eddygrinder/LaRE_LaTeX/chapters/chapter4.tex

% Chapter 4
\chapter{Implementação}
\label{Capítulo4}

\begin{flushright}
\textit{``Do or do not. There is no try.''} \\[0.5em]
--- Master Yoda, \textit{Star Wars - The Empire Strikes Back}
\end{flushright}

Este capítulo aprofunda os aspectos técnicos do LaRE, tomando como referência a arquitetura apresentada na Figura \ref{fig:arquitecturalore}. O desenvolvimento começou pela implementação e desenvolvimento do servidor Flask e página web, sendo que o primeiro circuito a ser implementado e testado foi a Lei de Ohm. O projecto foi evoluindo com a adição dos restantes circuitos que compõem o \acrshort{lare}. Para o desenvolvimento do \textit{software}, utilizou-se o \acrshort{ide} Visual Studio Code\footnote{\url{https://code.visualstudio.com/}}, e o projecto encontra-se alojado no GitHub. O sistema operativo instalado no \gls{RaspberryPI} é uma versão ligeiramente modificada do Arch Linux ARM. Os circuitos que compõem o \acrshort{lare} foram testados e validados individualmente em \textit{breadboards}, antes de se proceder à construção da matriz de placas, como referido na subsecção \ref{sec:matriz}. No Anexo~\ref{AppendixA} encontram-se os esquemas completos de todas as experiências, bem como o desenho das placas que compõem a matriz do \acrshort{lare}. Esta matriz foi organizada em três placas distintas: uma dedicada à experiência da Lei de Ohm, outra às experiências de rectificação e filtragem e uma terceira exclusivamente responsável pelas fontes de alimentação.

\section{Hardware}
\subsection{Relés}
\label{sec:hwreles}
Como já foi referido na subsecção \ref{sec:solucaoproposta}, o \acrshort{lare} é composto por cinco circuitos. A implementação começou com o desenho esquemático e, tal como referido na Secção \ref{sec:reles}, tentou-se, sempre que possível, utilizar os relés \acrshort{spst} no comando das fontes e aparelhos de medida e os relés \acrshort{dpst} no controlo dos componentes, tal como se pode ver no exemplo ilustrado na Figura \ref{fig:relespstdpst}. O relé K4 - \acrshort{spst} - comanda a fonte de alimentação de \SI{5}{\volt} e os relés K1 a K3 - \acrshort{dpst} - comandam os componentes. Os esquemas completos de cada circuito podem ser consultados no Anexo~\ref{AppendixA}.

\begin{figure}[hbtp]
	\centering
	
	\caption{Exemplo de utilização de relés \acrshort{spst} e \acrshort{dpst}}
	\label{fig:relespstdpst}
\end{figure}

\subsection{\textit{Driver} de relés}
\label{sec:driverreles}
Conforme referido na subsecção \ref{sec:driver}, o \gls{RaspberryPI} não tem capacidade para comandar directamente os relés. Para esse efeito, é necessário utilizar um \textit{driver} de relés. A Figura~\ref{fig:diagramablocos2003} apresenta o diagrama simplificado correspondente a um canal de entrada e saída do \textit{driver} \cite{ULN2003}.

\begin{figure}[hbtp]
	\centering
	
	\caption{Diagrama de blocos simplificado do ULN2003A}
	\label{fig:diagramablocos2003}
\end{figure}

O terminal 9, designado por COM, deve ser ligado à tensão de alimentação dos relés - \SI{12}{\volt} no caso dos utilizados neste projecto - e destina-se aos díodos de ``roda livre'', conforme descrito na subsecção~\ref{sec:reles}. As Figuras \ref{fig:comandorelesfull} e \ref{fig:exemplovoltimetro} servem como exemplos práticos ilustrando o funcionamento do procedimento referido na Figura \ref{fig:esquematico74hc595}. Neste exemplo, foi utilizado um relé \acrshort{spst}. No entanto, o funcionamento é idêntico para os relés \acrshort{dpst}, variando apenas a disposição dos pinos.

\begin{figure}[hbtp]
	\centering%
		\centering
		\subfloat[\centering Ligação SN74HC595 - ULN2003A\label{fig:comandorelesfull}]{{ }}%
		\qquad
		\subfloat[\centering Exemplo comando do voltímetro\label{fig:exemplovoltimetro}]{{ }}%
		\caption{Exemplo de uso do SN74HC595 e ULN2003A}%
		\label{fig:ligacao5952003}%
	\end{figure}

\begin{figure}[hbtp]
	\centering
	
	\caption{Envio de \textit{bits} para o registo de deslocamento}
	\label{fig:esquematico74hc595}
\end{figure}

As entradas $I_{1}$ a $I_{7}$ recebem os \textit{bits} enviados pelo \gls{RaspberryPI} através do registo de deslocamento, conforme apresentado na Figura \ref{fig:comandorelesfull}. As saídas $O_{1}$ a $O_{7}$ controlam os relés nos terminais ``3'', enquanto os terminais ``2'' dos relés são ligados aos \SI{12}{\volt}, como ilustrado na Figura \ref{fig:exemplovoltimetro}. No caso específico do exemplo acima descrito, se $I_{5} = \SI{0}{\volt}$, então a saída $O_{5} = \SI{12}{\volt}$, não existindo diferença de potencial entre os terminais ``2'' e ``3'' da bobina do relé ``K5''. Nesse cenário, o relé permanece desactivado. Por outro lado, se $I_{5} = \SI{12}{\volt}$, a saída $O_{5} = \SI{0}{\volt}$, estabelecendo-se uma diferença de potencial nos terminais da bobina, o que provoca a activação do relé. No caso em que a \textit{string} a ser transmitida for maior que 8 \textit{bits}, há a necessidade de usar mais do que um registo de deslocamento. Neste caso, o pino 9 - $Q_{H}'$ - do primeiro registo é ligado ao pino \acrshort{ser} do segundo registo e assim sucessivamente.

\subsection{Registo de deslocamento}
\label{sec:hwregistodeslocamento}
O SN74HC595 é um registo de deslocamento de 8 \textit{bits} do tipo \acrshort{sipo}, cujo funcionamento já foi detalhado na subsecção \ref{sec:registodeslocamento}. Uma \textit{string} de (até 8) \textit{bits} é enviada pelo \gls{RaspberryPI} para o registo através do pino \acrshort{ser}. Na Figura \ref{fig:esquematico74hc595} pode ver-se o diagrama explicativo do processo de envio:

\begin{enumerate}
	\item Pinos \acrshort{oe} e \acrshort{srclr} activados;
	\item Um \textit{bit} ``0'' ou ``1'' é enviado para o pino \acrshort{ser};
	\item \textit{N} impulsos ascendentes no pino \acrshort{srclk} fazem com que o \textit{N bits} sejam enviados para o registo de deslocamento (\textit{N bits} <= 8);
	\item Um impulso ascendente no pino \acrshort{rclk} faz com que os \textit{N bits} sejam enviados para o registo de memória e, por conseguinte, para os relés (através do ULN2003A).
\end{enumerate}

\subsection{Fontes de alimentação}
\label{sec:fontesalimentacao}
O \acrshort{lare} utiliza várias fontes de alimentação, todas passíveis de serem controladas por \textit{software} e neste aspecto tentou-se simplificar/limitar o uso de fontes externas, além das que poderiam ser fornecidas pelo \acrshort{virtualbench}. 

Como pode ser visto na Figura \ref{fig:paineldianteiro} ou na Figura \ref{fig:promenorfontes} com mais pormenor, o \acrshort{virtualbench} possuí três fontes de alimentação (\acrshort{cc} variáveis): \SI{+6}{\volt}, \SI{+25}{\volt} e \SI{-25}{\volt}\footnote{No contexto do \acrshort{lare} a fonte de tensão negativa não é usada.}.

\begin{figure}[hbtp]
	\centering
	
	\caption{Fontes de tensão do \acrshort{virtualbench}}
	\label{fig:promenorfontes}
\end{figure}

Assim, referente ao \acrshort{virtualbench} e à Figura~\ref{fig:promenorfontes}, o \acrshort{lare} utiliza as seguintes fontes de alimentação:
\begin{itemize}
	\item \SI{6}{\volt} (\acrshort{cc}), utilizada na experiência da Lei de Ohm;
	\item \SI{25}{\volt} (\acrshort{cc}), utilizada na alimentação dos relés e dos \textit{drivers}.
\end{itemize}

No entanto, ainda são necessárias mais duas fontes de alimentação, nomeadamente:
\begin{itemize}
	\item \SI{5}{\volt} (\acrshort{cc}), fonte projectada com recurso ao LM317 e com tensão de entrada obtida a partir da fonte de \SI{25}{\volt} - utilizada na alimentação dos registos de deslocamento;
	\item Para o estudo dos circuitos rectificação e filtragem, foi utilizado um transformador \SI{230}{\volt}/\SI{8}{\volt} \acrshort{ca}, disponível em contexto laboratorial e que se mostrou adequado aos objectivos trabalho.
\end{itemize}

\subsubsection{Fonte de tensão \SI{6}{\volt} - variável e fonte de tensão \SI{12}{\volt} - fixa}
\label{sec:fontes6-12}
As fontes de \SI{6}{\volt} e \SI{25}{\volt} são configuradas por \textit{software}. A primeira, utilizada na experiência da Lei de Ohm, varia entre \SI{1}{\volt} e \SI{6}{\volt}, enquanto a segunda é ajustada para fornecer \SI{12}{\volt}. Mais detalhes sobre estas configurações são apresentados na subsecção~\ref{sec:configmedicaoes} e os esquemas consultados no Anexo~\ref{AppendixA}.

\begin{figure}[hbtp]
	\centering%
		\centering
		\subfloat[\centering Introdução\label{fig:schfonte5VB}]{{ }}%
		\qquad
		\subfloat[\centering Controlo\label{fig:schfonte12VB}]{{ }}%
		\caption{Implementação fontes de \SI{6}{\volt} e \SI{12}{\volt}}%
		\label{fig:fontes6-12}%
	\end{figure}

As Figuras \ref{fig:schfonte5VB} e \ref{fig:schfonte12VB} ilustram os exemplos das ligações das respetivas fontes de tensão. Complementando com a Figura \ref{fig:promenorfontes}, o terminal ``1'' do relé $K_{4}$, designado por $5V_{VB}$, está ligado ao terminal de \SI{6}{\volt} do \acrshort{virtualbench}, enquanto a alimentação dos relés -  terminais ``2'' e a alimentação dos \textit{drivers} -  terminais ``9'' , estão ligados ao terminal de \SI{25}{\volt}. 

\subsubsection{Fonte de tensão \SI{5}{\volt} - fixa}
De forma a alimentar os circuitos com \SI{5}{\volt} fixos foi projectada - Figura \ref{fig:esqlm317} e implementada - Figura \ref{fig:impllm317} - uma fonte de alimentação \cite{LM317}.

\begin{figure}[hbtp]
	\centering%
		\centering
		\subfloat[\centering Esquemático\label{fig:esqlm317}]{{ }}%
		\qquad
		\subfloat[\centering Implementação\label{fig:impllm317}]{{ }}%
		\caption{Fonte de \SI{5}{\volt} \textins{LM317}}%
		\label{fig:fonte5V}%
	\end{figure}

Esta fonte teve como base o LM317 e o esquema presente na página 11, Figura 9, do \textit{datasheet} \cite{LM317}. A utilização do LM317 em detrimento, por exemplo, do LM7805 prendeu-se com a disponibilidade do regulador em contexto laboratorial. Este regulador serve perfeitamente os propósitos deste projecto, já que a tensão de saída, regulável, varia entre os \SI{1,25}{\volt} e os \SI{37}{\volt} e a corrente de saída pode ser superior a \SI{1,5}{\ampere}. 

Relativamente aos díodos de protecção, $D_{1}$ e $D_{2}$, representados no esquema da Figura \ref{fig:fonte5V}, em vez de se usarem os díodos 1N4002, por uma questão de disponibilidade dos componentes, usaram-se os díodos 1N4007. Estes díodos pertencem à mesma família de diodos retificadores da série 1N400x. Ambos têm especificações elétricas e mecânicas semelhantes, nomeadamente, a capacidade de suportar correntes directas até \SI{1}{\ampere} - valor suficiente para o nosso projecto que, relembre-se, é limitado pelo \acrshort{virtualbench} a \SI{0,5}{\ampere}. No entanto, a principal diferença entre eles está na tensão inversa máxima que cada modelo é capaz de suportar \cite{1N400x}:

\begin{itemize}
	\item 1N4002: Possui uma tensão inversa máxima de 100 V;
	\item 1N4007: Suporta uma tensão inversa máxima de 1000 V.
\end{itemize}

Estes valores são, pois, mais que suficientes para os níveis de tensão usados.

Sendo assim, para uma tensão de saída de \SI{5}{\volt}, calcularam-se as resistências com base na expressão apresentada do \textit{datasheet}, representada na Equação \ref{eq:calculolm317}: 

\begin{equation} \label{eq:calculolm317}
	V_{O} = V_{REF} (1 + \frac{R_{2}}{R_{1}}) + (I_{ADJ} \times R_{2})
\end{equation}

De notar que, segundo o \textit{datasheet} do LM317 \cite{LM317}, $V_{REF} = \SI{1,25}{\volt}$ e o valor do termo $I_{ADJ} \times R_{2}$ pode ser simplificado. De facto, $I_{ADJ}$ é, tipicamente, \SI{50}{\micro\ampere}, sendo que, para o nosso projecto, o valor escolhido para $R_{2}$ foi de \SI{1}{\kilo\ohm}. Assim, segundo a Equação \ref{eq:simplificação}, tem-se que:

\begin{equation} \label{eq:simplificação}
	V_{ADJ} = I_{ADJ} \times R_{2} = \SI{0,05}{\volt}
\end{equation}

A Equação \ref{eq:calculolm317} fica então reduzida a:

\begin{equation} \label{eq:calculoR1simplificado}
	V_{O} = V_{REF} (1 + \frac{R_{2}}{R_{1}})
\end{equation}

Considerando $V_{O} = \SI{5}{\volt}$, e uma vez que a Equação \ref{eq:calculoR1simplificado} tem duas incógnitas, $R_{1}$ e $R_{2}$, atribuiu-se a $R_{2}$ o valor de \SI{1}{\kilo\ohm}, tal como foi dito anteriormente. Desta forma, obteve-se $R_{1} = \SI{333,33(3)}{\ohm}$, tal como descrito na Equação \ref{eq:calculoR1}: 

\begin{equation} \label{eq:calculoR1}
	\SI{5}{\volt} = 1,25 \times (1 + \frac{1000}{R_{1}}) \Leftrightarrow R_{1} = \SI{333,33(3)}{\ohm}
\end{equation}

O valor da resistência normalizada mais próxima é de \SI{330}{\ohm}. Importa, pois, reverter a Equação \ref{eq:calculoR1simplificado} e confirmar o valor de  $V_{O}$ obtido:

\begin{equation} \label{eq:confirmacaoVout}
	V_{O} = 1,25 \times (1 + \frac{1000}{330}) \Leftrightarrow V_{O} = \SI{5,037(87)}{\volt}
\end{equation}

Portanto, este é um valor perfeitamente aceitável para alimentar os circuitos integrados.

\subsubsection{Fontes de tensão \SI{230}{\volt}/\SI{8}{\volt} CA}
\label{sec:fontealternada}
As experiências respeitantes aos rectificadores e filtros utilizam tensão alternada sinusoidal. Tal como já foi referido anteriormente, tentou-se, sempre que possível, simplificar o uso de fontes externas. 

Na prática e em contexto de sala de aula, a experiência de rectificação de onda completa levanta um problema de massas, se se pretender usar um gerador de sinal. Quer isto dizer que não é possível medir, simultaneamente, os sinais de entrada e saída. Como se pode ver pelo esquema representado na Figura \ref{fig:gerador-massa}, o díodo está curto-circuitado (linha magenta a tracejado, entre os pontos 2 e 3) devido ao facto de as massas serem comuns. 

\begin{figure}[hbtp]
	\centering
	
	\caption{Problema de massa - onda completa}
	\label{fig:gerador-massa}
\end{figure}

A forma de contornar este problema é usar um transformador e, assim, medir a onda de saída com o osciloscópio. Ainda assim, não é possível medir as ondas de entrada e saída \textbf{simultaneamente}, se for esse o objectivo.

No caso do \acrshort{lare}, e com recurso ao uso de relés, é possível controlar a massa dos dois canais do osciloscópio por \textit{software}, tal como representado no esquema simplificado da Figura \ref{fig:ondacompleta-massa} e representar as duas ondas (entrada e saída) na mesma imagem. De referir que, desta forma, seria possível usar o gerador de sinal. No entanto, o uso do transformador justifica-se pelas seguintes razões:
\begin{itemize}
	\item Facilidade e simplicidade em controlar as massas por \textit{software} - três, no caso do uso do gerador de sinal ($CH_{1-}$, $CH_{2-}$ e $VG_{-}$), ou duas, no caso de se usar um transformador ($CH_{1-}$, $CH_{2-}$);
	\item Em contexto laboratorial e de sala de aula, usa-se um transformador para rectificar a onda completa.
\end{itemize}

%No entanto, para o estudo da rectificação da onda completa, tal não foi possível. Enquanto que no rectificador de meia-onda (... e filtros) é possível usar o gerador de sinal do \acrshort{virtualbench} para medir as ondas de entrada e saída simultaneamente, tal não é possível na rectificação de onda completa, devido ao problema das massas e consequente curto-circuito do díodo na ponte rectificadora. 
%Este problema está representado na Figura \ref{fig:ondacompleta-massa}

\begin{figure}[hbtp]
	\centering
	
	\caption{Problema de massa - onda completa [Resolvido]}
	\label{fig:ondacompleta-massa}
\end{figure}

O esquema completo da experiência de rectificação de onda completa pode ser consultado no Anexo~\ref{AppendixA}.

%$CH_{1-}$ e $CH_{2-}$ são as massas do gerador de sinal e osciloscópio (dois canais), respectivamente. É fácil perceber que estando ligados ao mesmo aparelho de medida, neste caso o \acrshort{virtualbench}, as massas dos dois canais do osciloscópio são comuns e, por isso, entre os pontos 2 e 3, o díodo está curto-circuitado. 

%No que concerne à fonte de alimentação \acrshort{ca}, esta foi implementada de forma independente do \acrshort{virtualbench}. \textbf{Falar sobre a fonte de alimentação variável e a fonte de alimentação \acrshort{ca}. Colocar a foto do esquema e explicar como se faz a rectificação, cálculos inclusive. Talvez referir o facto de que depende da qualidade e valores dos transformadores e depois concluir com os valores deste caso, pode-se referir que relativamente à fonte AC, só está disponível a fonte do gerador de sinal do VB e é mais fácil controlar através da fonte externa projectada.}

\subsection{Aparelhos de medida - voltímetro e amperímetro}
\label{sec:aparelhosmedida}

A medição de tensão e corrente são feitas utilizando o multímetro digital - \Acrfull{dmm} - PXI-4072, referenciado na subsecção \ref{sec:visir}, Figura \ref{fig:PXI-4072} e cujo painel frontal está representado na Figura \ref{fig:frontDMM}.

\begin{figure}[hbtp]
	\centering
	
	\caption{Painel frontal Multímetro Digital}
	\label{fig:frontDMM}
\end{figure}

Na Figura \ref{fig:esq_geral_ohm} está representado o esquema simplificado da Lei de Ohm que pode ilustrar o funcionamento dos aparelhos de medida. O ponto C é comum e é controlado pelo relé $K_{7}$. O terminal positivo do voltímetro está ligado ao ponto A, controlado pelo relé $K_{5}$ mas o amperímetro necessita de mais um relé, já que é inserido em série. Neste caso o relé $K_{8}$ funciona como um \textit{bypass} quando se pretende medir tensão e o relé $K{6}$ controla o terminal positivo do amperímetro. 

\begin{figure}[hbtp]
	\centering%
		\centering
		\subfloat[\centering Esquema implementado\label{fig:esq_geral_ohm}]{{ }}%
		\qquad
		\subfloat[\centering Esquema com os relés duplos\label{fig:full_reles}]{{ }}%
		\caption{Esquema completo - Lei de Ohm}%
		\label{fig:}%
	\end{figure}

No entanto, faz-se notar o seguinte: embora os aparelhos de medida sejam independentes, partilham a mesma massa. Esta escolha foi motivada pela indisponibilidade de relés duplos em contexto laboratorial, pelo que se optou por fazer a gestão da forma a que o propósito do projecto fosse atingido e o conceito provado. Na Figura \ref{fig:full_reles} apresenta-se o esquema simplificado, com os relés duplos, adicionados aos aparelhos de medida. 

De referir que, se se pretender expandir o \acrshort{lare} com mais circuitos, é possível utilizar o voltímetro e o amperímetro da forma como estão implementados. A Tabela \ref{Table:exemplomedicaoohm} apresenta o estado dos relés, $K_{5}$ a $K_{8}$ consoante a grandeza que se pretende medir.

\begin{table}[htb]
	\centering
	\caption{Exemplo funcionamento de medição da Lei de Ohm} 
	
	\label{Table:exemplomedicaoohm}
	\begin{tabular}{lcccccccc}
		\toprule
		               & \multicolumn{8}{c}{Estado dos relés}                                                                       \\
		\midrule
		               & $K_{1}$                              & $K_{2}$ & $K_{3}$ & $K_{4}$ & $K_{5}$ & $K_{6}$ & $K_{7}$ & $K_{8}$ \\
		\midrule
		Medir Tensão   & 1                                    & 0       & 0       & 1       & 1       & 0       & 1       & 1       \\
		\midrule
		Medir Corrente & 1                                    & 0       & 0       & 1       & 0       & 1       & 1       & 0       \\
		\bottomrule
	\end{tabular}
\end{table}

\subsection{Experiências}
\label{sec:experiencias}
De forma a permitir um melhor desenvolvimento, foco, organização, detecção e correcção de erros, as experiências foram implementadas de forma independente. As primeiras ideias passavam por, além da Lei de Ohm, implementar o estudo da rectificação de meia e onda completa. Contudo, verificou-se que seria possível incluir uma experiência adicional, dedicada ao estudo prático de filtros passa-alto e passa-baixo, já que estas duas experiências possuem componentes comuns, ampliando, assim, o alcance e a aplicabilidade do \acrshort{lare}.

\begin{comment}
ESTA JUSTIFICAÇÃO DEVERIA FICAR NOUTRO LADO - VERIFICARq!!!!

	\textbf{NOTA: Colocar aqui uma imagem do lare completo, com vista dos conectores??? ou só os conectorres?}
Na Secção \ref{sec:fontesalimentacao}, foram já descritas todas as fontes de alimentação do \acrshort{lare}. Com base na Figura \ref{fig:rectificacao_filtragem_full}, o gerador de sinal é controlado pelo relé duplo $K_{1}$, enquanto o díodo é isolado através do relé duplo $K_{3}$ (representado pelo rectângulo tracejado a vermelho escuro).

No que respeita ao relé $K_{4}$, este seria, eventualmente, dispensável, uma vez que o terminal negativo do gerador de sinal é igualmente controlado por $K_{1}$. No entanto, considerando que os filtros (identificados pelo rectângulo tracejado a cor-de-laranja) são partilhados com os circuitos rectificadores, e prevendo a possibilidade de utilização do gerador de sinal noutra experiência, optou-se, por uma questão de segurança, pelo isolamento completo dos componentes através do relé $K_{4}$.
\end{comment}

\subsubsection{Lei de Ohm}
\label{sec:lei_ohm}
Na Figura~\ref{fig:esq_geral_ohm} apresenta-se o esquema simplificado da implementação prática da Lei de Ohm. O esquema completo pode ser consultado no Anexo~\ref{AppendixA}. A fonte de tensão e os aparelhos de medida foram projectados de forma a serem independentes, tal como é referido na subsecção \ref{sec:aparelhosmedida}, permitindo a sua utilização caso se pretenda expandir o \acrshort{lare} com mais experiências. A fonte de tensão pode ser utilizada desactivando $K_{5}$ e $K7$.
A fonte de tensão e os aparelhos de medida foram projectados de forma a serem independentes, tal como é referido na subsecção \ref{sec:aparelhosmedida}, permitindo a sua utilização caso se pretenda expandir o \acrshort{lare} com mais experiências. A fonte de tensão pode ser utilizada desactivando $K_{5}$ e $K7$. 

O funcionamento do circuito é relativamente simples, sendo que qualquer que seja a resistência a medir, é fechado o respectivo relé - $K_{1}$ ou $K_{2}$ ou $K_{3}$; a fonte $U_{CC}$ é ligada ao circuito através do relé $K_{4}$ e $K_{7}$. A medição da tensão e da corrente faz-se da seguinte forma:

\begin{itemize}
	\item Medição da tensão:
	      \begin{itemize}
		      \item Os relés $K_{5}$ e $K_{8}$ são fechados e $K_{6}$ é aberto (amperímetro desactivado). Desta forma, o voltímetro fica em paralelo com a resistência a medir - entre os pontos A e B.
	      \end{itemize}
	\item Medição da corrente:
	      \begin{itemize}
		      \item Os relés $K_{5}$ e $K_{8}$ são abertos (voltímetro desactivado) e $K_{6}$ é fechado. Desta forma, o amperímetro fica em série com a resistência a medir - entre os pontos B e C.
	      \end{itemize}
\end{itemize}

Como exemplo, se se pretender estudar a Lei de Ohm para a resistência $R_{1}$, os relés seriam activados da forma representada na Tabela \ref{Table:exemplomedicaoohm}:

\subsubsection{Rectificadores e filtros}
\label{sec:rectificadoresfiltros}
Uma vez que a implementação destas duas experiência foi realizada na mesma placa, além de que partilham componentes, optou-se por apresentá-las em conjunto. Na Figura \ref{fig:rectificacao_filtragem_full} estão representados os esquemas simplificados dos circuitos. Nela se podem ver os componentes comuns - rectângulo tracejado laranja - assim como os rectificadores de meia e onda completa - rectângulo tracejado vermelho e verde, respectivamente. Exclusivo dos filtros estão, também, representados, o condensador e resistência, no rectângulo tracejado magenta. O esquema completo encontra-se representado no Anexo \ref{AppendixA}.

\begin{figure}[hbtp]
	\centering
	
	\caption{Esquema completo (simplificado) - rectificadores e filtros}
	\label{fig:rectificacao_filtragem_full}
\end{figure}

Nesta implementação, foi necessário recorrer a dois tipos distintos de tensão de entrada. Como referido na subsecção~\ref{sec:fontesalimentacao}, o circuito de meia onda utiliza o gerador de sinal, mas, devido ao problema de massa já descrito nessa mesma secção, optou-se por utilizar um transformador no circuito de rectificação de onda completa.

Como referido na subsecção \ref{sec:experiencias}, a implementação dos filtros foi realizada após a conclusão dos rectificadores. De forma a permitir a integração desta experiência no circuito já concluído, foi necessário realizar um \textit{bypass} ao díodo $D_{1}$ (assinalado pelo retângulo tracejado a vermelho na Figura \ref{fig:rectificacao_filtragem_full}). Esta alteração permitiu a introdução de uma resistência ($R_{3}$) ou de um condensador ($C_{3}$), consoante a configuração do filtro em estudo. Os esquemas teóricos dos filtros estão representados nas Figuras \ref{fig:filtro_pb} e \ref{fig:filtro_pa}, sendo que $R$ e $C$  correspondem a $R_{3}$ e $C_{3}$. 

Portanto, se se pretender estudar o filtro passa-baixo, é activado o relé $K_{10}$ ($R_{3}$) e o condensador de saída pode ser escolhido entre os $C_{1}$ e $C_{2}$, consoante a configuração que se pretende estudar. O mesmo se aplica ao filtro passa-alto, onde o relé $K_{11}$ ($C_{3}$) é activado e a resistência de saída pode ser escolhida entre os $R_{1}$ e $R_{2}$. Na Tabela \ref{Table:rectificadoresfiltros} e com o auxílio da Figura \ref{fig:rectificacao_filtragem_full} (ou do circuito completo apresentado no Anexo \ref{AppendixA}), pode ver-se o estado dos relés, respeitante a uma combinação possível para cada circuito. 

\begin{table}[htb]
	\centering
	\caption{Exemplo funcionamento do rectificador de meia onda} 
	\label{Table:rectificadoresfiltros}
	\resizebox{\columnwidth}{!}{\begin{tabular}{lccccccccccccc}
		\toprule
		               & \multicolumn{13}{c}{Estado dos relés} \\
		\midrule
		               			& $K_{1}$ & $K_{2}$ & $K_{3}$ & $K_{4}$ & $K_{5}$ & $K_{6}$ & $K_{7}$ & $K_{8}$ & $K_{9}$ & $K_{10}$ & $K_{11}$ & $K_{12}$ & $K_{13}$\\
		\midrule
		Meia Onda      			& 1		 	& 0       	& 1       & 1       & 0       & 1       & 1       & 0 	   & 0     		& 0       & 0       & 0 	   & 0 \\
		\midrule
		Onda Completa  			& 0 	 	& 1       	& 0       & 0       & 1       & 0       & 0       & 1  	   & 1    		& 0       & 0       & 1 	   & 1\\
		\midrule
		Filtro Passa-Alto      	& 1		 	& 0       	& 0       & 1       & 0       & 0       & 1       & 0 	   & 0    		& 1       & 0       & 1 	   & 1\\
		\midrule
		Filtro Passa-Baixo      & 1		 	& 0       	& 0       & 1       & 0       & 0       & 0       & 1 	   & 0    		& 0       & 1       & 1 	   & 1\\
		\bottomrule
	\end{tabular}}
\end{table}

\section{Software}
\label{sec:implementacaosoftware}
Hoje em dia vive-se (n)uma Era em que toda a informação está disponível na ``ponta dos dedos'' e à distância de um \textit{click}. A pesquisa, desenvolvimento e testes dos assuntos mais técnicos revelou-se um processo exigente e, por vezes, moroso. A abundância dos recursos disponíveis colocou o desafio adicional de tentar perceber a dicotomia certo/errado. No apoio a este processo, recorreu-se à Inteligência Artificial, documentação técnica \textit{online}, fóruns de discussão, ajuda pessoal, tutoriais \textit{online} e vídeos no YouTube.

Este projecto de código fonte aberto está dividido em dois repositórios, disponíveis para consulta e modificação sob a licença \acrfull{gpl3} no GitHub: \href{https://github.com/eddygrinder/LaRE}{LaRE} e \href{https://github.com/eddygrinder/LaRE_PICode}{PICode}. Assim, os ficheiros são referenciados relativamente ao respectivo repositório. Ao longo deste capítulo, sempre que se justificar e para fins de clareza, será apresentado o código necessário - em pequenos trechos - de forma a melhor ilustrar os conceitos discutidos. Não se pretende, contudo, abordar exaustivamente todas as instruções ou métodos de configuração do \acrshort{virtualbench}, uma vez que os ficheiros se encontram comentados, sendo possível obter informações adicionais através da sua consulta. 

\subsection{Servidor Flask}
\label{sec:flask}
Na subsecção \ref{sec:back-end} foram já referidas as razões que levaram à escolha do Flask como servidor web. A base para a implementação do Flask teve como base e referência a documentação técnica disponível no \textit{site} do Flask \cite{Flask} e complementada com alguns tutoriais do Youtube \cite{tutorialsiteflask, flaskDigitalOcean}.

\subsubsection{Estrutura base}
O fluxograma apresentado na Figura \ref{fig:funcflask} apresenta o funcionamento geral do servidor Flask.

\begin{figure}[hbtp]
	\centering
	
	\caption{Funcionamento geral Flask}
	\label{fig:funcflask}
\end{figure}

A estrutura de directórios do Flask tem uma base pré-definida que não é necessariamente rígida e pode ser adaptada consoante os requisitos do projecto \cite{Flask}. No caso do \acrshort{lare} a estrutura ficou organizada da forma como se mostra na Figura \ref{fig:estruturapastas}.

\begin{figure}[hbtp]
	\centering
	
	\caption{Estrutura de directórios - Flask}
	\label{fig:estruturapastas}
\end{figure}

A raiz do projecto é o directório ``\textit{webserver}'' e nele estão contidos o ficheiro principal, assim como outros directórios e ficheiros de configuração essenciais:
\begin{itemize}
	\item \textit{main.py}: O ficheiro principal do aplicativo que inicializa e configura o Flask;
	\item \textit{requirements.txt}: Uma lista de dependências do projecto que podem ser instaladas usando \gls{pip};
	\item \textit{static/}: Este directório contém os ficheiros estáticos como \acrshort{css}, JavaScript e as imagens usadas em toda a aplicação;
	\item \textit{templates/}: Contém os modelos \acrshort{html} usado para renderizar as visualizações;
	\item \textit{instance/}: Directório para armazenar ficheiros de configuração ou ficheiros que mudam em tempo de execução, específicos da cada instância, por exemplo, ficheiros da base de dados.
\end{itemize}

Dentro da raiz, criou-se o directório \textit{website} onde se incluiu os ficheiros respeitantes ao funcionamento do \textit{site}. Dele constam os já descritos \textit{templates}, \textit{static} e ainda os seguintes ficheiros:

\begin{itemize}
	\item \textit{\_\_init\_\_.py}: Inicializa o Flask e define as configurações. Este ficheiro dentro da directoria \textit{website} faz com que esta seja tratada como um pacote Python. Isto quer dizer que a directoria pode ser importada e tudo o que estiver dentro é executado automaticamente;
	\item \textit{views.py}: Contém as funções de visualização para o tratamento de pedidos \acrfull{http};
	\item \textit{models.py}: Define os modelos de dados para a aplicação;
	\item \textit{auth.py}: Este ficheiro é responsável por lidar com a autenticação e autorização de utilizadores, pode incluir funções e rotas que permitem aos utilizadores registarem-se, fazer \textit{login} e fazer \textit{logout}.
\end{itemize}

\subsubsection{Rotas}
As aplicações web modernas utilizam \acrshort{url} amigáveis para ajudar os utilizadores a memorizar e utilizar o nome para voltar a visitar directamente uma página.

No Flask utiliza-se o \textit{decorator} \textit{\textbf{route()}} para associar uma função a um \acrshort{url}, tal como pode ser visto na Listagem \ref{lst:decoradorroute}.

\begin{minipage}{0.9\linewidth}
	\begin{lstlisting}[language=Python, caption=\textit{Decorator} \textit{route()} - \textit{views.py}, label=lst:decoradorroute]
@views.route("/ohm", methods=['GET', 'POST'])
@login_required
def pagina_seguinte():
    return render_template("ohm.html", user=current_user)
\end{lstlisting}
\end{minipage}

O \textit{decorator} \textit{\textbf{route}} define a rota correspondente à \acrshort{url} Ohm, a qual aceita pedidos \acrshort{http} de métodos GET e POST. Adicionalmente, o \textit{decorator} \textit{\textbf{login}} assegura que apenas utilizadores autenticados podem aceder a esta rota; caso contrário, o utilizador será redirecionado para a página de autenticação. Sempre que esta rota é invocada, a função \textbf{pagina\_seguinte()} é executada. Por fim, a última linha da função invoca o \textit{template} \textbf{ohm.html} e passa-lhe o objecto \textbf{current\_user}, permitindo personalizar a página com os dados do utilizador autenticado.

Para construir um \acrshort{url} para uma função específica, usa-se a função \textbf{url\_for()}. Esta função aceita o nome da função como seu primeiro argumento e qualquer número de argumentos de palavras-chave, cada um correspondendo a uma parte variável da regra de \acrshort{url}, tal como pode ser visto na Listagem \ref{lst:urlfor}.

\begin{minipage}{0.9\linewidth}
	\begin{lstlisting}[language=Python, caption=Contrução de \textit{url} - \textit{auth.py}, label=lst:urlfor]
(...)
if user:
    if check_password_hash(user.password, password):
        flash('Logged in successfully!', category='success')
        login_user(user, remember=True)
        return redirect(url_for('views.home'))
(...)
\end{lstlisting}
\end{minipage}

Isto quer dizer que o Flask gera a \acrshort{url} correspondente à função \textbf{home()} definida no ficheiro \textbf{views.py} dentro da \textit{Blueprint} \textit{views}. Quando usada dentro de \textit{\textbf{redirect}}, redireciona o utilizador para essa \acrshort{url}. No Flask, os \textit{decorators} são utilizados para associar funcionalidades adicionais a funções que representam rotas. Um \textit{decorator} é uma construção da linguagem Python que permite modificar o comportamento de uma função sem alterar o seu conteúdo. Ao utilizar @route, @login\_required e outros \textit{decorators}, o Flask cria uma camada adicional de lógica que é aplicada automaticamente antes (ou depois) da execução da função ``decorada''.

\subsubsection{\textit{Blueprints}}
O Flask usa um conceito de \textit{blueprints} para criar componentes de aplicações e suportar padrões comuns dentro de uma aplicação ou entre aplicações. As \textit{blueprints} podem simplificar muito o funcionamento de grandes aplicações e fornecer um meio central para que as extensões do Flask registem operações em aplicações. As \textit{blueprints} permitem organizar a aplicação em partes menores e de mais fácil gestão. O conceito básico das \textit{blueprints} é que registam as operações a executar quando são integrados numa aplicação. O Flask associa funções de vista (\textit{views}) a \textit{blueprints} quando processa pedidos e gera \acrshort{url} entre diferentes pontos de acesso. Na Listagem~\ref{lst:blueprintviews} e Listagem~\ref{lst:blueprintauth} podem ver-se as duas \textit{blueprints} definidas no caso da implementação do \acrshort{lare}.

\begin{center}
	\begin{minipage}{0.7\linewidth}
		\begin{lstlisting}[language=Python, caption=\textit{Blueprint views} - \textit{views.py}, label=lst:blueprintviews]
views = Blueprint('views', __name__)
\end{lstlisting}
	\end{minipage}
\end{center}

\begin{center}
	\begin{minipage}{0.7\linewidth}
		\begin{lstlisting}[language=Python, caption=\textit{Blueprint auth} - \textit{auth.py}, label=lst:blueprintauth]
auth = Blueprint('auth', __name__)
\end{lstlisting}
	\end{minipage}
\end{center}

Ambas as \textit{blueprints} são registadas no ficheiro \textit{\_\_init\_\_.py}, como se pode verificar na Listagem \ref{lst:initreg}

\begin{center}
	\begin{minipage}{0.7\linewidth}
		\begin{lstlisting}[language=Python, caption=Registo das \textit{blueprints} - \textit{\_\_init\_\_.py}, label=lst:initreg]
app.register_blueprint(views, url_prefix='/')
app.register_blueprint(auth, url_prefix='/')
\end{lstlisting}
	\end{minipage}
\end{center}

Isto quer dizer que, ao registar a \textit{blueprint} com o prefixo ``/'', os \acrshort{url} serão acessíveis através da raiz da aplicação.

\subsubsection{Pedidos}
A capacidade de uma aplicação web em responder a solicitações de dados do cliente é um requisito essencial. No Flask esta informação é fornecida pelo objecto global \textit{\textbf{request}}. Este objecto contém todos os detalhes da solicitação, como os métodos \acrshort{http} usados GET, POST, etc.), os \textit{headers} os \textit{cookies} ou o corpo da requisição. O método de requisição pode ser determinado através do atributo \textit{\textbf{method}}. Para aceder aos dados de um formulário (transmitidos numa requisição POST ou PUT), utiliza-se o atributo \textit{\textbf{form}}, tal como descrito no ficheiro \textbf{auth.py}. Quando se adiciona um ponto de interrogação (?) seguido de pares chave-valor (\textit{key}=\textit{value}) no final de um \acrshort{url}, está a enviar-se dados adicionais ao servidor, chamados de \textbf{parâmetros do \acrshort{url}}, como se pode ver na Listagem \ref{lst:paramurl}.

\begin{minipage}{0.9\linewidth}
	\begin{lstlisting}[language=Html, caption=Exemplo argumentos passados ao servidor - ohm.html, label=lst:paramurl]
const url = `/config_VirtualBench?parameter=${parameter}&Vcc=${Vcc}&R=${Resistance}`;
\end{lstlisting}
\end{minipage}

Como referido na subsecção~\ref{sec:jinja2}, a renderização das páginas \acrshort{html} é realizada através do motor Jinja. No caso específico do \acrshort{lare}, o Flask procura os modelos a renderizar na pasta \textit{templates}, conforme ilustrado na Figura~\ref{fig:estruturapastas}. Na página oficial do Flask é recomendado que se aceda aos parâmetros do \acrshort{url} com \textit{\textbf{get}} ou capturando o \textit{\textbf{KeyError}}, uma vez que os utilizadores podem alterar o \acrshort{url} e, nesse caso, apresentar uma página \textit{400 bad request} não é de fácil interpretação.

\subsubsection{Base de dados}
A aplicação desenvolvida usa uma base de dados e autenticação de utilizador. A ligação com a base de dados é aberta no início do pedido e é obtida a informação do utilizador. No final do pedido, a ligação com a base de dados é fechada. 

No contexto da documentação do Flask e implementação de uma base de dados, são apresentadas duas alternativas: SQLite 3 e SQLAlchemy. Tal como sugerido na documentação, usou-se a extensão Flask-SQLAlchemy, descrita no ficheiro \textit{\textunderscore\textunderscore init.py\textunderscore\textunderscore}.

\subsubsection{Autenticação}
A segurança da aplicação é assegurada através das funcionalidades de \textit{login} e \textit{logout}, implementadas no ficheiro \textit{auth.py}. Para esse fim, foi instalada a extensão \textit{flask-login} que simplifica a gestão de sessões de utilizadores ao permitir manter o estado autenticado entre diferentes requisições. Esta ferramenta disponibiliza métodos como \textbf{\textit{login\textunderscore user()}}, \textbf{\textit{logout\textunderscore user()}} e \textbf{\textit{current\textunderscore user}}, que simplificam a verificação e controlo do estado de autenticação. O processo de registo envolve a recolha de credenciais, como nome de utilizador e senha, garantindo o armazenamento seguro da senha através de \textbf{\textit{hashing}} com \textbf{\textit{generate\textunderscore password\textunderscore hash}}. No \textit{login}, a aplicação verifica as credenciais fornecidas, compara a senha inserida com a armazenada usando \textbf{\textit{check\textunderscore password\textunderscore hash}} e, se for válida, inicia a sessão do utilizador. Além disso, certas rotas são protegidas para garantir que apenas utilizadores autenticados as possam aceder, utilizando o \textit{decorator} \textbf{\textit{@login\textunderscore required}}, que redireciona utilizadores não autenticados para a página de \textit{login}. A gestão de sessões é feita através de \textit{cookies} seguros, permitindo ainda a funcionalidade de lembrar a sessão entre reinícios do navegador, caso seja activado o parâmetro \textbf{\textit{remember=True}} no \textbf{\textit{login\textunderscore user}}. 

Devido à complexidade da implementação de uma verificação por \textit{email}, a aplicação restringe-se à autenticação baseada apenas no nome de utilizador e senha. A inclusão desse mecanismo exigiria um serviço de envio de \textit{emails} e a gestão de \textit{tokens} de confirmação.

\subsection{Arquitectura de comunicação}
\label{sec:comunicacao}
Nesta subssecção, o foco será analisar a comunicação (e troca de parâmetros) entre os diversos tipos de ficheiros. Na Figura \ref{fig:diagramasimplificado} é apresentado o diagrama simplificado que ilustra o funcionamento geral deste tipo de comunicação. 

\begin{figure}[hbtp]
	\centering
	
	\caption{Diagrama de comunicação simplificado}
	\label{fig:diagramasimplificado}
\end{figure}

A arquitectura do sistema é composta por múltiplos ficheiros que comunicam entre si, englobando a troca de parâmetros. O critério utilizado foi o de tornar o ficheiro \textit{views.py} o mais leve e simples possível, mantendo-se o comando e controlo dos dispostivos em ficheiros separados.

Como mencionado na subsecção \ref{sec:flask}, a estrutura de directórios do Flask possui uma base pré-definida, mas suficientemente flexível para ser adaptada conforme os requisitos específicos do projecto, como ilustrado na Figura \ref{fig:estruturapastas}. De uma forma geral, foram criados ficheiros específicos para cada experiência, adoptando o critério de evitar uma excessiva modularização do código. Embora esta prática ofereça vantagens, também apresenta as suas desvantagens - devido à fragmentação excessiva - já que pode tornar a compreensão e manutenção do código mais complexa.

Os seguintes ficheiros foram criados e associados às respectivas experiências:
\\[1em]
\textbf{Específicos}
\begin{itemize}
	\item \textit{config.py} - Lei de Ohm;
	\item \textit{mixed\_signal\_oscilloscope.py} - Rectificadores/Filtros;
	\item \textins{ohm, meiaonda, ondacompleta, passaalto, passabaixo}.html - Visualização.
\end{itemize}

\textbf{Comuns}
\begin{itemize}
	\item \textit{views.py} - parte central da aplicação, pois nele estão definidas todas as rotas Flask. Quer isto dizer que, cada rota representa uma funcionalidade ou página web específica e qualquer troca de dados ou argumentos entre ficheiros e/ou \textit{scripts}, passa obrigatoriamente por este ficheiro. Sendo assim, tentou-se, sempre que possível, reduzir o código ao estritamente necessário;
	\item \textit{configRelays.py} - ficheiro responsável pelo envio da \textit{string} para o \gls{RaspberryPI}.
	\item \textins{login, base, sign\_up}.html - páginas de autenticação e registo de utilizadores.
\end{itemize}

\subsubsection{Comunicação entre ficheiros}
\label{sec:comunicacaoentrefich}
A comunicação entre as páginas \acrshort{html} e o ficheiro Python\footnote{Pode-se, neste caso, reduzir a comunicação ao caso mais geral de troca de informação entre ficheiros \acrshort{html} e Python, já que, no fundo, o ficheiro \textit{views.py} está escrito em Python.} é feita nos dois sentidos - setas amarelas - já que os utilizadores enviam os parâmetros específicos de cada experiência e os resultados são apresentados nas páginas. 

A Listagem \ref{lst:htmlpy} ilustra a forma como os parâmetros são enviados da página \acrshort{html} para o ficheiro Python, através de uma \textit{query string}.

\begin{minipage}{0.9\linewidth}
	\begin{lstlisting}[language=html, escapechar=|, caption=Envio de parâmetros \acrshort{html} $\rightarrow$ \textit{views.py}, label=lst:htmlpy]
	const url = `/config_VirtualBench?variavel_1=${parametro_1}&variavel_2=${parametro_2}&variavel_3=${parametro_3}`; |\label{line:parametros}|
	\end{lstlisting}
\end{minipage}

Do lado do servidor, o Flask disponibiliza o objecto \textit{request}, a partir do qual os parâmetros enviados por \acrshort{url} podem ser acedidos através da função \textit{request.args.get()}, como representado na Listagem~\ref{lst:metodorequest}.

\begin{minipage}{0.9\linewidth}
	\begin{lstlisting}[language=python, escapechar=|, caption=Recepção de parâmetros, label=lst:metodorequest]
		Vcc = request.args.get('parametro_1', 0, int)  |\label{line:vccrequest}|
	\end{lstlisting}
\end{minipage}

O envio de parâmetros do ficheiro Python para as páginas \acrshort{html} é feito em \acrfull{json}, usando a instrução definida na Listagem \ref{lst:returnjson}.

\begin{minipage}{0.9\linewidth}
	\begin{lstlisting}[language=python, escapechar=|, caption=Envio de parâmetros \textit{views.py} $\rightarrow$ \acrshort{html}, label=lst:returnjson]
		return jsonify({'measurement_result': measurement_result})
	\end{lstlisting}
\end{minipage}

Do lado das páginas \acrshort{html} a recepção do resultado é feita através do método \textit{fetch()}, como se pode ver na Listagem \ref{lst:recepcaojson}.

\begin{minipage}{0.9\linewidth}
	\begin{lstlisting}[language=html, escapechar=|, caption=Recepção de parâmetros, label=lst:recepcaojson]
		fetch(url)
		.then((response) => response.json())
		// Aceder a variavel measurement_result
		.then((data) => {
		  document.getElementById("current-measure").innerHTML = 
		  	data.measurement_result + " mA";	
		\end{lstlisting}
\end{minipage}

As setas verdes representam a comunicação entre dois ficheiros Python. O processo é bastante simples, bastando para isso, importar o ficheiro que contém a função que se pretende chamar. A Lista \ref{lst:pypy} ilustra a forma como se importa um ficheiro Python e a chamada da respectiva função com o parâmetro a passar.

\begin{minipage}{0.9\linewidth}
	\begin{lstlisting}[language=python, escapechar=|, caption=Comunicação Python - Python, label=lst:pypy]
		from ctrl_hardware import configRelays, configVB, mixed_signal_oscilloscope |\label{line:ficheiros}|
		configRelays.config_relays_ohm(Resistance, measure_parameter) |\label{line:trueparameter}|
	\end{lstlisting}
\end{minipage}

No entanto, o processo de medição na experiência da Lei de Ohm possui características específicas que justificam uma explicação detalhada. A Figura~\ref{fig:processoleituraUI} ilustra o procedimento de leitura das medições de tensão e corrente.

\begin{figure}[hbtp]
	\centering
	
	\caption{Processo de leitura das medições de tensão e corrente}
	\label{fig:processoleituraUI}
\end{figure}

As setas a verde e vermelho representam o fluxo do processo iniciado pelo utilizador ao solicitar uma medição. Este ciclo repete-se cinco vezes para cada grandeza (tensão e corrente). No entanto, como o ficheiro \textit{configVB.py} é executado de forma independente em cada chamada, num total de dez execuções, os valores medidos não são retidos entre invocações sucessivas. Para contornar esta limitação e garantir a persistência das medições ao longo das múltiplas chamadas à \acrshort{api}, sem recorrer a mecanismos clássicos de persistência, como ficheiros \textit{.json}, \textit{.csv} ou bases de dados locais — os quais implicariam operações adicionais de escrita e leitura no sistema de ficheiros — foi desenvolvido um módulo auxiliar em Python, implementado no ficheiro \textit{store\_ps\_dmm.py}. Este módulo utiliza variáveis globais como mecanismo de armazenamento em memória. Os valores de tensão e corrente são armazenados num \textit{array} através da função \textit{np.append}, da biblioteca NumPy \cite{NumPy}. Dado que o servidor Flask se mantém activo durante todo o processo de medição, as variáveis globais permanecem acessíveis em memória entre chamadas à \acrshort{api}. Esta abordagem simplifica a gestão do estado da aplicação numa fase inicial de desenvolvimento, sendo eficaz enquanto o processo da aplicação não for reiniciado.

\subsubsection{Comunicação com Raspberry PI}
\label{sec:raspberrypi}
Do lado do \gls{RaspberryPI}, embora de uma forma mais simples, também se usou a premissa de modularização do código, tal como referido na subsecção \ref{sec:comunicacao}. Este ficou dividido em dois ficheiros:
\begin{itemize}
	\item \textit{receive.py} - recebe a \textit{string};
	\item \textit{shift\textunderscore register.py} - responsável por activar os relés.
\end{itemize}

A comunicação com o \gls{RaspberryPI} é estabelecida através de \textit{sockets}, um método já descrito na Secção~\ref{sec:arquitectura}. Após a configuração e teste dos parâmetros, uma \textit{string} representando o número de relés a activar - 8 \textit{bits} ou 13 \textit{bits}, dependendo dos circuitos - é enviada através da interface de rede. A implementação do mecanismo de comunicação encontra-se no ficheiro \textit{configRelays.py}, na função \textit{config\textunderscore Relays}.

Sendo assim, o ficheiro \textit{receive.py} é executado inicialmente e aguarda pelo envio da \textit{string}. De referir que, embora o \textit{socket} esteja configurado em \textit{blocking mode} - quer isto dizer que o cliente ficará bloqueado na Linha~\ref{line:blockmode}, da Listagem \ref{lst:socketblock}, esperando uma resposta do servidor \cite{Sockets} (acontece enquanto a \textit{string} não for enviada) - optou-se por enviar uma confirmação do servidor ao cliente. Não sendo estritamente necessário, foi adicionada como auxílio à depuração.

\begin{minipage}{0.9\linewidth}
	\begin{lstlisting}[language=Python,escapechar=|, caption=\textit{Block Mode \textins{Sockets} configRelays.py}, label=lst:socketblock]
		# Espera pela resposta do servidor
        while True:
            data = s.recv(1024) |\label{line:blockmode}|
            if not data:
                break
            response = data.decode()
            if response == 'True':  # Espera por uma confirmacao especifica do servidor
                print("Confirmacao recebida do servidor:", response)
                break
	\end{lstlisting}
\end{minipage}

O passo final é a activação dos relés, realizada no ficheiro \textit{shift\textunderscore register.py}, função \textit{commandRelays}. O procedimento foi descrito na subsecção \ref{sec:hwregistodeslocamento}, sendo que os modos de funcionamento estão representados na Tabela \ref{Table:funcSN74HC595}.

Para que as experiências funcionem correctamente, todos os relés devem ser activados em simultâneo. Para isso, a sequência de controlo dos relés é representada por uma \textit{string} composta por 8 ou 13 dígitos binários, conforme as experiências, em que cada carácter indica o estado (ligado ou desligado) de um relé. Esta \textit{string} é posteriormente convertida para um número inteiro, sobre o qual é realizada uma operação de \textit{and bit} a \textit{bit}. Cada um dos \textit{bits} resultantes é, então, enviado sequencialmente para o registo de deslocamento, numa configuração \acrshort{sipo}, conforme ilustrado na Listagem \ref{lst:andbitabit}. Assim que os 8 ou 13 \textit{bits} forem transferidos para o registo, a saída paralela será activada, resultando na activação dos relés.

\begin{minipage}{0.9\linewidth}
	\begin{lstlisting}[language=Python,escapechar=|, caption=\textit{And bit} \textit{bit shift\textunderscore register.py}, label=lst:andbitabit]
		for i in range(n_bits):
			binaryShift = binaryString & 1
			if binaryShift == 1:
				WriteReg (ON, SERCLK_pin_ctrl, SER_pin_ctrl, WaitTimeSR)
			else:
				WriteReg(OFF, SERCLK_pin_ctrl, SER_pin_ctrl, WaitTimeSR)
			binaryString = binaryString >> 1
		OutputReg(RCLK_pin_ctrl)
		return True # Fim da transmissao da string de bits, reles activados
	\end{lstlisting}
\end{minipage}

\subsubsection{VirtualBench - Configurações e medições}
\label{sec:configmedicaoes}
O comando e controlo do \acrshort{virtualbench} (e dos respetivos instrumentos) — representado na Figura~\ref{fig:diagramasimplificado} pelas setas vermelhas — é realizado através da biblioteca pyVirtualBench \cite{docpyvirtualbench}, a qual, como referido na Secção~\ref{sec:solucaoproposta}, funciona como um \textit{wrapper} que permite controlar o \acrshort{virtualbench} a partir de uma aplicação desenvolvida em Python. A documentação desta biblioteca, disponível no endereço indicado, é bastante completa e detalhada, sendo recomendada para aprofundamento técnico. Além de instalar a biblioteca, os autores disponibilizam uma série de exemplos, sendo que, aqueles que mais se adequam aos objectivos deste projecto são:
\begin{itemize}
	\item \textit{dmm\_example.py}: exemplo que demonstra como efetuar medições utilizando o multímetro digital;
	\item \textit{fgen\_example.py}: exemplo que demonstra como configurar e gerar uma onda através do gerador de sinal;
	\item \textit{mso\_simple\_example.py}: exemplo que demonstra como configurar e adquirir dados do osciloscópio, utilizando a funcionalidade de configuração automática incorporada;
	\item \textit{ps\_example.py}: exemplo que demonstra como efetuar medições utilizando a fonte de alimentação.
\end{itemize}

De forma a realizar as configurações e medições do \acrshort{virtualbench}, tomou-se como ponto de partida os exemplos já fornecidos com a referida biblioteca e adaptaram-se ao contexto do projecto. Nesta subsecção, apresenta-se como exemplo a configuração da fonte de alimentação, por ser o único instrumento utilizado em todas as experiências realizadas.  

Através da análise dos exemplos disponibilizados para o \acrshort{virtualbench} (e que estão definidos no repositório já mencionado do GitHub), foi possível compreender a estrutura geral de configuração aplicada aos instrumentos e fontes de alimentação. Com base nessa análise, determinou-se a seguinte lógica de funcionamento:

\begin{enumerate}
	\label{item:logica}
	\item Aquisição do \textit{virtualbench};
	\item Aquisição dos instrumentos;
	\item Configurações específicas de cada instrumento;
	\item Desenvolvimento do programa;
	\item Libertar os instrumentos;
	\item Libertar o \textit{virtualbench}.
\end{enumerate}

A aquisição do \acrshort{virtualbench}, identificado como VB8012-30A210F, é feita através da criação de uma instância da classe PyVirtualBench, que é a classe principal da biblioteca pyVirtualBench, definida na Linha \ref{line:vb8012}, da Listagem \ref{lst:instanciacao}.

\begin{center}
\begin{minipage}{0.9\linewidth}
	\begin{lstlisting}[language=Python,escapechar=|, caption=Instanciação da classe PyVirtualBench, label=lst:instanciacao]
		virtualbench = PyVirtualBench('VB8012-30A210F') |\label{line:vb8012}|
		ps = virtualbench.acquire_power_supply() |\label{line:acquireps}|
	\end{lstlisting}
\end{minipage}
\end{center}

A partir do objecto \textit{virtualbench}, é possível aceder aos diferentes instrumentos, sendo que a aquisição é feita através do método \textit{acquire\_\textless instrumento\textgreater()}. Essa instância é armazenada numa variável definida pelo utilizador, permitindo o acesso às funcionalidades de configuração, controlo e medição disponibilizadas por esse instrumento. Na Listagem \ref{lst:instanciacao}, linha \ref{line:acquireps}, pode ver-se, a título de exemplo, como é feita a aquisição da fonte de alimentação, que é armazenada na variável \textit{ps}. Um exemplo da configuração da fonte está descrita na Listagem \ref{lst:exemploconfigps}.

\begin{minipage}{0.7\linewidth}
	\begin{lstlisting}[language=Python,escapechar=|, caption=Exemplo \textit{ps\_example.py}, label=lst:exemploconfigps]
		try:
			# Configuracao da fonte de alimentacao
			channel = "ps/+25V" |\label{line:channel}| 
			voltage_level = 1.0 |\label{line:voltagelevel}|
			current_limit = 0.5 |\label{line:currentlimit}|
			# Configuracao especifica
			ps.configure_voltage_output(channel, voltage_level, current_limit)|\label{line:configvoltage}|
			ps.enable_all_outputs(True)|\label{line:enableoutputs}|
	\end{lstlisting}
\end{minipage}

\begin{itemize}
	\item \textit{channel} - linha \ref{line:channel}: especifica o canal da fonte de tensão a utilizar, sendo que, neste exemplo, é selecionado o canal de \SI{25}{\volt}, através do nome ``ps/+25V'' (podendo também ser utilizado ``ps/+6V'' para o canal de \SI{6}{\volt});
	\item \textit{voltage\_level} - linha \ref{line:voltagelevel}: define o valor da tensão de saída. No caso deste exemplo, \SI{1,0}{\volt}. Pode ser, também, atribuída uma variável - $V_{cc}$ - com base nos valores apresentados na Figura~\ref{fig:pagohm});
	\item  \textit{current\_limit} - linha \ref{line:currentlimit}: é configurado o limite de corrente para \SI{0,5}{\ampere};
	\item \textit{ps.configure\_voltage\_output(channel, voltage\_level, current\_limit)} - linha \ref{line:configvoltage}: configura a fonte de alimentação com os parâmetros definidos nas linhas \ref{line:channel} a \ref{line:currentlimit};
	\item \textit{ps.enable\_all\_outputs(True)} - linha \ref{line:enableoutputs}: activa todas as saídas da fonte de alimentação. No entanto, só a saída correspondente ao canal definido na linha \ref{line:channel} será activada.
\end{itemize}

No final da execução, os instrumentos e o \acrshort{virtualbench} têm de ser libertados, por esta ordem. Isto é feito através do método \textit{instrumento.release()}. Se tal não for feito, o \acrshort{virtualbench} e os instrumentos chamados não serão libertados, ficando inacessíveis para futuras chamadas. 

De referir que vários instrumentos podem ser chamados simultaneamente e, para cada um deles, assim como para o \acrshort{virtualbench}, é criada uma instância para o respectivo objecto, cuja referência corresponde a um endereço de memória. O resultado das instruções na Linha~\ref{line:acquireps} e Linha~\ref{line:vb8012} da Listagem~\ref{lst:instanciacao} é:

\begin{itemize}
	\item (...)PyVirtualBench object at 0x000001E7DEECAD20.
	\item (...)PyVirtualBench.PowerSupply object at 0x000001E7DEECB2F0;
\end{itemize}

No entanto, se um ficheiro for chamado várias vezes (como no caso da experiência da Lei de Ohm), uma nova instância do instrumento será sempre criada a cada chamada. Além disso, se houver várias funções no mesmo ficheiro, os objectos criados (por exemplo, 0x000001E7DEECAD20) devem ser passados entre funções ou, alternativamente, o instrumento deve ser encerrado e reinicializado entre chamadas de funções.

\subsubsection{Gráficos}
\label{sec:graficos}
Os gráficos apresentados são gerados com recurso às bibliotecas NumPy \cite{NumPy} e Matplotlib \cite{Matplotlib}, amplamente utilizadas em Python. A NumPy é uma biblioteca fundamental para computação científica, permitindo a manipulação eficiente de \textit{arrays} multidimensionais e fornecendo um vasto conjunto de funções matemáticas, estatísticas e de álgebra linear. No contexto da construção de gráficos, o NumPy é essencial na preparação e transformação dos dados a representar. O declive da recta obtido experimentalmente, no estudo da Lei de Ohm, representado na Listagem \ref{lst:decliverecta}, foi calculado com recurso à biblioteca SciPy, que disponibiliza ferramentas avançadas de análise científica, incluindo ajustamento de curvas e complementa a NumPy, sobre a qual está construída.

\begin{minipage}{0.9\linewidth}
	\begin{lstlisting}[language=Python,escapechar=|, caption=Cálculo do declive da recta, label=lst:decliverecta]
		slope, intercept, r_value, p_value, std_err = stats.linregress(voltage_measurements, current_measurements)
	\end{lstlisting}
\end{minipage}

A visualização dos dados é realizada através da Matplotlib, uma biblioteca consolidada para criação de gráficos em Python. Esta permite gerar representações visuais, como gráficos de linhas, dispersão, histogramas, entre outros. Neste projecto, a Matplotlib é utilizada para representar de forma clara e interpretável os dados e resultados obtidos. A Listagem \ref{lst:graficoUvsI} ilustra a forma como se gera um gráfico experimental correspondente à Lei de Ohm.

\begin{minipage}{0.9\linewidth}
	\begin{lstlisting}[language=Python,escapechar=|, caption=Gráfico Corrente \textit{vs} Tensão, label=lst:graficoUvsI]
		plt.plot(voltage_measurements, current_measurements, label='V Vs I', marker = 'o')
	\end{lstlisting}
\end{minipage}

Outro tipo de gráficos que são gerados são os diagramas de Bode, que representam a resposta em frequência dos filtros. A Listagem \ref{lst:diagramaBode} ilustra a forma como são gerados os pontos das frequências para o gráfico de Bode. Neste caso, as frequências são geradas logaritmicamente, utilizando a função \textit{logspace} da biblioteca NumPy.

\begin{minipage}{0.9\linewidth}
	\begin{lstlisting}[language=Python,escapechar=|, caption=Filtros - Diagrama de \textit{Bode}, label=lst:diagramaBode]
		num_points = int(np.log10(stop_freq / start_freq) * points_per_decade)
		frequencies = np.logspace(np.log10(start_freq), np.log10(stop_freq), num=num_points)	
	\end{lstlisting}
\end{minipage}

As imagens geradas são gravadas na pasta ``webserver/website/static/images/'', tal como indica o exemplo na Listagem \ref{lst:gravacaoimagem}. 

\begin{minipage}{0.9\linewidth}
	\begin{lstlisting}[language=Python,escapechar=|, caption=Gravação do gráfico, label=lst:gravacaoimagem]
	    plt.savefig("webserver/website/static/images/ohm_graph.png")	
	\end{lstlisting}
\end{minipage}

\subsection{Interface \textit{web}}
\label{sec:interfaceweb}
Do ponto de vista do \textit{software} ou \acrshort{ide}, e considerando a estrutura das experiências em termos de \textit{design} e implementação, o estudo pode ser dividido em duas partes distintas: a primeira, que envolve a Lei de Ohm, apresenta um maior grau de complexidade, dado que há um número maior de parâmetros e o utilizador ou aluno tem um controlo mais amplo sobre a experiência, já a segunda parte, que aborda os rectificadores e filtros, segue uma estrutura relativamente uniforme, aplicável a todas as experiências. Assim, nesta secção, apresenta-se um estudo que permite, de forma geral, compreender a componente gráfica - \acrshort{ide} - e a interacção dos utilizadores no controlo das experiências. Sempre que se considerar pertinente, serão destacados aspetos específicos e detalhados.

%\sout{a base da Arquitetura de Comunicação, a troca de parâmetros e as configurações entre os diversos tipos de ficheiros.} \textbf{NOTA: Este parágrafo não faz muito sentido aqui, após a mudança do nome da secção para Interface WEB ou talvez reescrever a última frase após o optou-se...}

Comum a todas as experiências é a configuração inicial do \acrshort{virtualbench}. Esta configuração é necessária, uma vez que, antes de se iniciar o processo de medições, optou-se por activar a fonte de alimentação que alimenta os relés e os \textit{drivers} e a fonte de alimentação composta pelo LM317 que alimenta os registos de deslocamento, tal como descrito na subsecção \ref{sec:fontesalimentacao}. Desta forma, implementou-se nas páginas das experiências, um botão de ``OK'' - que habilita os selectores e configura a fonte do \acrshort{virtualbench} e ``STOP/RESET'' - que desabilita os selectores e desactiva as fontes enquanto a experiência está inactiva. 

A verificação e detecção dos erros, Figura \ref{fig:erropagina}, acontece quando o utilizador tenta seleccionar um dos parâmetros antes de estes estarem habilitados ou, no caso dos rectificadores e filtros, colocar o valor da frequência fora do valor definido nas instruções. O alerta de erro é implementado nas páginas \acrshort{html} das experiências, usando o método \textit{alert()} do JavaScript.

\begin{figure}[hbtp]
	\centering
	
	\caption{Erro de selecção}
	\label{fig:erropagina}
\end{figure}

Como mencionado na subsecção \ref{sec:frontend}, procurou-se manter a experiência de utilização e navegação o mais simples, prática e intuitiva possível. Além das páginas que compõem a base do \textit{site}, representadas na Figura \ref{fig:estruturapastas}, há ainda a juntar as que permitem ao utilizador interagir com as experiências do \acrshort{lare}. Especificamente, foram implementadas cinco páginas, correspondentes aos cinco circuitos definidos na Secção \ref{sec:solucaoproposta}.

A navegação ficou dividida da seguinte forma:
\begin{itemize}
	\item Autenticação;
	\begin{itemize}
		\item Página inicial;
		\begin{itemize}
			\item Página introdutória da experiência;
			\begin{itemize}
				\item Página de controlo e realização da experiência.
			\end{itemize}
		\end{itemize}
	\end{itemize}
\end{itemize}

A página de autenticação, representada na Figura \ref{fig:paglogin}, está implementada no ficheiro \textit{auth.py}, função \textit{login}() e os formulários estão implementados na página \textit{login.html}, sendo que os dados de \textit{login} e registo são guardados na directoria \textit{instance}, ficheiro \textit{database.db}.

\begin{figure}[hbtp]
	\centering
	
	\caption{Página de \textit{login}}
	\label{fig:paglogin}
\end{figure}

Após o registo e \textit{login} bem sucedido, é apresentada a página inicial, onde é feito um pequeno resumo do que é o \acrshort{lare} e apresentado o menu de escolha das experiências. O menu de separadores verticais foi retirado do \textit{site} \href{https://www.w3schools.com/howto/howto_js_vertical_tabs.asp}{W3Schools} e modificado de acordo com as necessidades do projecto, tal como pode ser visto na Figura \ref{fig:pagmenu}.

\begin{figure}[hbtp]
	\centering
	
	\caption{Página inicial}
	\label{fig:pagmenu}
\end{figure}

O modelo adoptado é uniforme para todas as experiências, apresentando o respectivo esquema e contextualização da actividade. Após a selecção da experiência, tanto as páginas introdutórias como as de controlo seguem a mesma estrutura de menus, mantendo o mesmo padrão de organização e navegação. A título de exemplo, as Figuras \ref{fig:ohm_intro} e \ref{fig:ohm_ctrl} ilustram, respetivamente, as páginas de introdução e controlo relativas à Lei de Ohm. 

% No entanto, no que diz respeito ao controlo das experiências, tal como referido na Secção \ref{sec:interfaceweb}, a experiência da Lei de Ohm apresenta um maior grau de complexidade, dado que há um número maior de parâmetros e o utilizador ou aluno tem um controlo mais amplo sobre a experiência.

\begin{figure}[hbtp]
	\centering%
		\centering
		\subfloat[\centering Introdução\label{fig:ohm_intro}]{{ }}%
		\qquad
		\subfloat[\centering Controlo\label{fig:ohm_ctrl}]{{ }}%
		\caption{\textins{Exemplo} Experiência Lei de Ohm}%
		\label{fig:pagohm}%
	\end{figure}

\subsubsection{Lei de Ohm}
Nesta experiência, optou-se por conceder liberdade de escolha e controlo aos utilizadores, o que representou um desafio à implementação. Em vez de permitir apenas a selecção do valor da resistência, com medições realizadas (automaticamente) por \textit{software}, decidiu-se oferecer ao utilizador a possibilidade de escolher o valor da resistência e controlar as medições de tensão e corrente. Do ponto de vista pedagógico, considerou-se mais benéfico que, neste caso, os alunos verifiquem os valores das grandezas medidas à medida que realizam as medições e avançam na experiência. Além disso, o resultado e o gráfico final serão independentes da ordem pela qual se efectuam as medições.

A Figura \ref{fig:pagmenuCTRL} ilustra a página de controlo da experiência da Lei de Ohm. 

\begin{figure}[hbtp]
	\centering
	
	\caption{Lei de Ohm - Selecção dos parâmetros}
	\label{fig:pagmenuCTRL}
\end{figure}

A selecção dos valores da resistência e do $U_{CC}$ é feita através de um formulário de selecção, feito em \acrshort{css} e JavaScript, retirado do \textit{site} \href{https://www.w3schools.com/howto/howto_custom_select.asp}{W3Schools} e modificado de acordo com as necessidades do projecto. Este formulário está implementado na página \acrshort{html} da experiência. Como se pode observar pela Figura \ref{fig:pagmenuCTRL}, a tensão medida no voltímetro é, efectivamente, a tensão aos terminais da fonte de tensão, $U_{CC}$ e da resistência. Por razões pedagógicas e de coerência com o esquema, optou-se por medir e apresentar a tensão directamente nos terminais da resistência.

Como se observa na Figura~\ref{fig:pagmenuCTRL}, a tensão indicada pelo voltímetro corresponde à tensão presente entre os terminais da fonte de tensão $U_{CC}$ e da resistência. Por razões pedagógicas e para manter a coerência com o esquema apresentado, optou-se por medir e representar a tensão directamente nos terminais da resistência. As medições só serão efectivamente realizadas e os valores apresentados, quando a opção ``Medir tensão'' e/ou ``Medir corrente'' forem seleccionadas. O utilizador dispõe de alguma flexibilidade na forma como realiza as medições (cinco de tensão e cinco de corrente), desde que mantenha a mesma ordem. Por exemplo, pode optar por medir todos os valores de tensão - desde o mais baixo ao mais alto - e, de seguida proceder da mesma forma com as medições de corrente. Após a conclusão das dez medições, torna-se possível seleccionar a opção ``Gráfico'' para visualizar o gráfico da experiência. Caso esta opção seja seleccionada antes da conclusão de todas as medições, o gráfico será apresentado com as medições disponíveis até ao momento, permitindo, ainda assim, a continuação normal da experiência.

Sendo assim, o procedimento para a realização da experiência é o seguinte:
\begin{enumerate}
	\item Seleccionar ``OK'' para activar a fonte do \acrshort{virtualbench} e alimentar os integrados;
	\item Escolher o valor da resistência;
	\item Escolher o valor de $U_{CC}$;
	\item Efectuar cinco medições de tensão (``Medir tensão'') e cinco medições de corrente (``Medir corrente'');
	\item Ver o gráfico resultante.
	\item Seleccionar ``STOP/RESET'' para desactivar a fonte do \acrshort{virtualbench}.
\end{enumerate}

\subsubsection{Rectificador de meia onda e onda completa}
\label{sec:rectificadores}
Nestas duas experiências, pretende-se estudar e avaliar a diferença entre estes dois tipos de rectificadores, tanto ao nível da rectificação como da filtragem, nomeadamente no estudo da variação da tensão de \textit{ripple}. A principal diferença, como foi referido na subsecção \ref{sec:rectificadoresfiltros}, reside no valor da frequência. Enquanto que no rectificador de meia onda, o sinal de entrada é alimentado pelo gerador de sinal do \textit{virtualbench}, o rectificador de onda completa, devido ao problema de massa já referenciado na subsecção \ref{sec:fontealternada}, é alimentado através de um transformador \SI{230}{\volt}/\SI{8}{\volt}, com uma frequência de \SI{50}{\hertz}.

A Figura \ref{fig:meiaondamenuCTRL} ilustra a página de controlo da experiência do rectificador de meia onda. Os utilizadores podem seleccionar quatro valores para o termo RC, sendo que os valores de C estão definidos para \SI{1}{\micro\farad} e \SI{10}{\micro\farad} e a frequência varia entre \SI{5}{\hertz} e \SI{2000}{\hertz}. 

\begin{figure}[hbtp]
	\centering%
		\centering
		\subfloat[\centering Rectificador de meia onda\label{fig:meiaondamenuCTRL}]{{ }}%
		\qquad
		\subfloat[\centering Rectificador de onda completa\label{fig:ondacompletamenuCTRL}]{{ }}%
		\caption{Selecção de parâmetros}%
		\label{fig:seleccaoparametros}%
\end{figure}

As medições e construção do gráfico são realizadas por \textit{software}, baseadas nos valores seleccionados pelos utilizadores. Os resultados obtidos podem, então, ser comparados com o gráfico teórico, definido na Figura \ref{fig:formadeonda_MO} ou pela Equação \ref{eq:vripple}. Para o mesmo par RC, os utilizadores podem, ainda, variar a frequência e comparar os resultados obtidos.

Relativamente ao rectificador de onda completa, a Figura \ref{fig:ondacompletamenuCTRL} apresenta a página de controlo da experiência, que é praticamente idêntica à do rectificador de meia onda, excepto pelo facto de a frequência não poder ser ajustada pelo utilizador. Os valores dos condensadores e resistências são os mesmos para ambas as experiências.

O procedimento para a realização da experiência é o seguinte:
\begin{enumerate}
	\item Seleccionar ``OK'' para activar a fonte do \acrshort{virtualbench} e alimentar os integrados;
	\item Escolher o valor da resistência;
	\item Escolher o valor do condensador;
	\item Efectuar as medições;
	\item Ver o gráfico resultante;
	\item Seleccionar ``STOP/RESET'' para desactivar a fonte do \acrshort{virtualbench}.
\end{enumerate}

\subsubsection{Filtros}
\label{sec:filtrosSW}
As páginas dos filtros passa-baixo e passa-alto, são em tudo idênticas às dos rectificadores e estão representadas na Figura \ref{fig:passabaixomenuCTRL} e Figura \ref{fig:passaaltomenuCTRL}.

\begin{figure}[hbtp]
	\centering%
		\centering
		\subfloat[\centering Filtro passa-baixo\label{fig:passabaixomenuCTRL}]{{ }}%
		\qquad
		\subfloat[\centering Filtro passa-alto\label{fig:passaaltomenuCTRL}]{{ }}%
		\caption{Selecção de parâmetros}%
		\label{fig:controlofiltros}%
\end{figure}

Consoante a configuração do filtro, o utilizador escolhe entre dois condensadores ou duas resistências, representados no rectângulo tracejado cor-de-laranja, na Figura \ref{fig:rectificacao_filtragem_full}. Como já foi referido na subsecção \ref{sec:experiencias}, os componentes dentro do rectângulo tracejado vermelho, representados na mesma figura, foram adicionados após a implementação dos rectificadores. Assim, quando se pretende estudar o filtro passa-baixo, o utilizador escolhe entre os dois condensadores (de saída) e se pretender estudar o passa-alto, escolhe entre as duas resistências (de saída). Eventualmente, poder-se-iam ter adicionado mais resistências/condensadores aos filtros, nomeadamente, no rectângulo tracejado vermelho, de forma a permitir uma maior versatilidade no estudo. No entanto, além de não existir o número suficiente de relés em contexto laboratorial, considerou-se que, desta forma, o estudo e os objectivos da experiência, ficariam provados. O intervalo de frequência mantém-se entre os \SI{50}{\hertz} e \SI{2000}{\hertz}. O procedimento para a realização da experiência é o seguinte:

\begin{enumerate}
	\item Seleccionar ``OK'' para activar a fonte do \acrshort{virtualbench} e alimentar os integrados;
	\item Escolher o valor do condensador - passa-baixo;
	\item Escolher o valor da resistência - passa-alto;
	\item Efectuar as medições;
	\item Ver o gráfico resultante;
	\item Ver o gráfico resultante da resposta em frequência;
	\item Seleccionar ``STOP/RESET'' para desactivar a fonte do \acrshort{virtualbench}.
\end{enumerate}
