eddygrinder/LaRE_LaTeX/front/0_acronyms.tex

%----------------------------------------------------------------------------------------
%	ACRONYMS LIST
%----------------------------------------------------------------------------------------

% Only the used entries will be displayed in the printed list, ie, you need to used a acronym at least once
% Full name in italic if not in the main document language

%acronym definition usage:
%\newacronym{<tag>}{<acronym>}{<full name>}
\newacronym{gpl3}{GPL-3.0}{GNU General Public License, versão 3.0}
\newacronym{es}{E/S}{Entrada/Saída}
\newacronym{sram}{SRAM}{Static Random-Access Memory}
\newacronym{php}{PHP}{PHP: Hypertext Preprocessor}
\newacronym{Hat}{HAT}{Hardware Attached on Top}
\newacronym{Eeprom}{EEPROM}{Electrically Erasable Programmable Read-Only Memory}
\newacronym{eda}{EDA}{Electronic Design Automation}
\newacronym{npnp}{NPNP}{n-p-n-p}
\newacronym{pnpn}{PNPN}{p-n-p-n}
\newacronym{LED}{LED}{Light Emitting Diode}
\newacronym{led}{LED}{Laboratórios de Educação Digital}
\newacronym{cnaprr}{CNA-PRR}{Comissão Nacional de Acompanhamento do Plano de Recuperação e Resiliência}
\newacronym{lare}{LaRE}{Laboratório Remoto Expansível}
\newacronym{dee}{DEE}{Departamento de Engenharia Electrotécnica}
\newacronym{isep}{ISEP}{Instituto Superior de Engenharia do Porto}
\newacronym{meec}{MEEC}{Mestrado em Engenharia Electrotécnica e Computadores}
\newacronym{desi}{DESI}{Digital Economy and Society Index}
\newacronym{tic}{TIC}{Tecnologias da Informação e da Comunicação}
\newacronym{dn}{DN}{Diário de Notícias}
\newacronym{ue}{UE}{União Europeia}
\newacronym{unesco}{UNESCO}{United Nations Educational, Scientific and Cultural Organization}
\newacronym{iot}{IoT}{Internet Of Things}
\newacronym{prr}{PRR}{Plano de Recuperação e Resiliência}
\newacronym{www}{WWW}{World Wide Web}
\newacronym{stem}{STEM}{Science, Technology, Engineering and Mathematics}
\newacronym{steam}{STE(A)M}{Science, Technology, Engineering, Arts and Mathematics}
\newacronym{ocde}{OCDE}{Organização para a Cooperação e Desenvolvimento Económico}
\newacronym{pisa}{PISA}{Program for International Student Assessment}
\newacronym{covid-19}{COVID-19}{Coronavirus Disease 2019}
\newacronym{pafse}{PAFSE}{Partnerships for Science Education}
\newacronym{visir}{VISIR}{Virtual Instrument Systems in Reality}
\newacronym{spice}{SPICE}{Simulation Program for Integrated Circuits Emphasis}
\newacronym{pspice}{PSPICE}{Personal Computer Simulation Program for Integrated Circuits Emphasis}
\newacronym{pc}{PC}{Personal Computer}
\newacronym{ca}{CA}{Corrente Alternada}
\newacronym{cc}{CC}{Corrente Contínua}
\newacronym{bth}{BTH}{Blekinge Institute of Technology}
\newacronym{ni}{NI}{National Instruments}
\newacronym{eua}{EUA}{Estados Unidos da América}
\newacronym{ide}{IDE}{Integrated Development Environment}
\newacronym{labview}{LabVIEW}{Laboratory Virtual Instrument Engineering Workbench}
\newacronym{microcontroladores}{$\mu$C}{microcontroladores}
\newacronym{usb}{USB}{Universal Serial Bus}
\newacronym{daq}{DAQ}{Data Acquisition}
\newacronym{scada}{SCADA}{Supervisory Control and Data Acquisition}
\newacronym{plc}{PLC}{Programmable Logic Controller}
\newacronym{fpga}{FPGA}{Field Programmable Gate Array}
\newacronym{arm}{ARM}{Advanced RISC Machine}
\newacronym{mhsa}{MHSA}{Multipurpose Hardware and Software Architecture}
\newacronym{matlab}{MATLAB}{MATrix LABoratory}
\newacronym{ejs}{EJS}{Easy Java Simulations}
\newacronym{diesel}{DIESEL}{Distance Internet-Based Embedded System Experimental Laboratory}
\newacronym{laboratório remoto}{LR}{Laboratório Remoto}
\newacronym{ilab}{ISA}{iLab Shared Architecture}
\newacronym{rlms}{RLMS}{Remote Laboratory Management System}
\newacronym{mit}{MIT}{Massachusetts Institute of Technology}
\newacronym{api}{API}{Application Programming Interface}
\newacronym{lms}{LMS}{Learning Management System}
\newacronym{puc}{PUC}{Pontifícia Universidade Católica}
\newacronym{mcr}{MCR}{Matriz de Comutação de Relés}
\newacronym{pic}{PIC}{Programmable Interrupt Controller}
\newacronym[sort=i2c]{i2c}{$I^{2}$C}{Inter-Integrated Circuit}
\newacronym{pxi}{PXI}{PCI eXtensions for Instrumentation}
\newacronym{pilar}{PILAR}{Platform Integration of Laboratories based on the Architecture of visiR}
\newacronym{sig}{SIG}{Special Interest Groups}
\newacronym{Triac}{TRIAC}{Triode for Alternating Current}
\newacronym{Diac}{DIAC}{Diode for Alternating Current}
\newacronym{Scr}{SCR}{Silicon Control Rectifier}
\newacronym{lv}{LV}{Laboratório Virtual}
\newacronym{gpl}{GPL}{Gnu Public License}
\newacronym{html}{HTML}{HyperText Markup Language}
\newacronym{virtualbench}{VB}{VirtualBench}
\newacronym{ram}{RAM}{Random Access Memory}
\newacronym{spst}{SPST}{Single Pole Single Throw}
\newacronym{dpst}{DPST}{Double Pole Single Throw}
\newacronym{gpio}{GPIO}{General Purpose Input/Output}
\newacronym{sipo}{SIPO}{Serial Input Parallel Output}
\newacronym{css}{CSS}{Cascading Style Sheets}
\newacronym{wsgi}{WSGI}{Web Server Gateway Interface}
\newacronym{dom}{DOM}{Document Object Mode}
\newacronym{ajax}{AJAX}{Asynchronous JavaScript e XML}
\newacronym{pip}{PIP}{Pip Installs Packages}
\newacronym{http}{HTTP}{Hypertext Transfer Protocol}
\newacronym{dmm}{DMM}{Digital Multimeter}
\newacronym{url}{URL}{Uniform Resource Locator}
\newacronym{adc}{ADC}{Analog-to-Digital Converter}
\newacronym{ser}{SER}{Serial Input}
\newacronym{srclk}{SRCLK}{Shift Register Clock}
\newacronym{rclk}{RCLK}{Register Clock}
\newacronym{oe}{OE}{Output Enable}
\newacronym{srclr}{SRCLR}{Shift Register Clear}
\newacronym{json}{JSON}{JavaScript Object Notation}
\newacronym{idc}{IDC}{Insulation Displacement Connector}
\newacronym{pcb}{PCB}{Printed Circuit Board}
\newacronym{W3c}{W3C}{World Wide Web Consortium}
\newacronym{Sbc}{SBC}{Single-Board Computer}
