eddygrinder/LaRE_LaTeX/chapters/chapter5 - BACKUP-27-05.tex

% Chapter 5
\label{Capítulo5}
\chapter{Resultados}
\begin{center}
    \textit{``Newton's third law. You've got to leave something behind''}
     
     Cooper
\end{center}
Os testes foram realizados com o objetivo de validar a implementação do \acrshort{lare} e verificar se os resultados obtidos correspondem aos esperados. 

Como forma de uniformizar conceitos, apesar de tanto as experiências desenvolvidas no \acrshort{lare} como as realizadas na ``placa branca'' serem reais, designar-se-ão os testes efetuados na ``placa branca'' como experiências práticas ou valores práticos.

Sendo assim, a confrontação dos resultados obtidos no \acrshort{lare} foi efetuada com recurso às experiências prácticas, ao \href{https://www.multisim.com}{\textit{MultisimLive}} e aos valores teóricos previamente descritos na Secção \ref{sec:experiencias}. Para a análise dos resultados, serão apresentados um ou dois exemplos representativos por tipo de experiência, sendo que os restantes são obtidos de forma análoga.

No caso específico da Lei de \textit{Ohm}\footnote{Uma vez que a versão grátis \textit{online} do \textit{MultisimLive} não permite realizar a análise continua - \textit{dc sweep} - esta análise fez-se utilizando o \href{https://www.circuitlab.com/}{CircuitLab}}, há ainda a possibilidade de verificar os valores com recurso a um multímetro de bancada.

As experiências podem ser realizadas com diferentes combinações e configurações:
\begin{itemize}
	\item \textbf{Lei de \textit{Ohm}}: três opções de estudo de resistências;
	\item \textbf{Rectificadores}: quatro combinações possíveis de resistências e condensadores para cada rectificador;
	\item \textbf{Filtros}: duas combinações possiveis de resistências e condensadores para cada filtro.
\end{itemize}

\section{Lei de \textit{Ohm}}
\label{sec:resultados_lei_de_ohm}
O objetivo desta experiência é determinar o valor de uma determinada resistência através do cálculo do declive da recta obtida no gráfico da tensão em função da corrente e, assim, confirmar a Lei de \textit{Ohm}. A Figura \ref{fig:graphohmrepetido}, que novamente aqui se apresenta, representa o gráfico esperado. \textbf{NOTA: Vale a pena? é correcto? Opinião PROF}

\begin{figure}[hbtp]
	\centering
	
	\caption{Gráfico da Lei de \textit{Ohm}}
	\label{fig:graphohmrepetido}
\end{figure}

\subsection{Resultados experimentais}
\label{sec:resultados_praticosOHM}
No \acrshort{lare} o utilizador efectua cinco medições de cada grandeza (tensão e corrente), para uma das três resistências disponíveis.

Na Figura \ref{fig:resultados_medicoes_1k} está representado o resultado de um par de medições para uma resistência de \SI{1}{\kilo\ohm}. As restantes medições, em intervalos de \SI{1}{\volt} até \SI{5}{\volt}, são obtidas de forma análoga.

\begin{figure}[hbtp]
	\centering
	
	\caption{Medição práctica}
	\label{fig:resultados_medicoes_1k}
\end{figure}

O valor real da resistência, obtida por medição directa, é de \SI{998}{\ohm}, estando dentro da tolerância que é de $\pm$5\%.

O erro associado aos instrumentos de medição pode ser considerado desprezável. De acordo com as especificações do modelo \textit{VB-8012}\cite{datasheetvb8012}, a precisão para medições de tensão em corrente contínua é:

\begin{itemize}
	\item Faixa de \SI{1}{\volt}
	\begin{itemize}
		\item Precisão garantida (1 ano): $\pm$(0.015\% da leitura $\pm$ 0.005\% da faixa)
	\end{itemize}
\end{itemize}

Estes valores indicam que, para uma leitura de \SI{1}{\volt}, o erro máximo estimado devido à precisão do instrumento seria de, aproximadamente $\pm$\SI{0.0002}{\volt}, ou seja, $\pm$\SI{0.2}{\milli\volt}.

Portanto, a diferença entre a tensão fornecida pela fonte — \SI{1}{\volt} — e os valores medidos — \SI{0.98}{\volt} e \SI{0.97}{\milli\ampere} — deve-se, principalmente, à tolerância da resistência utilizada. Assim, conclui-se que os valores medidos se encontram dentro dos limites expectáveis, sendo perfeitamente aceitáveis face às tolerâncias envolvidas.

O gráfico \textit{U vs I}, obtido para esta resistência é apresentado na Figura \ref{fig:grafico_LaRE_1k}. O declive da recta, que representa a resistência, foi calculado e confrontado com o valor real da resistência. 

\begin{figure}[hbtp]
	\centering
	
	\caption{Gráfico da Lei de \textit{Ohm} - \SI{1}{\kilo\ohm} - MUDAR}
	\label{fig:grafico_LaRE_1k}
\end{figure}

O erro relativo entre o valor teórico e o valor obtido no \acrshort{lare}, pode ser calculado através da Equação \ref{eq:errorelativo}:

\begin{equation} \label{eq:errorelativo}
	\text{Erro Relativo} = \frac{|R_{real} - R_{obtido}|}{R_{real}} \times 100
\end{equation}

O erro relativo obtido é de, aproximadamente, \SI{1.2}{\percent}, sendo um valor perfeitamente aceitável.

Os resultados da experiência práctica, efectuados com a mesma resistência utilizada no \acrshort{lare}, estão representados na Tabela \ref{Table:valoresexperimentaisohm}.

\begin{table}[htb]
	\centering
	\caption{Valores prácticos - Lei de \textit{Ohm}} 
	\label{Table:valoresexperimentaisohm}
	\begin{tabular}{lcc}
		\toprule
		Tensão (V)& Corrente (mA) & Resistência (\SI{}{\kilo\ohm}) \\
		\midrule
		$0.998$ & 0.998 & 1  \\
		\midrule
		 $1.99$ & 1.99  & 1  \\
		 \midrule
		 $2.99$ & 2.99  & 1  \\
		 \midrule
		 $3.99$ & 3.99  & 1  \\
		 \midrule
		 $4.99$ & 4.99  & 1  \\
		\bottomrule
	\end{tabular}
\end{table}

Estes valores foram obtidos com recurso ao \acrshort{virtualbench} e demonstram que o valor da resistência, que corresponde ao declive da recta é constante, o que confirma a Lei de \textit{Ohm}. A partir da Equação \ref{eq:errorelativo}, o valor do erro relativo é inferior a \SI{1}{\percent}. 

Ainda assim e como forma de complementar a análise dos resultados, foram efectuados testes com o \href{https://www.multisim.com}{\textit{Multisim}}. A Figura \ref{fig:multisimOHM} mostra o gráfico obtido.

\begin{figure}[hbtp]
	\centering
	
	\caption{Multisim - Lei de \textit{Ohm}}
	\label{fig:multisimOHM}
\end{figure}

Analisando os valores é possível calcular o declive da recta, dado pela Equação \ref{eq:declive}:

\begin{equation} \label{eq:declive}
	\text{m} = \frac{y_{b} - y_{a}}{x_{b} - x_{a}}
\end{equation}

O valor do declive, correspondente à resistência, obtido para estes simulador é de $m_\text{{multisim}} \approx{0.980}$. Tendo em conta que a escala do eixo do $y$ está representada em \SI{}{\milli\ampere}, os valores das resistências surgem expressos em \SI{}{\kilo\ohm}, isto é, $R_\text{{multisim}} = \SI{0.980}{\kilo\ohm}$. Assim, aplicando a Equação~\ref{eq:errorelativo} obtém-se um erro relativo inferior a \SI{1}{\percent}.

Verifica-se, através da análise dos gráficos, que os dados obtidos com o \acrshort{lare} estão em concordância com os resultados simulados e com os valores prácticos.

\section{Rectificadores}
\label{sec:resultados_rectificadores}
As duas experiências foram implementados com o objectivo de estudar e avaliar a tensão de \textit{ripple} nos circuitos rectificadores de meia onda e onda completa, considerando as quatro combinações possíveis dos pares resistência/condensador. COLOCAR REFERÊNCIA.

As formas de onda esperadas estão representadas na Figura \ref{fig:sedraripple} e Figura \ref{fig:sedraripplecompleta} sendo os valores teóricos da tensão de \textit{ripple} determinados pela Equação \ref{eq:vripplecompleta} e Equação \ref{eq:vrippleOC} - (ou Equação \ref{eq:vripple}). \textbf{NOTA: Aqui coloquei a referência às imagens, ao contrário da Lei de ohm. Opinião PROF}
\subsection{Resultados experimentais [meia onda]}
\label{sec:resultados_RectificadoresMeiaOnda}
\textbf{NOTA: Para manter a corência, colocar a foto da pagina de medição}	
Nestas experiências implementadas no \acrshort{lare} os utilizadores podem escolher uma das quatro combinações de resistência e condensador, fazer variar a frequência entre \SI{50}{\hertz} e \SI{2000}{\hertz} e analisar a diferença de valores na tensão de \textit{ripple}.

Sendo assim, a análise será feita para o caso em que $f=\SI{200}{\hertz}$, $R=\SI{2.2}{\kilo\ohm}$ e $C=\SI{4.7}{\micro\farad}$. Para se determinar qual expressão a usar para calcular a tensão de \textit{ripple}, é necessário verificar a condição descrita na Equação \ref{eq:verificarcondicao}:

\begin{equation} \label{eq:verificarcondicao}
	\SI{2.2}{\kilo\ohm} * \SI{4.7}{\micro\farad} >> \dfrac{1}{200}
\end{equation}

Uma vez que esta condição não se verifica, a expressão a utilizar para calcular a tensão de \textit{ripple} teórica é dada pela Equação \ref{eq:vripplecompleta}. O resultado obtido está representado na Equação \ref{eq:vripplecalculado}:

\begin{equation} \label{eq:vripplecalculado}
	U_{ripple} = \SI{5}{\volt}(1-e^{-\frac{\SI{0.005}{\second}}{\SI{2.2}{\kilo\ohm}*\SI{4.7}{\micro\farad}}}) \approx \SI{1.92}{\volt}
\end{equation}

A Figura \ref{fig:ripplelaremeiaonda} apresenta a forma de onda da tensão de saída e o valor da tensão de \textit{ripple} obtido no \acrshort{lare}, que foi de \SI{1.34}{\volt}.

\begin{figure}[hbtp]
	\centering
	
	\caption{Tensão de \textit{ripple} no \acrshort{lare}- meia onda}
	\label{fig:ripplelaremeiaonda}
\end{figure}

As Figuras \ref{fig:realmeiaonda} e \ref{fig:multisimmeiaonda} representam, respectivamente, os resultados práticos e simulados. A tensão de ripple medida foi de \SI{1.38}{\volt} e \SI{1.51}{\volt}.

\begin{figure}[hbtp]
	\centering%
		\centering
		\subfloat[\centering Circuito práctico\label{fig:realmeiaonda}]{{ }}%
		\qquad
		\subfloat[\centering Simulação \textit{multisim}\label{fig:multisimmeiaonda}]{{ }}%
		\caption{Valores experimentais e simulados - tensão de \textit{ripple}}%
		\label{fig:simulacaoripple}%
	\end{figure}

Os erros relativos obtidos foram de \SI{30.21}{\percent} para o \acrshort{lare}, \SI{28.13}{\percent} e \SI{21.35}{\percent}, para os valores medidos no circuito prácticos e simulados. Esta diferença em relação ao valor calculado teoricamente deve-se a diversos fatores, entre os quais se destaca a simplificação inerente à expressão analítica utilizada, que assume componentes ideais e condições perfeitas — como uma resistência constante e um condensador sem perdas \cite{sedrasmith}. A simulação, embora mais próxima da realidade, utiliza também componentes ideais por omissão, como é o caso do condensador sem resistência série (ESR). Ainda assim, considera fenómenos como as quedas de tensão nos díodos e os efeitos transitórios do circuito. A maior discrepância nos valores experimentais pode ser justificada por erros de leitura e pelas elevadas tolerâncias típicas dos condensadores electrolíticos. Assim, as diferenças observadas são compreensíveis e enquadram-se dentro do esperado.

\subsection{Resultados experimentais [onda completa]}
\label{sec:resultados_RectificadoresOndacompleta}

\section{Filtros}
\label{sec:resultados_filtros}
Estas duas experiências foram realizadas com o objetivo de estudar a resposta em frequência dos filtros $RC$, nomeadamente nas configurações passa-alto e passa-baixo, resultantes das diferentes configurações entre as resistências e os condensadores. Os utilizadores podem variar a frequência entre \SI{50}{\hertz} e \SI{80000}{\hertz}, analisando o comportamento da tensão de saída em função da frequência. A frequência de corte é calculada através da Equação \ref{eq:frequenciacorte}, sendo posteriormente comparada com os valores obtidos experimentalmente no diagrama de \textit{Bode}. Adicionalmente, a atenuação da tensão de saída pode ser determinada através da Equação \ref{eq:relacaoGanho}, ou expressa em \SI{}{\decibel} utilizando a Equação \ref{eq:relacaoGanhodB}.

\subsection{Resultados experimentais [filtro passa-alto]}
\label{sec:resultados_filtros_passaalto}
O circuito analisado será o filtro passa-alto, representado na Figura \ref{fig:filtro_pa} e configurado com $R=\SI{2.2}{\kilo\ohm}$ e $C=\SI{10}{\nano\farad}$. Os gráficos que se esperam obter estão representados na Figura \ref{fig:Bode_pa}. Para os restantes valores e configurações, os resultados poderão ser obtidos de forma análoga.

Para estes valores, a frequência de corte teórica é dada pela Equação \ref{eq:frequenciacorte}, sendo que o valor obtido é de \SI{7234.32}{\hertz}.

Os valores experimentais obtidos com o \acrshort{lare} relativamente à análise do digarama de \textit{Bode}, estão representados na Figura \ref{fig:fcBode}, sendo que o valor aproximado da frequência de corte é de \SI{7071.1}{\hertz}. O erro relativo é, aproximadamente, \SI{2.26}{\percent}. Este valor é perfeitamente aceitável, tendo em conta a tolerância dos componentes utilizados, os erros de medição e aproximações.

\begin{figure}[hbtp]
	\centering
	
	\caption{Frequência de corte - filtro passa-alto - Diagrama de \textit{Bode}}
	\label{fig:fcBode}
\end{figure}

Os resultados complementares obtidos com base na simulação efectuada no \textit{multisim}, já que não é possível gerar o diagrama de \textit{Bode} do circuito práctico, representados na Figura \ref{fig:fcBodemultisim}, mostram que a frequência de corte é de \SI{7282.4}{\hertz}. O erro relativo é de \SI{0.67}{\percent}, o que é prácticamente desprezável.

\begin{figure}[hbtp]
	\centering
	
	\caption{Frequência de corte - \textit{multisim} - Diagrama de \textit{Bode}}
	\label{fig:fcBodemultisim}
\end{figure}

O valor da frequência de corte também pode ser obtido através da análise dos gráficos que representam a relação entre a tensão de saída e a tensão de entrada. 

Como se pode ver pela análise da Figura \ref{fig:voutvinlare}, o ganho a altas frequências é prácticamente unitário, estando em consonância com os valores obtidos no diagrama de \textit{Bode}, representado na Figura \ref{fig:fcBode}. 

\begin{figure}[hbtp]
	\centering
	
	\caption{$v_{out}$ \textit{vs} $v_{in}$ experimental \acrshort{lare} - TEMPORÁRIO}
	\label{fig:voutvinlare}
\end{figure}

Comparando estes valores com os obtidos através do circuito práctico, representados na Figura \ref{fig:realPA} e Figura \ref{fig:multisimPA} do circuito simulado no \textit{multisim} verifica-se que os valores obtidos são prácticamente iguais, podendo ser considerado, com segurança, que em ambos os casos o ganho de tensão é unitário. 

\begin{figure}[hbtp]
	\centering%
		\centering
		\subfloat[\centering Circuito práctico\label{fig:realPA}]{{ }}%
		\qquad
		\subfloat[\centering Simulação \textit{multisim}\label{fig:multisimPA}]{{ }}%
		\caption{Valores prácticos e simulados - $v_{out}$ \textit{vs} $v_{in}$}%
		\label{fig:simulacaoPA}%
	\end{figure}

Relativamente à análise da frequência de corte, representado na Figura \ref{fig:fcvoutlare}, o valor obtido para o \acrshort{lare} é de \SI{7230}{\hertz}, o que corresponde a um erro relativo menor que \SI{1}{\percent}.

\begin{figure}[hbtp]
	\centering
	
	\caption{Frequência de corte - \acrshort{lare}}
	\label{fig:fcvoutlare}
\end{figure}

O circuito práctico apresenta uma frequência de corte de \SI{7000}{\hertz}, com um erro relativo de \SI{3.24}{\percent}, enquanto a simulação no \textit{Multisim} apresenta \SI{7300}{\hertz}, com um erro ainda mais reduzido de \SI{0.9}{\percent}. Estes desvios podem ser considerados baixos e encontram-se dentro de margens aceitáveis, tendo em conta as limitações práticas do circuito real, como tolerâncias dos componentes, ruído, e eventuais imprecisões nas medições. O valor obtido na simulação, por outro lado, está mais próximo do valor teórico, o que é expectável dado que os modelos usados assumem, geralmente, componentes ideais ou com parâmetros controlados.

\begin{figure}[hbtp]
	\centering%
		\centering
		\subfloat[\centering Circuito práctico\label{fig:realfcvout}]{{ }}%
		\qquad
		\subfloat[\centering Simulação \textit{multisim}\label{fig:multisimfcvout}]{{ }}%
		\caption{Valores experimentais reais e simulados - frequência de corte - $v_{out}$ \textit{vs} $v_{in}$}%
		\label{fig:simulacaovout}%
	\end{figure}

\section{Limitações}
\section{Melhoramentos}
