eddygrinder/LaRE_LaTeX/front/1_dedicatory.tex

%----------------------------------------------------------------------------------------
%	DEDICATION
%----------------------------------------------------------------------------------------

\dedicatory{
Para ti, mãe

\vspace{1cm}

``(\ldots) às vezes ainda sou o menino

que adormeceu nos teus olhos''

\textit{Eugénio de Andrade}

}
