eddygrinder/LaRE_LaTeX/chapters/Datasheet/datasheet.tex

%\documentclass[a4paper,12pt,oneside,pdflatex,final,twocolumn]{article}
%
\documentclass[a4paper,oneside,final,twocolumn]{article}
\usepackage[portuguese]{babel}

% Please add the following required packages to your document preamble:
% \usepackage{multirow}
\usepackage{fancyhdr}

\usepackage{graphicx}
\usepackage[utf8]{inputenc}
\usepackage{parallel}
\usepackage{siunitx}
\usepackage{booktabs}
\usepackage{hyperref}
\usepackage[export]{adjustbox}
\usepackage[margin=1in]{geometry}
\addtolength{\topmargin}{0in}
\usepackage{multirow} 
\usepackage{libertine}
\usepackage{subcaption}		% enables subfigures
\usepackage{etoc}

%\usepackage{etoc}
\usepackage{xr} % ou \usepackage{xr-hyper} se estiveres a usar hyperref
\externaldocument{../appendixA} % o nome do ficheiro .tex que contém a secção que queres referenciar
%\externaldocument{../../main}

\renewcommand*\familydefault{\sfdefault}  %% Only if the base font of the document is to be sans serif
\usepackage[T1]{fontenc}

\title{BSPD 2019}
\author{Eduardo Ramalhadeiro}
\date{April 2019}

\begin{document}

\pagestyle{fancy}

\lhead{Anexo \ref{AppendixA} - Matriz de relés LaRE}
\chead {\today}
\rhead{ISEP}

\onecolumn

\begin{figure}
\begin{minipage}{0.47\textwidth}
\centering


\end{minipage}
\hfill
\begin{minipage}{0.47\textwidth}
\raggedleft
\Huge \textbf{Matriz de relés LaRE - Protótipo}
\end{minipage}
\end{figure}

\begin{figure}
\begin{minipage}{0.47\textwidth}

\section{Características}
\begin{itemize}
    \item Matriz com 3 placas baseadas nas dimensões PC/104;
    \item Fonte de alimentação-\SI{5}{\volt}/\SI{1}{\ampere},\newline baseado no LM317\footnote{\href{https://www.ti.com/lit/ds/symlink/lm317.pdf}{Datasheet LM317}};
    \item Experiências:
    \begin{itemize}
        \item Lei de Ohm;
        \item Rectificador de meia onda e onda completa;
        \item Filtros passa-alto e passa-baixo.
    \end{itemize}
\end{itemize}

\end{minipage}
\hfill
\begin{minipage}{0.47\textwidth}
\centering


\end{minipage}
\end{figure}

\section{Descrição}
A matriz de relés do LaRE é constituida por três placas: a placa de alimentação, a placa com o circuito da Lei de Ohm e a placa com os circuitos dos filtros e rectificadores. A matriz do LaRE é controlada pelo RaspberryPI. Há vários tipos de alimentação: \SI{230}{\volt} AC que alimenta o rectificador de onda completa; o VirtualBench fornece alimentação de \SI{12}{\volt} DC ao LM317 e aos registos de deslocamento, sn74hc595\footnote{\href{https://www.ti.com/lit/ds/symlink/sn74hc595.pdf}{Datasheet SN74HC595}} e fornece tensão variável 0-\SI{5}{\volt} DC ao circuito da Lei de Ohm. Os ULN2003a\footnote{\href{https://www.ti.com/lit/ds/symlink/uln2003a.pdf}{Datasheet ULN2003a}}, são alimentados pela fonte de alimentação, baseada no LM317, \SI{5}{\volt}.
Todas as medições são feitas pelo VirtualBench. 

\section{Aplicações}
\begin{itemize}
    \item Laboratórios Remotos;
    \item Experiências remotas;
    \item Estudo da Lei de Ohm;
    \item Estudo de rectificadores;
    \item Estudo de filtros.
\end{itemize}
\newpage
\section{Especificações técnicas}
\begin{table}[htb]
\caption{Especificações técnicas genéricas}
\centering
\begin{tabular}{lcr}
\toprule
 & Unidades & Valores \\
\midrule
$I_{Max}$ do VirtualBench       & $A$     & 0.5 \\
$I_{Max}$ da fonte \SI{5}{V} DC & $A$     & 1.5 \\
Transformador                   & $V$     & 220/8 \\
Dimensões placas                & $mm*mm$ & 96x90 \\
\bottomrule
\end{tabular}
\end{table}

\begin{table}[htb]
\caption{Especificações técnicas genéricas dos relés}
\centering
\begin{tabular}{lcclllll}
\toprule
Relés & \multicolumn{2}{c}{Bobine} & \multicolumn{5}{c}{Contactos}\\
\midrule
& \multicolumn{1}{l}{$V_{Nominal}$} & \multicolumn{1}{l}{$V_{Max}$} & $P_{Max}$ & $V_{Max}$ & $I_{Max}$ & $I_{Max}$\\
\midrule
3570-1331-123  & \multirow{2}{*}{\SI{12}{\volt}} & \multirow{2}{*}{\SI{16}{\volt}}  & \multirow{2}{*}{\SI{10}{\watt}} & \multirow{2}{*}{$\SI{150}{\volt}_{DC}$} & \multirow{2}{*}{\SI{0.5}{\ampere}} & \multirow{2}{*}{\SI{1}{\ampere}}\\
3572-1220-123 & & & & & & &\\                
\bottomrule
\end{tabular}%
\end{table}

\begin{table}[htb]
\caption{Ligações entre placas}
\label{Table:ligacoesplacas}
\centering
\begin{tabular}{lr}
\toprule
\multicolumn{2}{c}{Tipo de ligações}\\
\midrule
RaspberryPI-LaRE & Conector IDC, fêmea, 40 pinos, \SI{2.54}{\mm}\\
Placa Lei de Ohm-Rectificadores/Filtros & Conector de 6 pinos Arduino Stackable\\
Placa Fontes de tensão-Rectificadores/Filtros &  Conector KK, \SI{2.54}{\mm}, M/F \\
\bottomrule
\end{tabular}
\end{table}

\section{Conectores}
Todas as ligações entre o VirtualBench e a matriz, incluindo alimentação DC, saída do gerador de sinal e canais do osciloscópio, bem como a alimentação do transformador, são efectuadas através de conectores tipo $KK$ \SI{2,54}{\mm}, (macho/fêmea).

Para a interligação entre placas, foram utilizados conectores Arduino Stackable de 6 pinos e a ligação do RaspberryPI à placa é feita através de um conector IDC de 40 pinos. As Figuras \ref{fig:conectoresKK}, \ref{fig:stackable} e \ref{fig:idc40pinos} apresentam os conectores referidos, respectivamente\footnote{Imagens retiradas do \textit{site} \href{https://www.botnroll.com/pt//}{https://www.botnroll.com/pt/}.}

\begin{figure}[hbtp]
	\centering%
		\centering
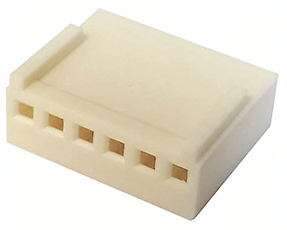
[picture p10: chapters/Datasheet/kkFemea.png]
		\subfloat[\centering Fêmea\label{fig:kkfemea}]{{ }}%
		\qquad
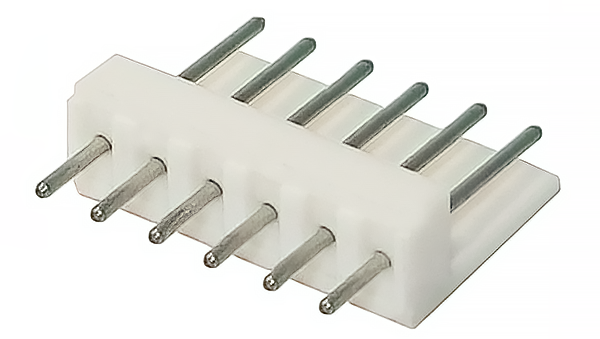
[picture p11: chapters/Datasheet/kkMacho.png]
		\subfloat[\centering Macho\label{fig:kkmacho}]{{ }}%
		\caption{Conectores $KK$}%
		\label{fig:conectoresKK}%
	\end{figure}

	\begin{figure}[hbtp]
		\centering
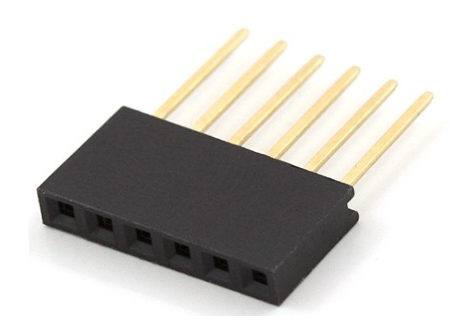
[picture p12: chapters/Datasheet/stackable.png]
		
		\caption {Conector \textit{stackable} 6 pinos Arduino}
		\label{fig:stackable}
	\end{figure}

	\begin{figure}[hbtp]
		\centering
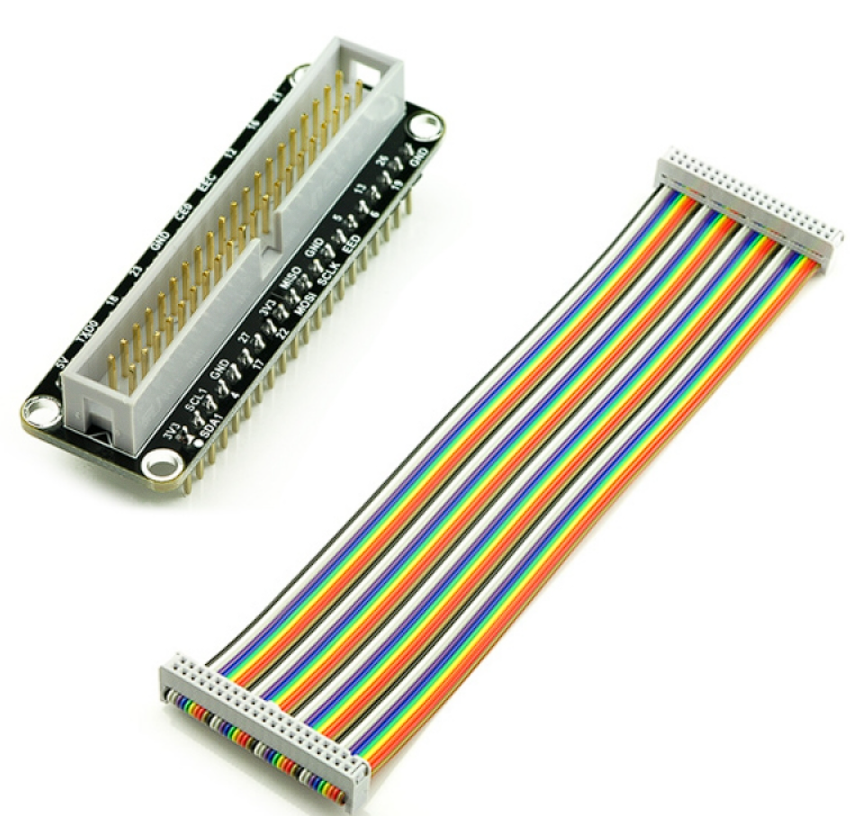
[picture p13: chapters/Datasheet/gpio-breakout.png]
		
		\caption {Ligação IDC 40 pinos [Macho/Fêmea]}
		\label{fig:idc40pinos}
	\end{figure}

\newpage

\raggedright

\newpage

\tableofcontents
\listoftables

\newpage

\section{Pinout}
\begin{figure}[hbtp]
    \centering
    
    \caption{LaRE - Pinout [Fonte de tensão]}
    \label{fig:arquitecturalore}
\end{figure}
\centering

\begin{figure}[hbtp]
    \centering
    
    \caption{LaRE - Pinout [Lei de Ohm]}
    \label{fig:placaleiohm}
    \textbf{Os símbolos ** indicam o pino 1 dos relés}
\end{figure}
\centering

\begin{figure}[hbtp]
    \centering
    
    \caption{LaRE - Pinout [Rectificadores/Filtros]}
    \label{fig:rectificadoresfiltros}
\end{figure}
\centering
\raggedright

\newpage

\section{Dimensões mecânicas}
\begin{figure}[hbtp]
    \centering
    
    \caption{Dimensões mecânicas PC/104 - LaRE}
    \label{fig:DimensõesmecânicasPC104}
\end{figure}

\raggedright
\begin{figure}[hbtp]
    \centering
    
    \caption{Dimensões mecânicas LaRE}
    \label{fig:DimensõesmecânicasLaRE}
\end{figure}

\raggedright
\begin{figure}[hbtp]
    \centering
    
    \caption{Perspectiva LaRE}
    \label{fig:esqueletoLaRE}
\end{figure}

\newpage

\section{Esquemas elétricos}
\begin{figure}[hbtp]
    \centering
    
    \caption{LaRE - Esquema [Fonte de tensão]}
    \label{fig:esquemafonte}
\end{figure}
\centering

\begin{figure}[hbtp]
    \centering
    
    \caption{LaRE - Esquema [Lei de Ohm]}
    \label{fig:esquemaohm}
\end{figure}
\centering

\begin{figure}[hbtp]
    \centering
    
    \caption{LaRE - Esquema [Recficadores/Filtros]}
    \label{fig:esquemarectificador}
\end{figure}
\centering
\raggedright

\newpage

\section{Esquemas PCB}\begin{figure}[hbtp]
    \centering
    
    \caption{LaRE - PCB [Fonte de tensão]}
    \label{fig:pcbfonte}
\end{figure}
\centering

\begin{figure}[hbtp]
    \centering
    
    \caption{LaRE - PCB [Lei de Ohm]}
    \label{fig:pcbohm}
\end{figure}
\centering

\begin{figure}[hbtp]
    \centering
    
    \caption{LaRE - PCB [Recficadores/Filtros]}
    \label{fig:pcbrectificador}
\end{figure}
\centering
\end{document}
