eddygrinder/LaRE_LaTeX/front/0_symbols.tex

%----------------------------------------------------------------------------------------
%	SYMBOLS LIST
%----------------------------------------------------------------------------------------

% terms definition usage:
% \newglossaryentry{<tag>}{
% name={<symbol>},
% sort={<text for the alphabetical sorting>},
% description={<description of the symbol>},
% unit={<units to display>},
% type=symbolslist}

\newglossaryentry{i}{
name={\ensuremath{i}},
sort={i},
description={corrente},
unit=\si{\ampere},
type=symbolslist}

\newglossaryentry{v}{
name=\ensuremath{v},
sort={v},
description={tensão},
unit=\unit{\volt},
type=symbolslist}

\newglossaryentry{p}{
name=\ensuremath{P},
sort={p},
description={potência},
unit=\si{\watt},
type=symbolslist}

\newglossaryentry{r}{
name=\ensuremath{R},
sort={r},
description={resistência},
unit=\unit{\ohm},
type=symbolslist}

\newglossaryentry{omega}{
name=\ensuremath{\omega},
sort={z2},
description={velocidade angular},
unit=\si{\radian\per\second},
type=symbolslist}

\newglossaryentry{x}{
name=\ensuremath{x},
sort={x},
description={deslocamento},
unit=\si{\meter},
type=symbolslist}

% Greek: alpha,beta,gamma,delta,epsilon,zeta,eta,theta,iota,kappa,lambda,mu,nu,xi,omikron,pi,rho,sigma,tau,upsilon,phi,chi,psi,omega
