eddygrinder/LaRE_LaTeX/figures/2003A_Darling.png

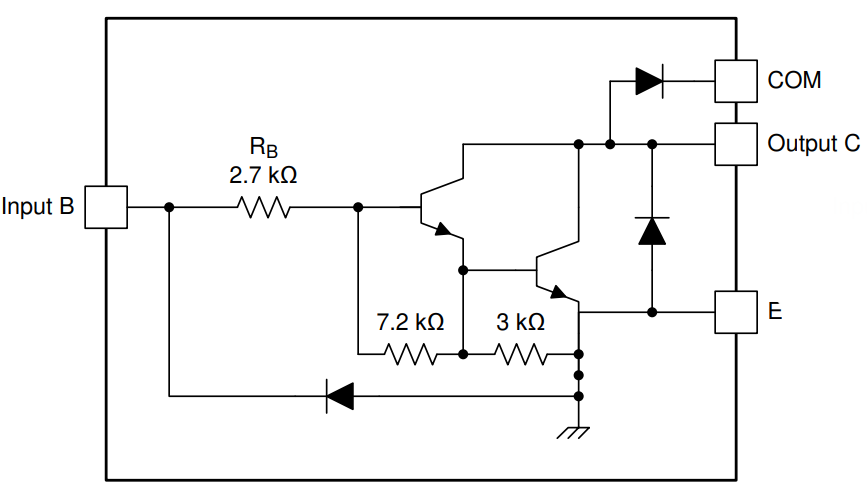
figures/2003A_Darling.png
