eddygrinder/LaRE_LaTeX/figures/AnalogInputToServo_bb.png

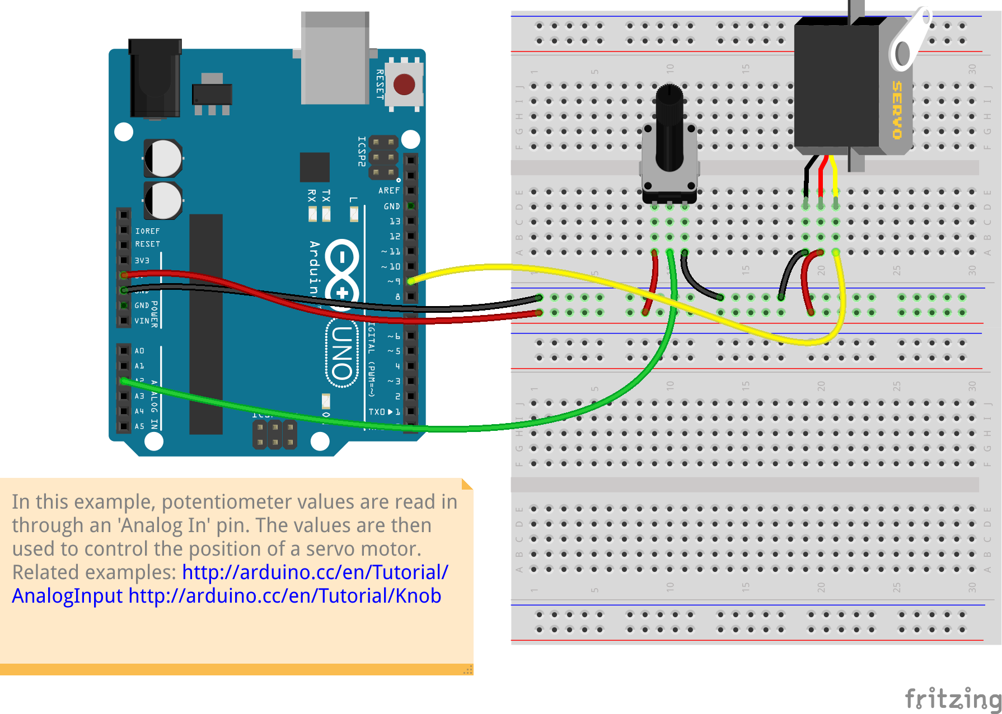
figures/AnalogInputToServo_bb.png
