eddygrinder/LaRE_LaTeX/figures/arduinomega.png

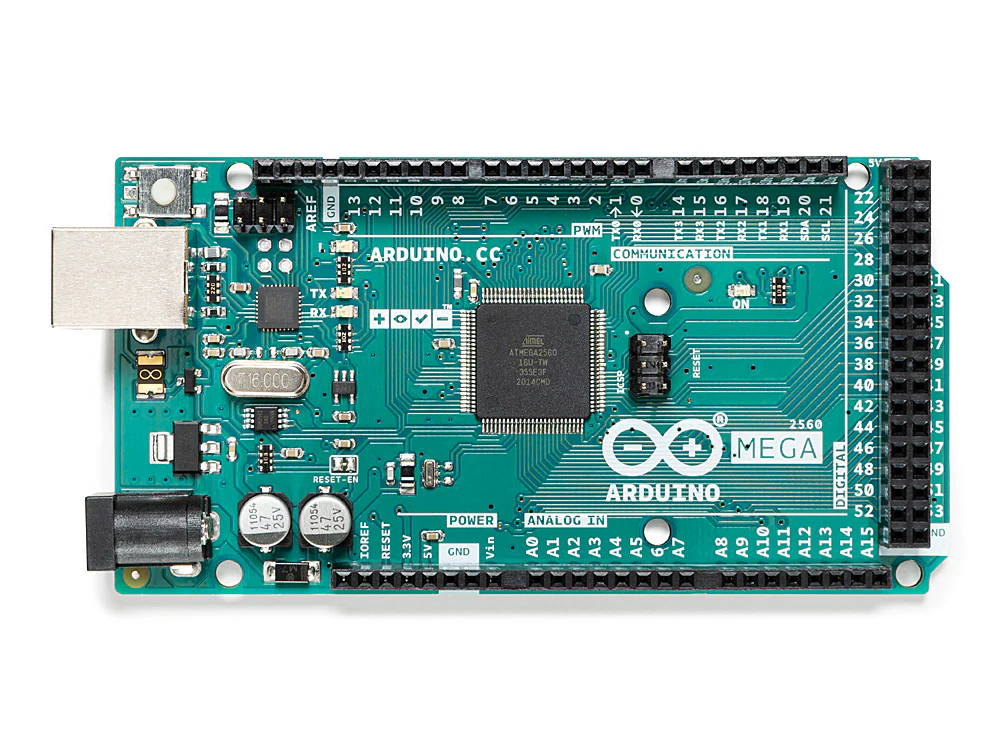
figures/arduinomega.png
