eddygrinder/LaRE_LaTeX/figures/arquitectura.drawio.png

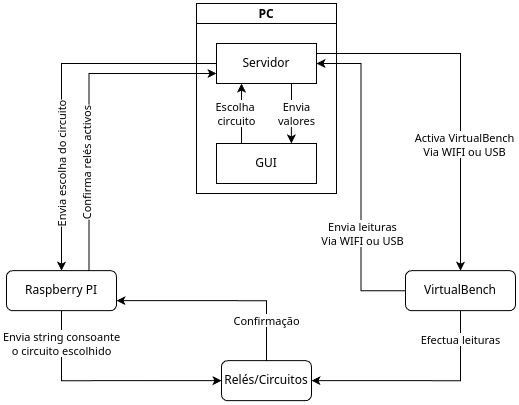
figures/arquitectura.drawio.png
