eddygrinder/LaRE_LaTeX/figures/arquitectura_geral_LaRE.png

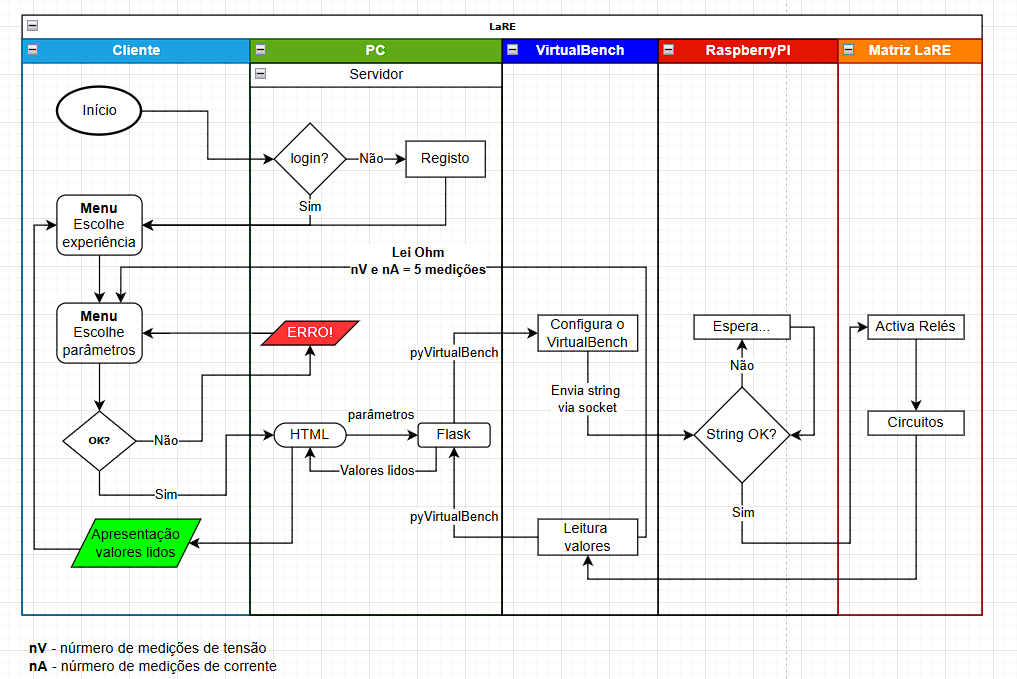
figures/arquitectura_geral_LaRE.png
