eddygrinder/LaRE_LaTeX/figures/arquitectura_ver2.drawio.png

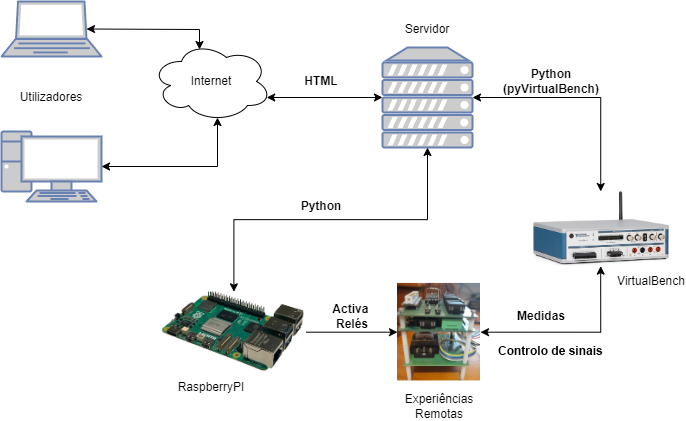
figures/arquitectura_ver2.drawio.png
