eddygrinder/LaRE_LaTeX/figures/arquitectura_VISIR.png

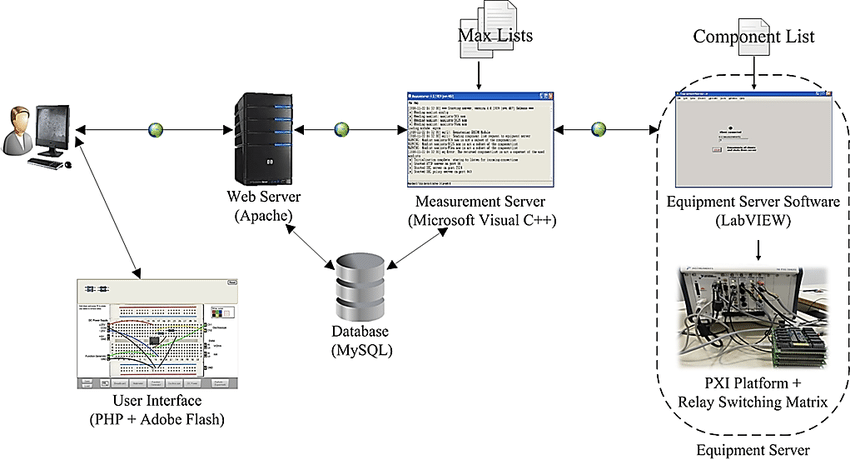
figures/arquitectura_VISIR.png
