eddygrinder/LaRE_LaTeX/figures/Astável-schematic.png

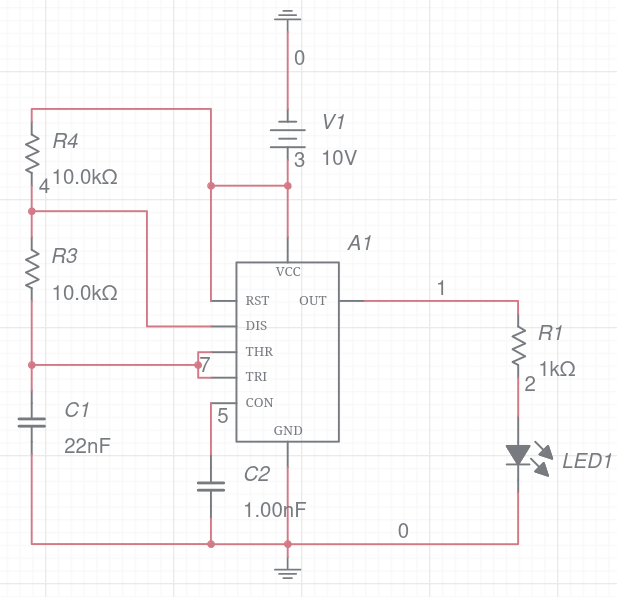
figures/Astável-schematic.png
