eddygrinder/LaRE_LaTeX/figures/boda_HPF_fc.png

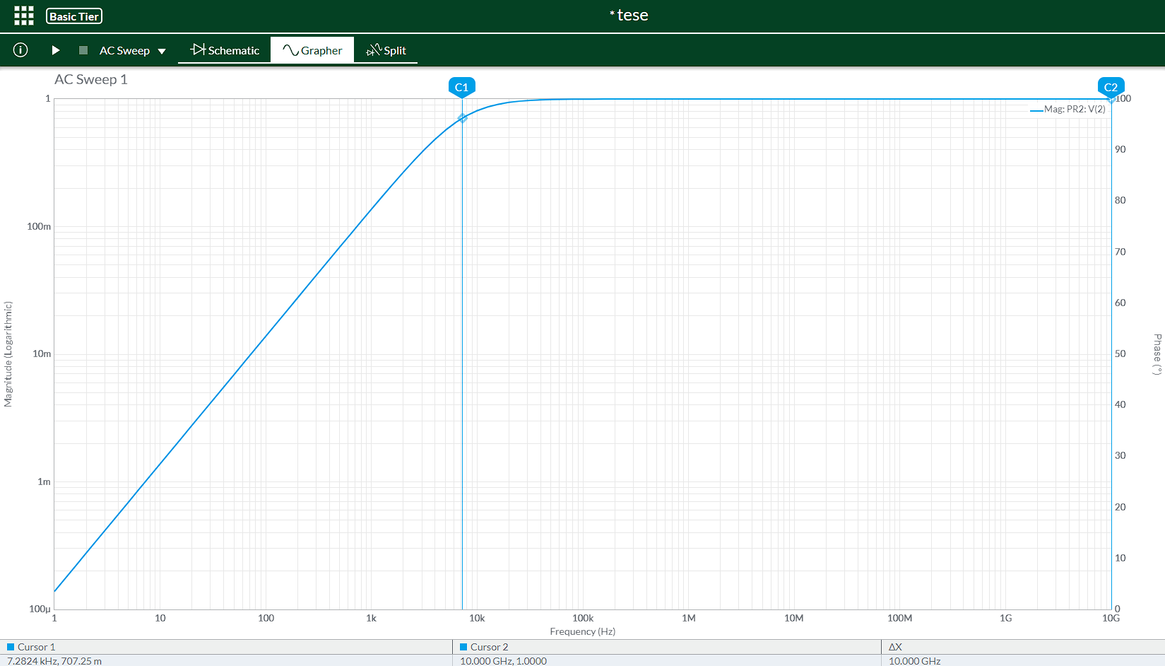
figures/boda_HPF_fc.png
