eddygrinder/LaRE_LaTeX/figures/boda_HPF_vout.png

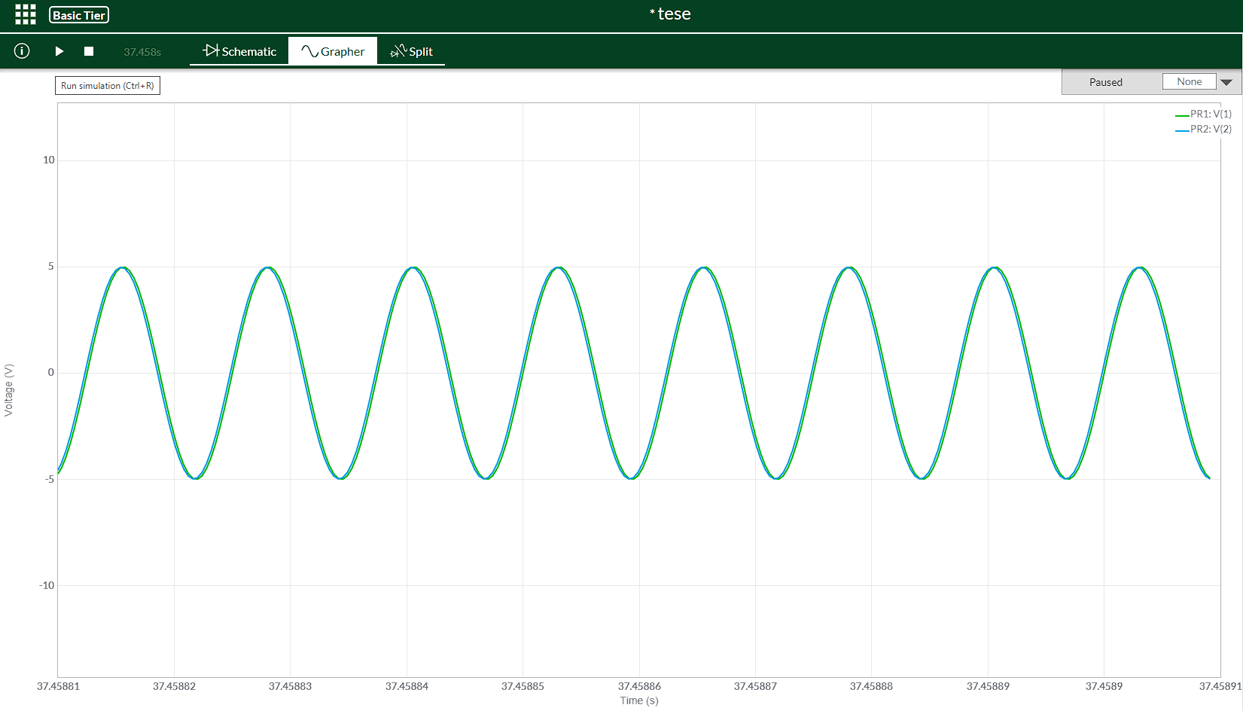
figures/boda_HPF_vout.png
