eddygrinder/LaRE_LaTeX/figures/boda_HPF_vout_fc.png

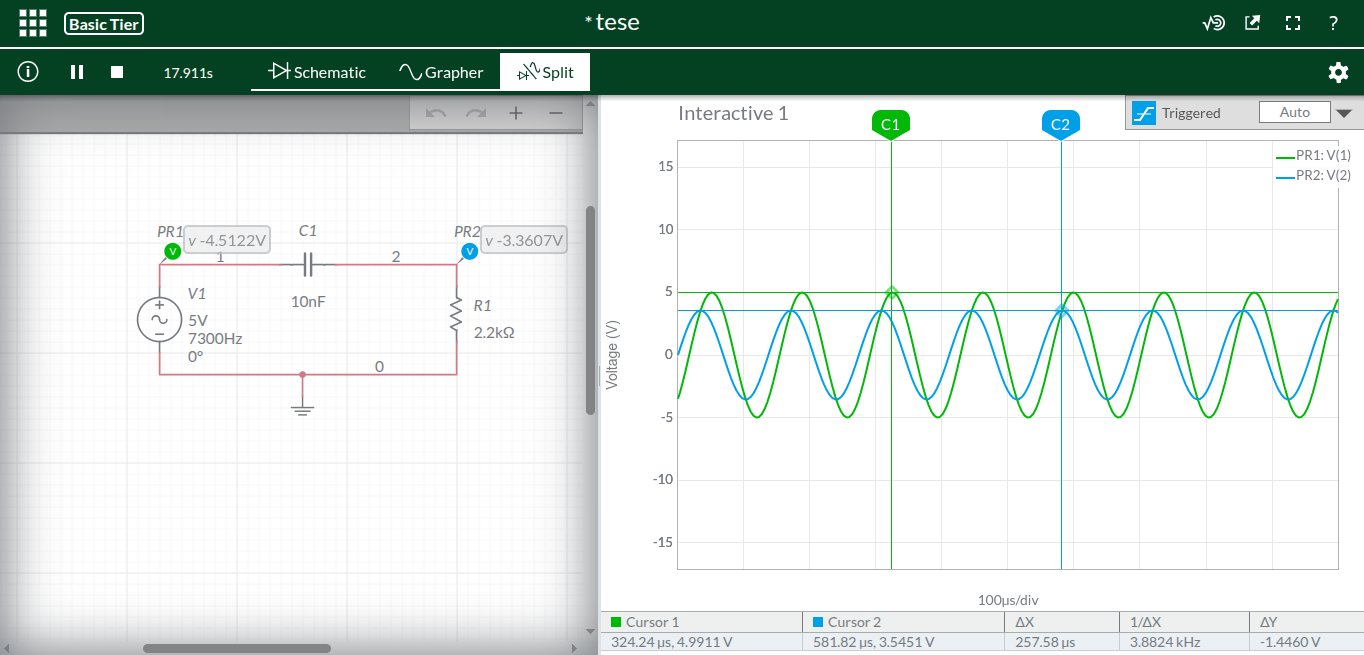
figures/boda_HPF_vout_fc.png
