eddygrinder/LaRE_LaTeX/figures/bode_hpf-10nF-2k2.png

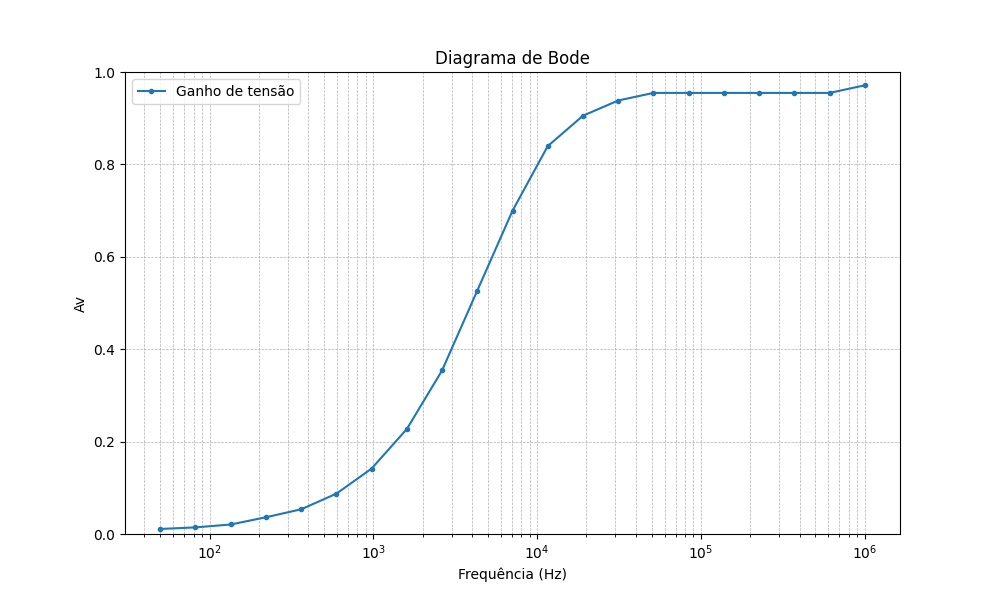
figures/bode_hpf-10nF-2k2.png
