eddygrinder/LaRE_LaTeX/figures/carac_lab.png

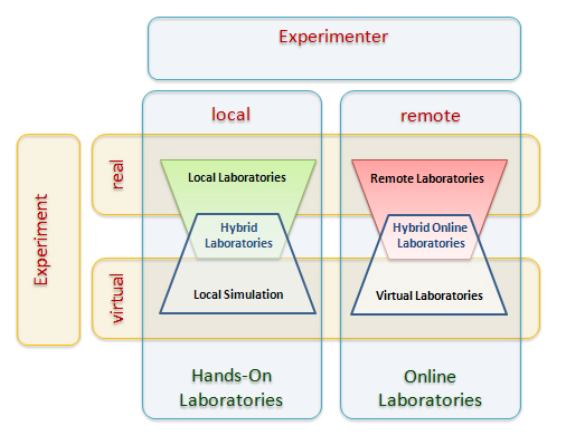
figures/carac_lab.png
