eddygrinder/LaRE_LaTeX/figures/caracteristica_laboratories.jpg

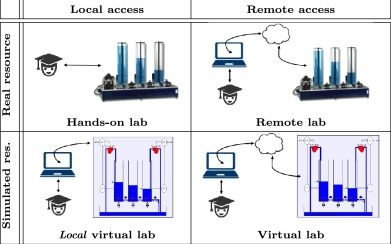
figures/caracteristica_laboratories.jpg
