eddygrinder/LaRE_LaTeX/figures/comandoreles_FULL.png

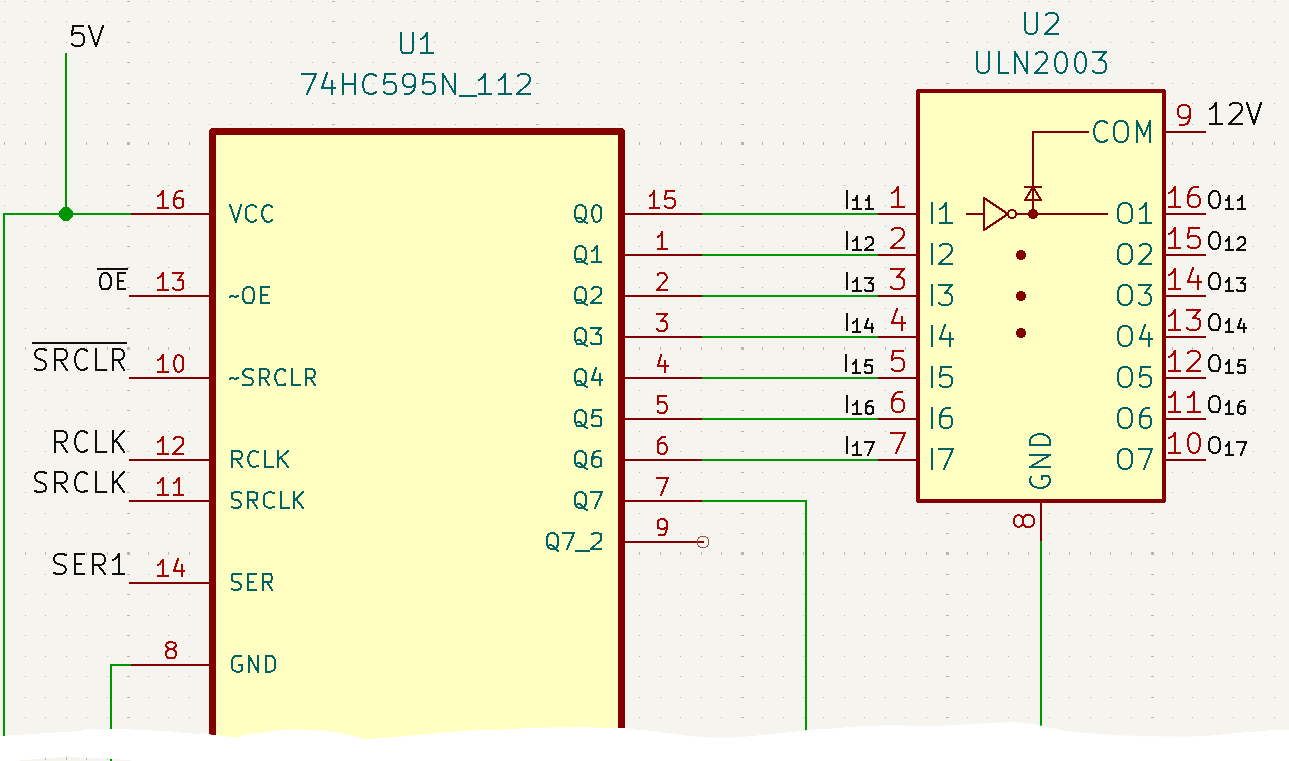
figures/comandoreles_FULL.png
