eddygrinder/LaRE_LaTeX/figures/Diagrama_simplificado.drawio.png

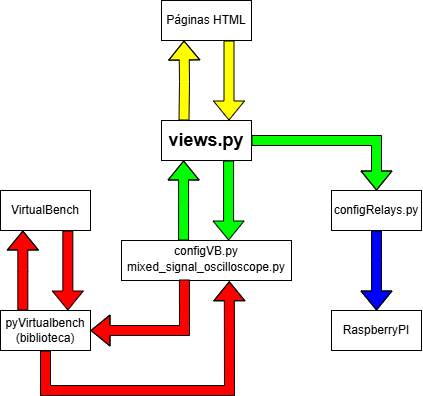
figures/Diagrama_simplificado.drawio.png
