eddygrinder/LaRE_LaTeX/figures/Diagrama_SOFTWARE.drawio.png

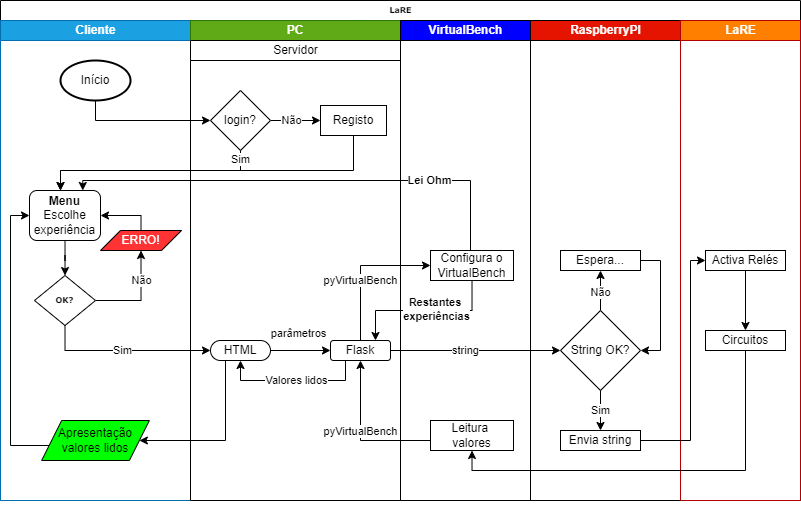
figures/Diagrama_SOFTWARE.drawio.png
