eddygrinder/LaRE_LaTeX/figures/diagramablocosrectificacao.png

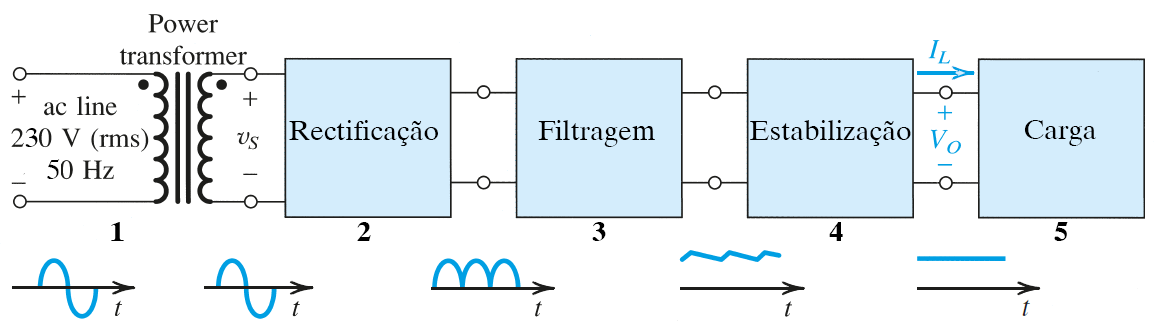
figures/diagramablocosrectificacao.png
