eddygrinder/LaRE_LaTeX/figures/diesel.png

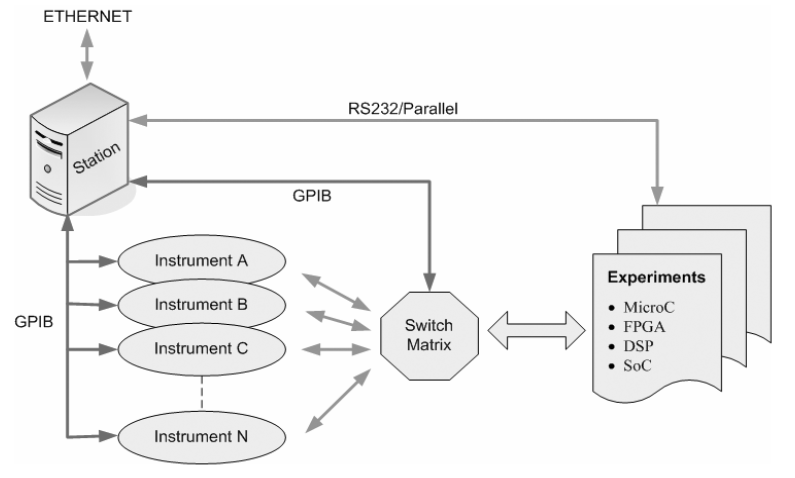
figures/diesel.png
