eddygrinder/LaRE_LaTeX/figures/erro_pagina.png

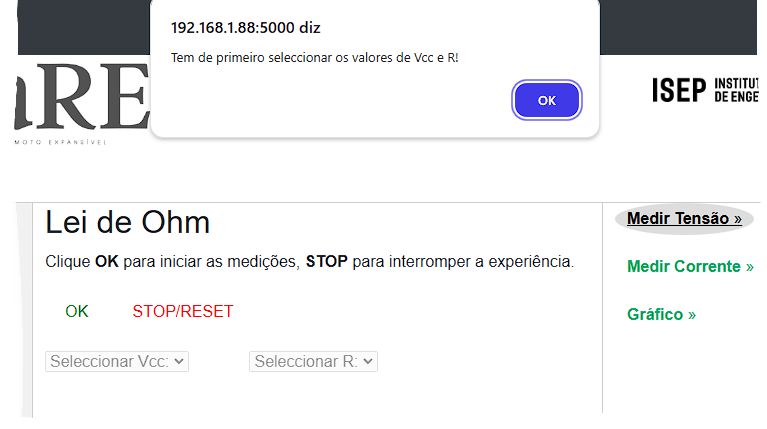
figures/erro_pagina.png
