eddygrinder/LaRE_LaTeX/figures/ESP32-DevKitC_L_0.png

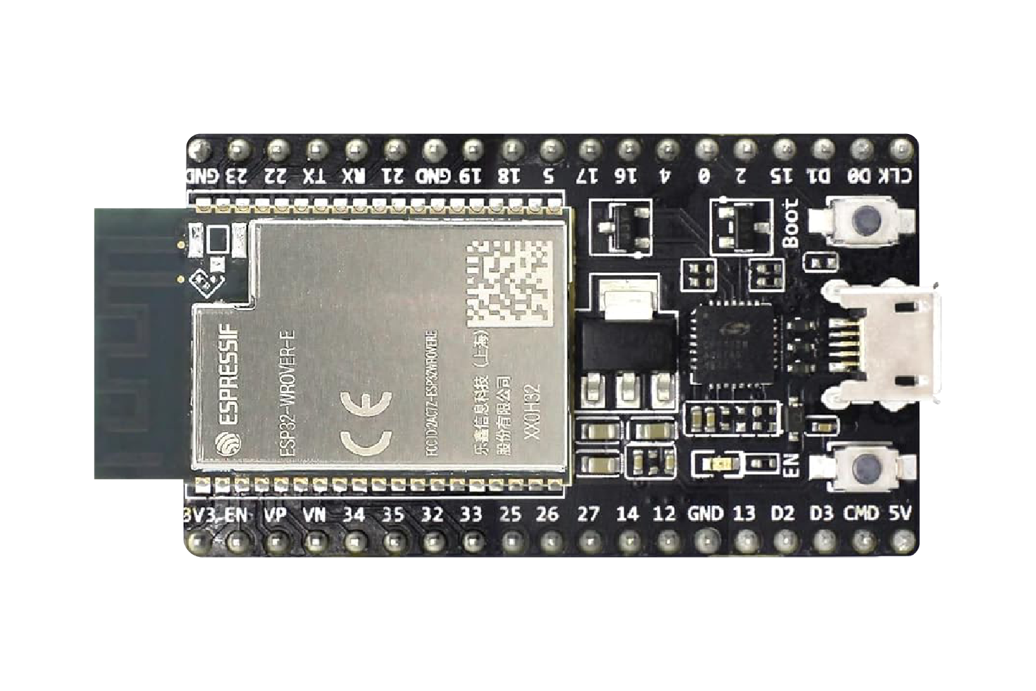
figures/ESP32-DevKitC_L_0.png
