eddygrinder/LaRE_LaTeX/figures/esquema_simplificado_OHM.png

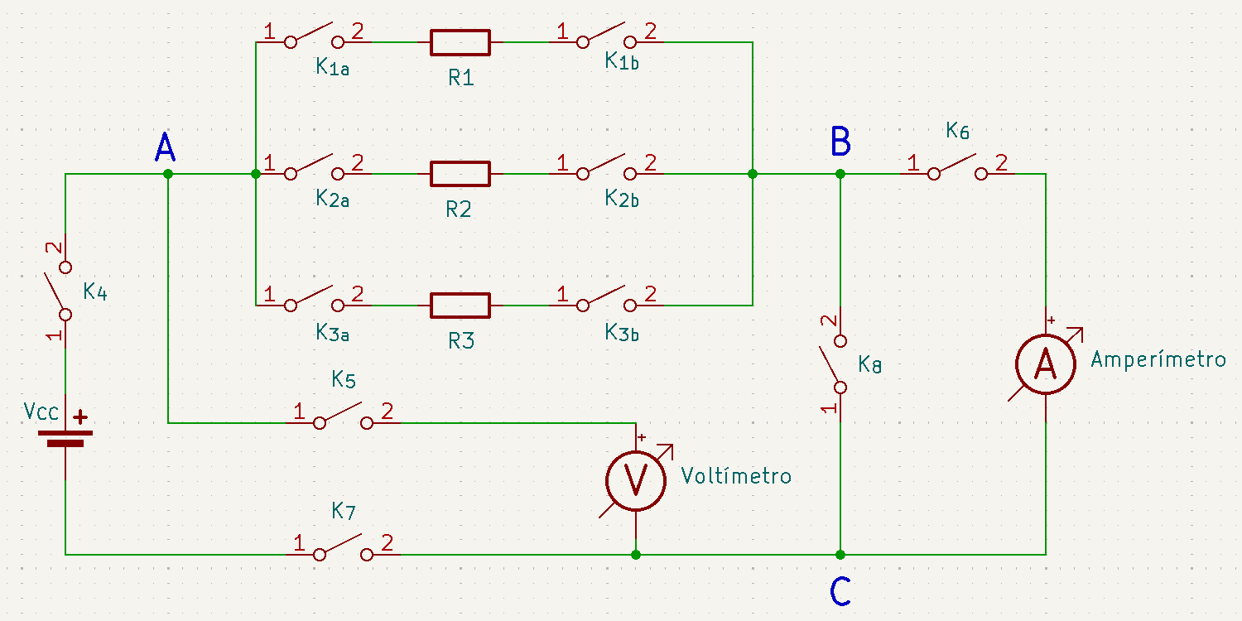
figures/esquema_simplificado_OHM.png
