eddygrinder/LaRE_LaTeX/figures/esquema_simplificado_OHM_IDEAL.png

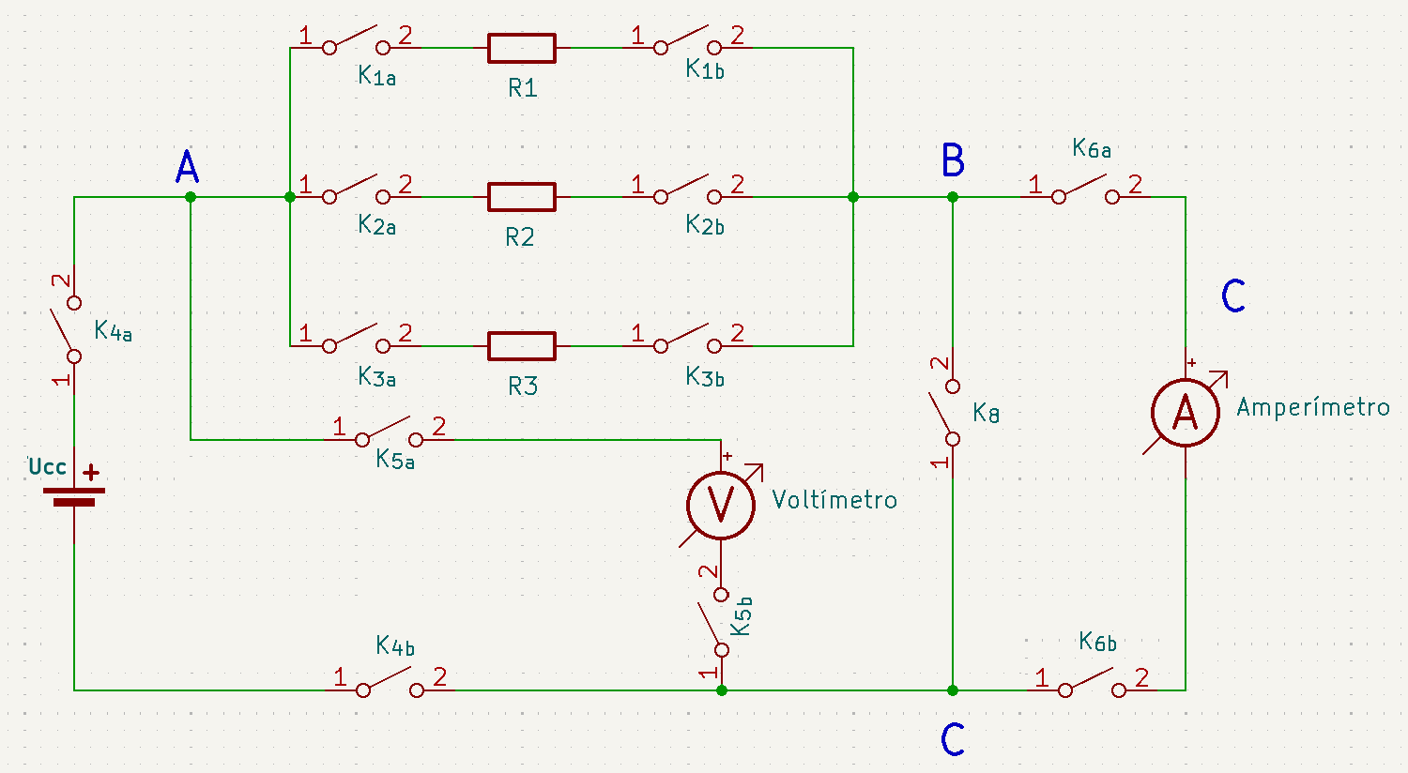
figures/esquema_simplificado_OHM_IDEAL.png
