eddygrinder/LaRE_LaTeX/figures/esquematico_rele.png

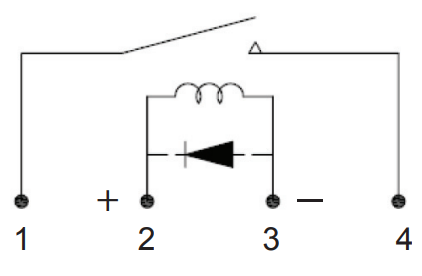
figures/esquematico_rele.png
