eddygrinder/LaRE_LaTeX/figures/exemplo_reles_spst.png

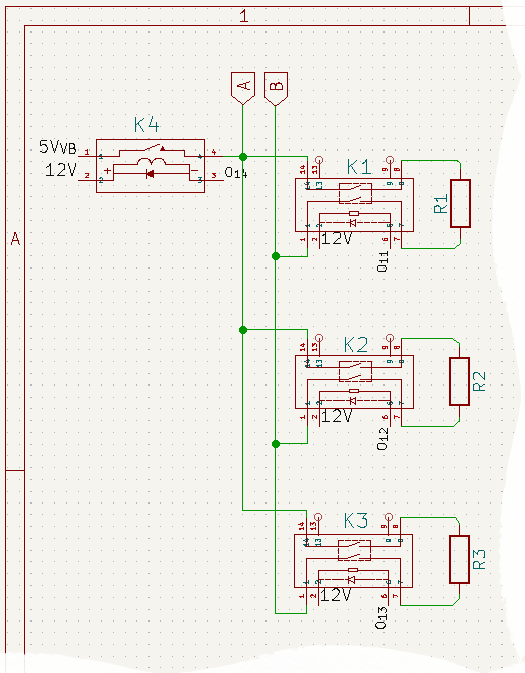
figures/exemplo_reles_spst.png
