eddygrinder/LaRE_LaTeX/figures/exemplo_voltimetro.png

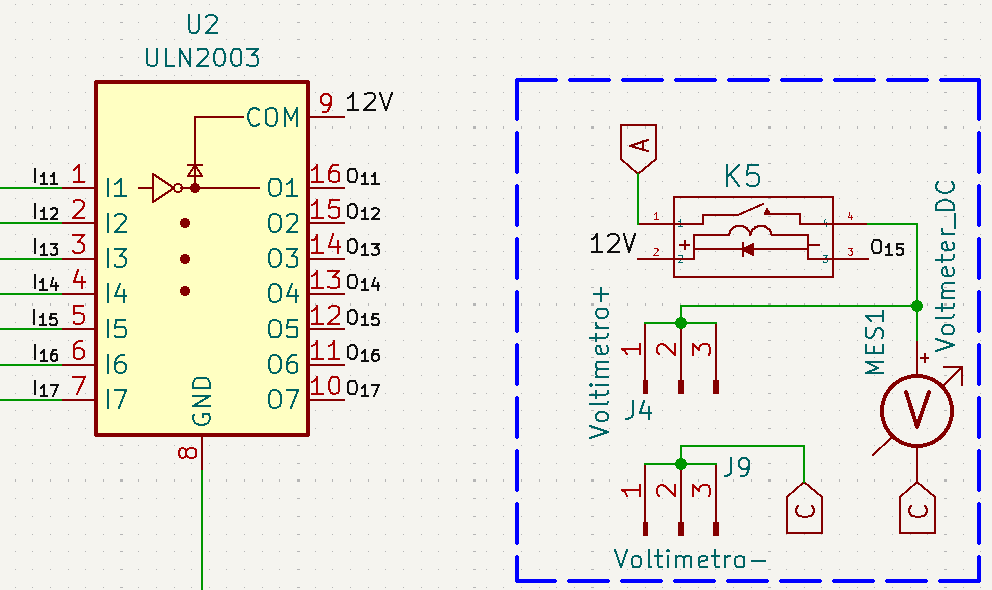
figures/exemplo_voltimetro.png
