eddygrinder/LaRE_LaTeX/figures/experiencia_ohm_diagrama.drawio.png

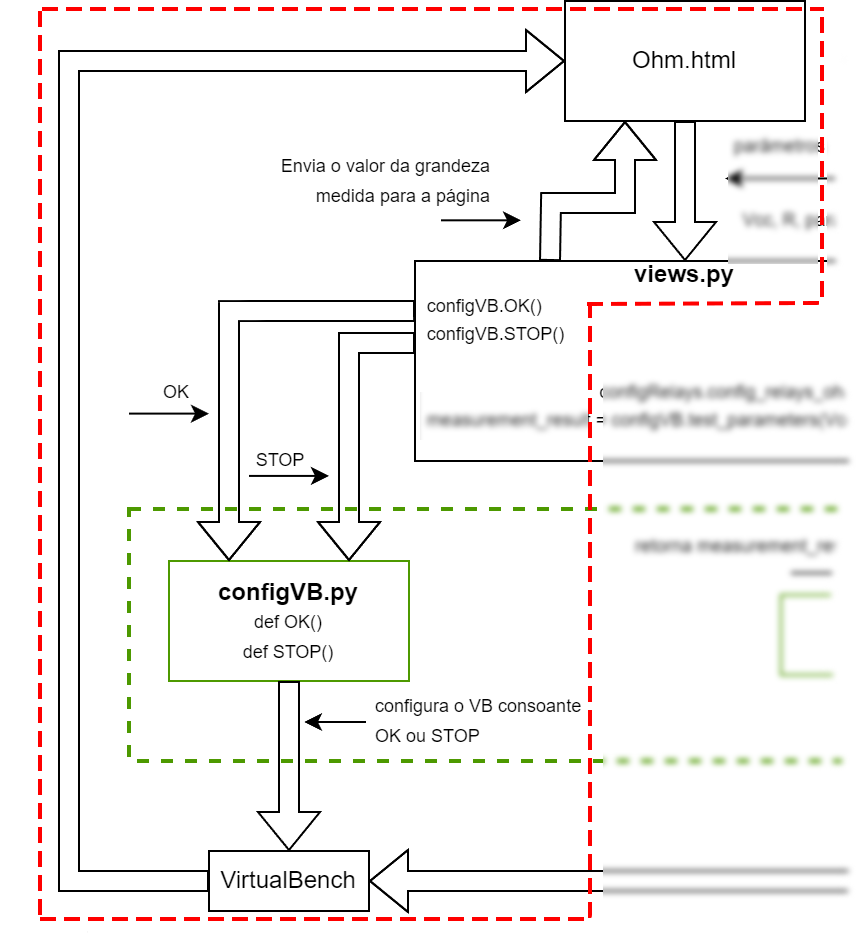
figures/experiencia_ohm_diagrama.drawio.png
