eddygrinder/LaRE_LaTeX/figures/falstad.png

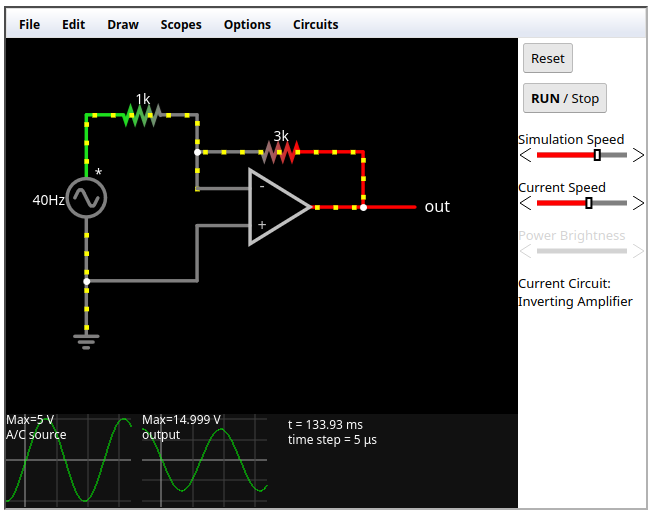
figures/falstad.png
