eddygrinder/LaRE_LaTeX/figures/filtro_PA_simplificado.png

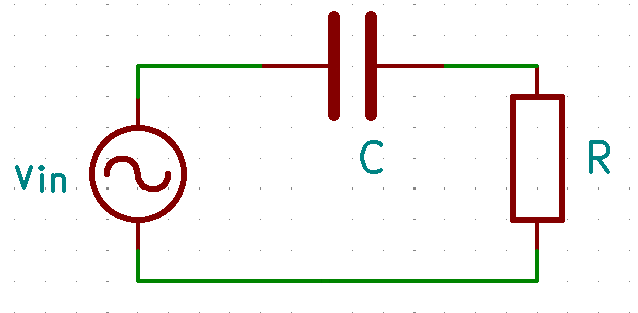
figures/filtro_PA_simplificado.png
