eddygrinder/LaRE_LaTeX/figures/filtro_passa-alto.png

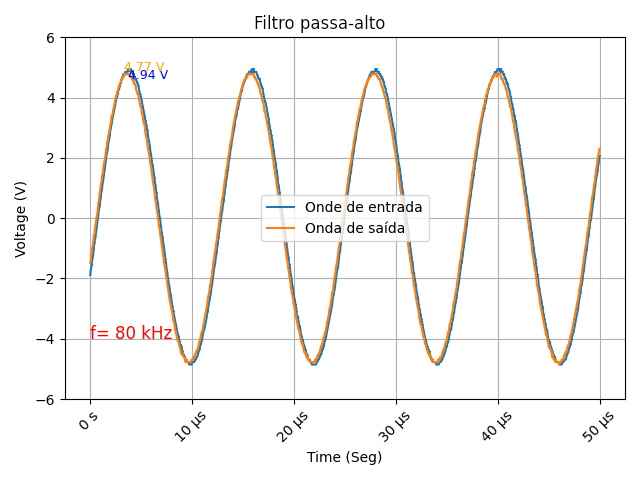
figures/filtro_passa-alto.png
