eddygrinder/LaRE_LaTeX/figures/filtro_PB_simplificado.png

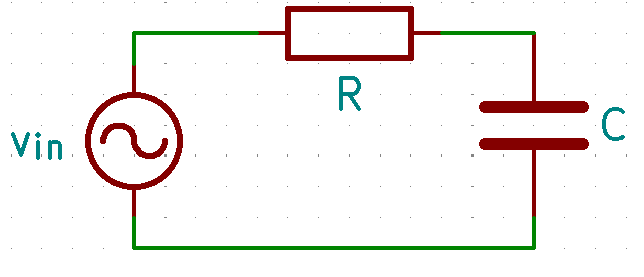
figures/filtro_PB_simplificado.png
