eddygrinder/LaRE_LaTeX/figures/filtros.png

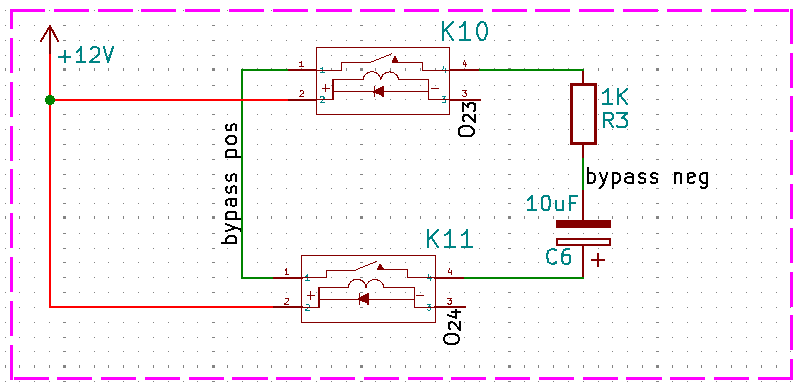
figures/filtros.png
