eddygrinder/LaRE_LaTeX/figures/filtros_simplificado.png

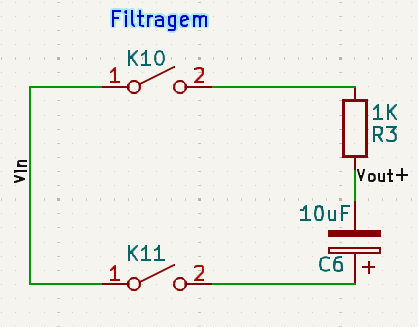
figures/filtros_simplificado.png
