eddygrinder/LaRE_LaTeX/figures/fluxograma_flask.drawio.png

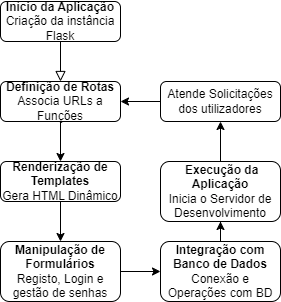
figures/fluxograma_flask.drawio.png
