eddygrinder/LaRE_LaTeX/figures/fontes_VB.png

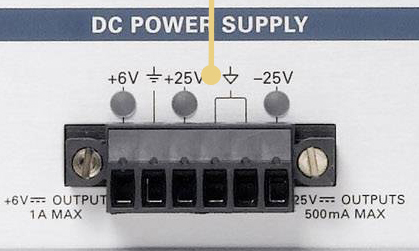
figures/fontes_VB.png
