eddygrinder/LaRE_LaTeX/figures/fritzing.png

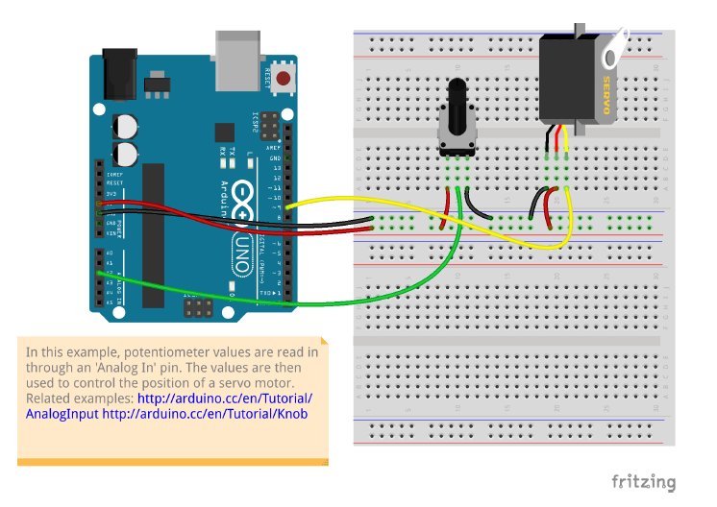
figures/fritzing.png
