eddygrinder/LaRE_LaTeX/figures/g4l_general_architecture.png

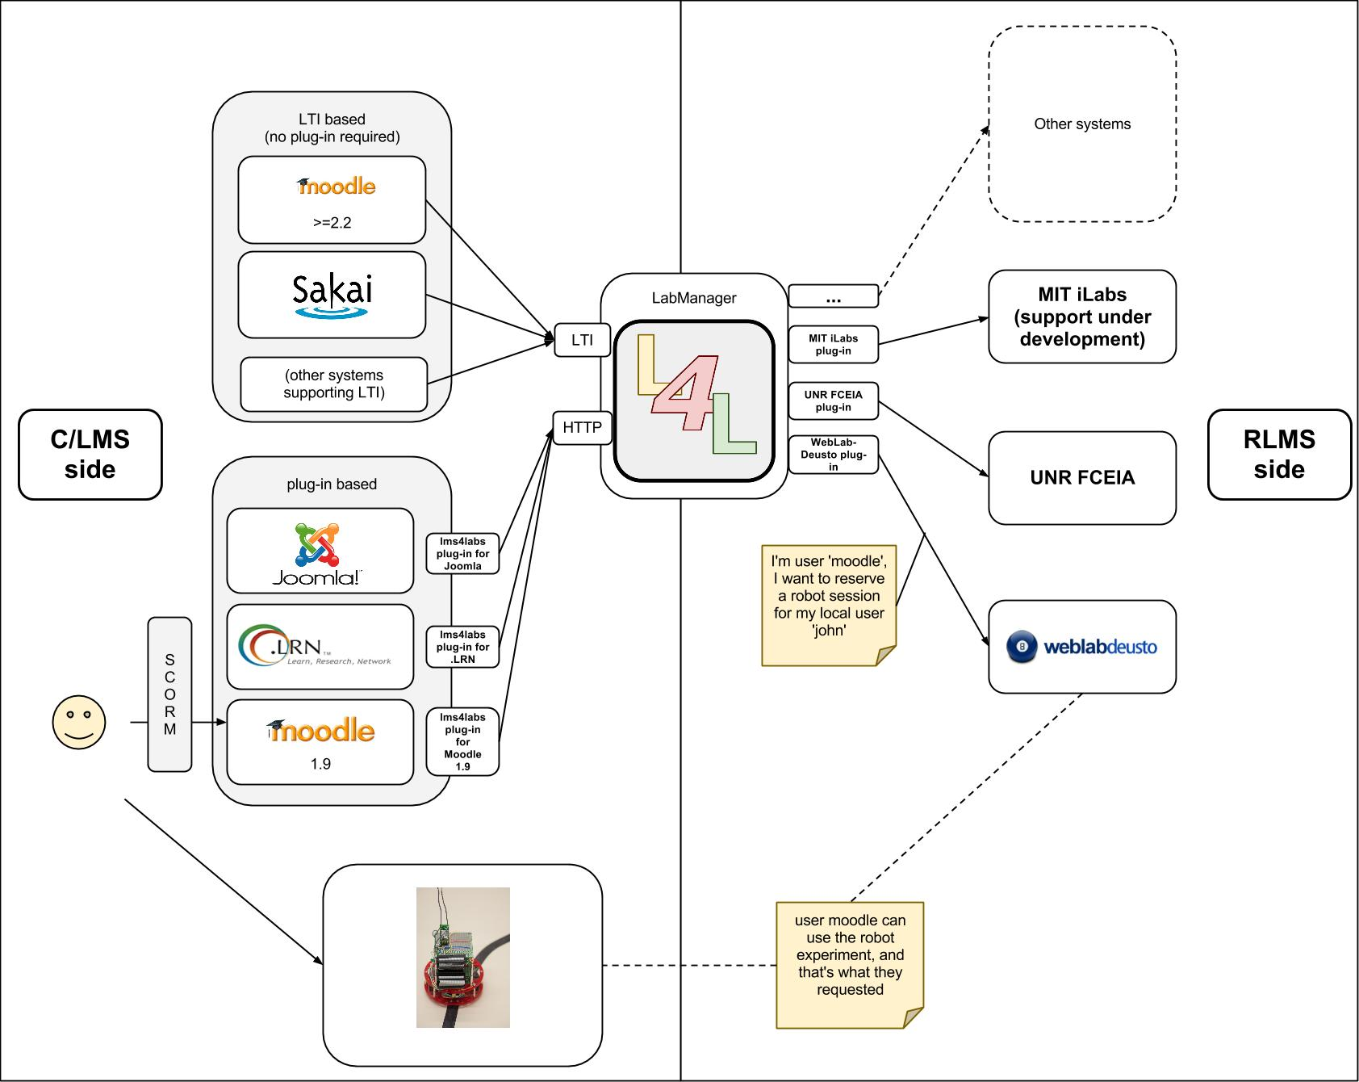
figures/g4l_general_architecture.png
