eddygrinder/LaRE_LaTeX/figures/grafico_Ohm.png

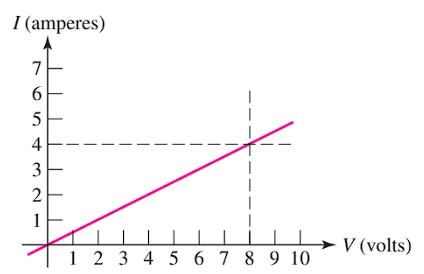
figures/grafico_Ohm.png
