eddygrinder/LaRE_LaTeX/figures/html_page_structure.png

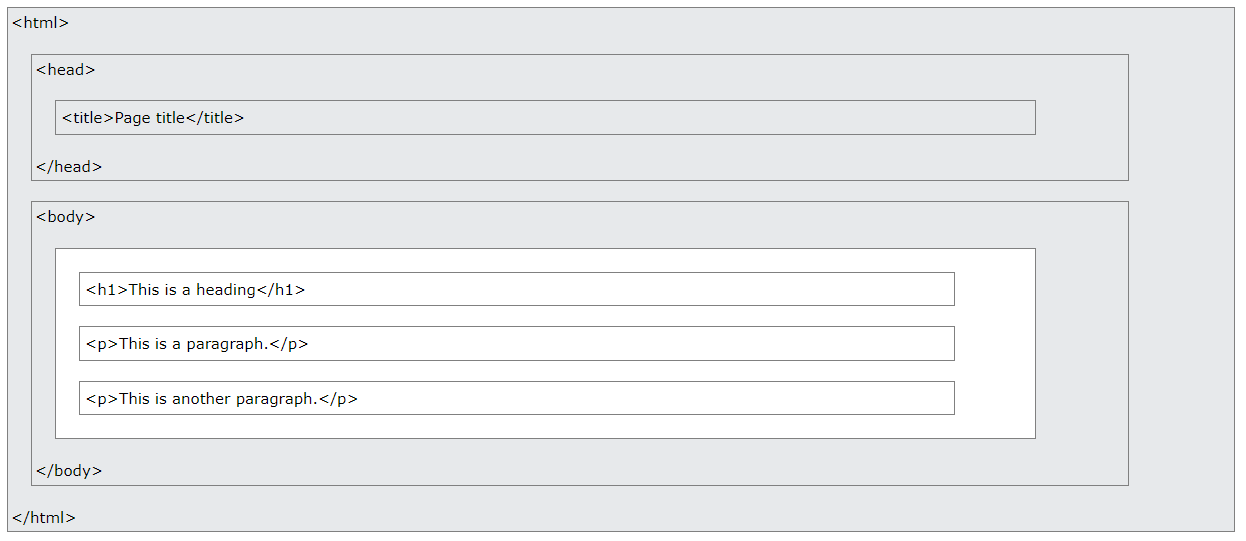
figures/html_page_structure.png
