eddygrinder/LaRE_LaTeX/figures/ict-specialists-total.png

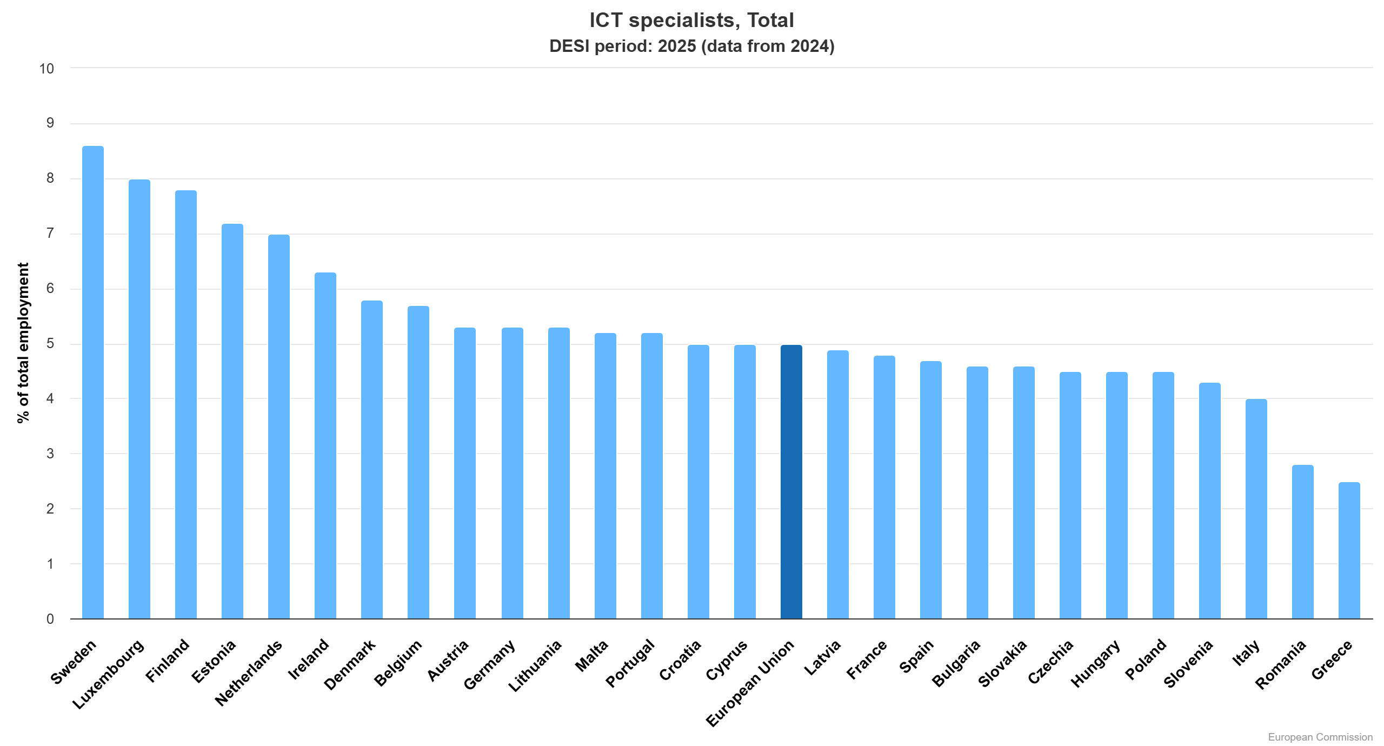
figures/ict-specialists-total.png
