eddygrinder/LaRE_LaTeX/figures/idc40pinMF.png

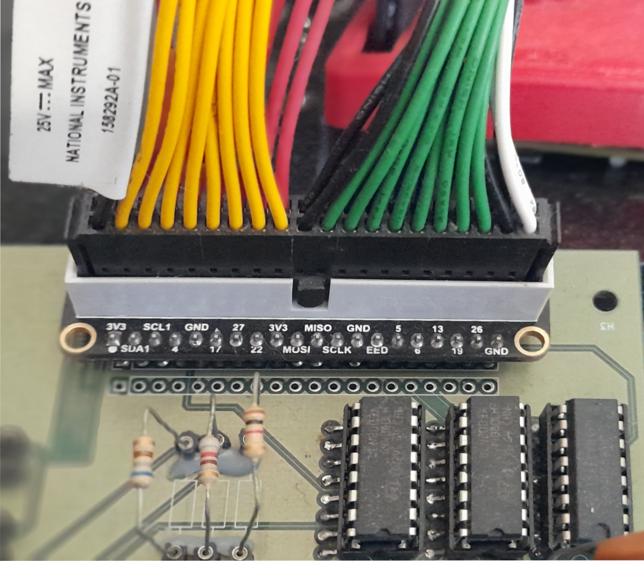
figures/idc40pinMF.png
