eddygrinder/LaRE_LaTeX/figures/implementacao_ohm_graph.png

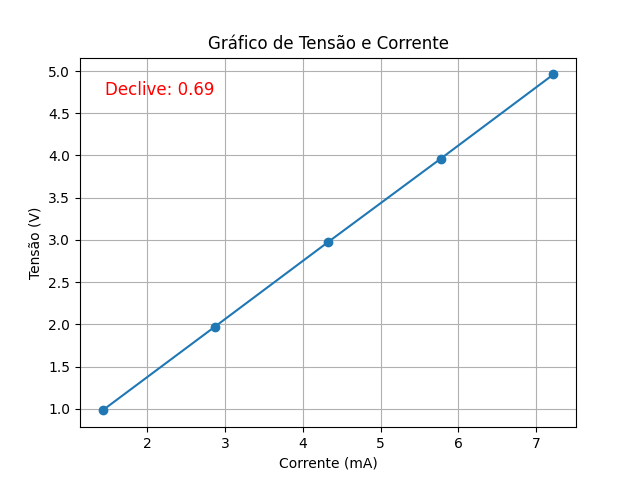
figures/implementacao_ohm_graph.png
