eddygrinder/LaRE_LaTeX/figures/internet-use-all-individ.png

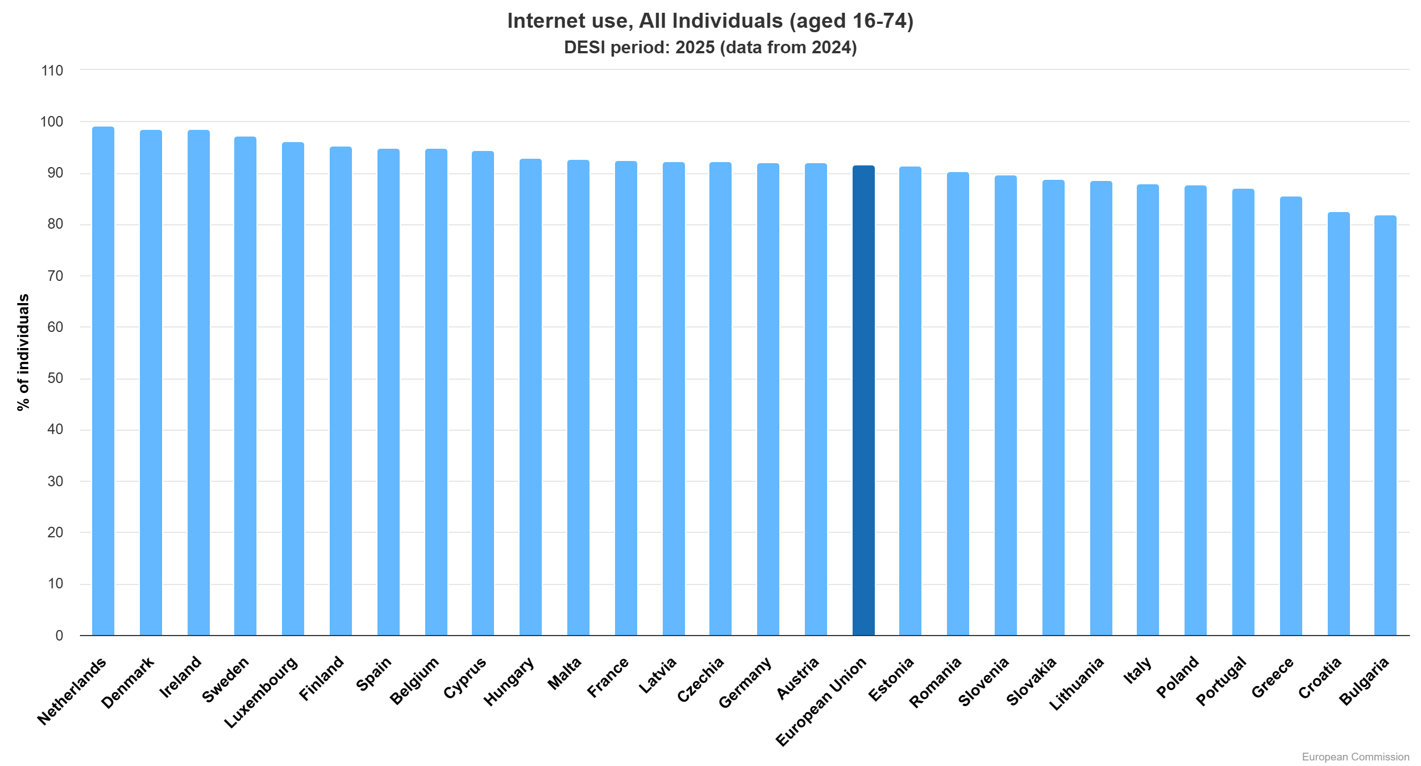
figures/internet-use-all-individ.png
