eddygrinder/LaRE_LaTeX/figures/internet-use-individuals-54-74.png

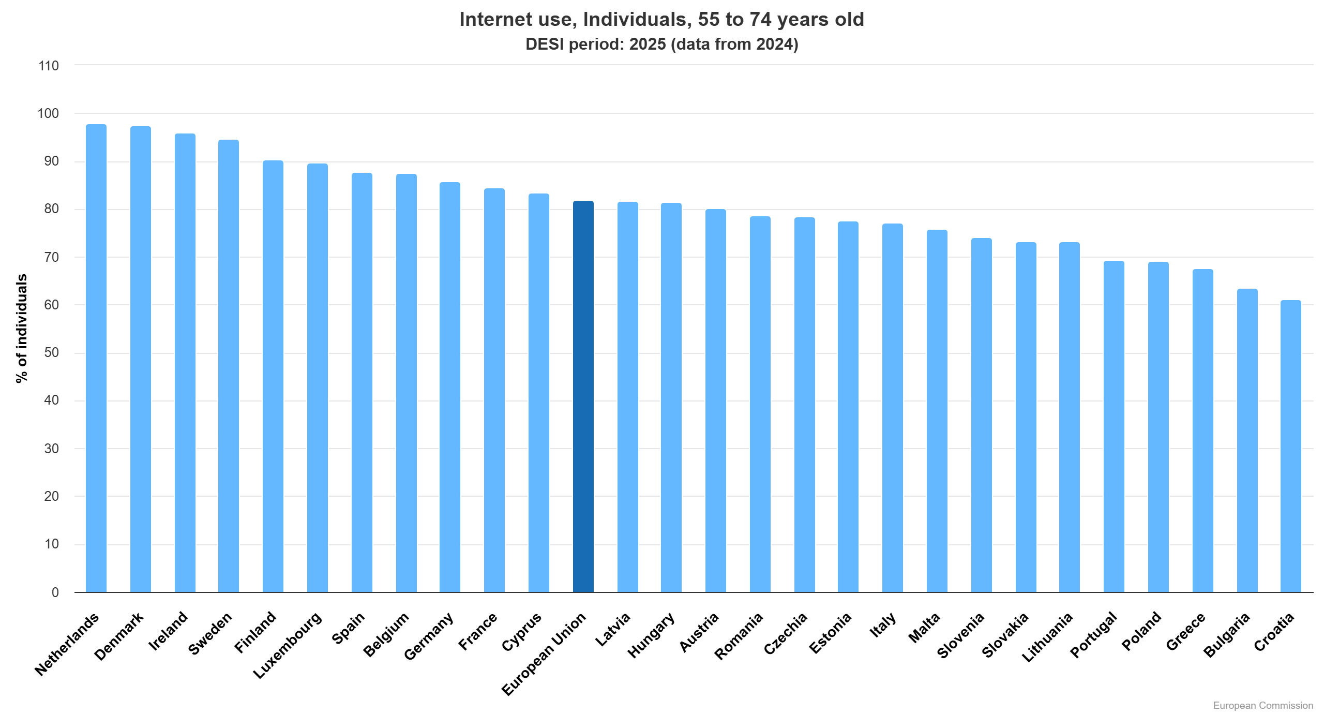
figures/internet-use-individuals-54-74.png
