eddygrinder/LaRE_LaTeX/figures/isa_architecture.png

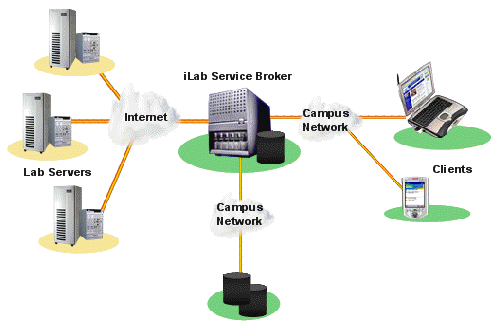
figures/isa_architecture.png
