eddygrinder/LaRE_LaTeX/figures/ITU-InternetUse.png

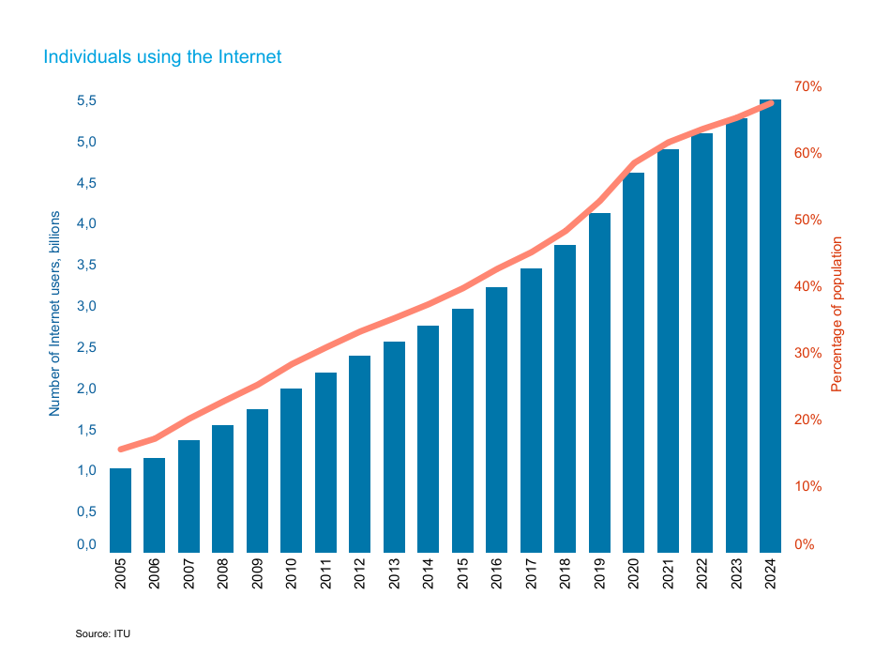
figures/ITU-InternetUse.png
