eddygrinder/LaRE_LaTeX/figures/kaluz.png

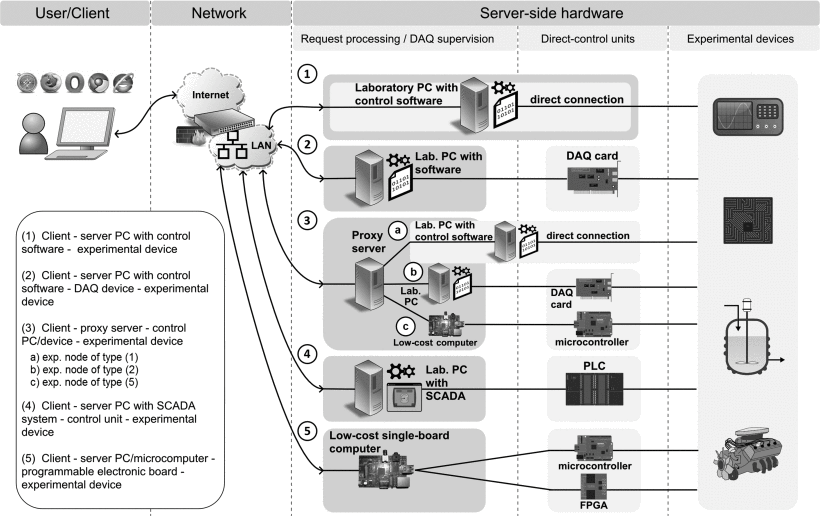
figures/kaluz.png
