eddygrinder/LaRE_LaTeX/figures/lm317.png

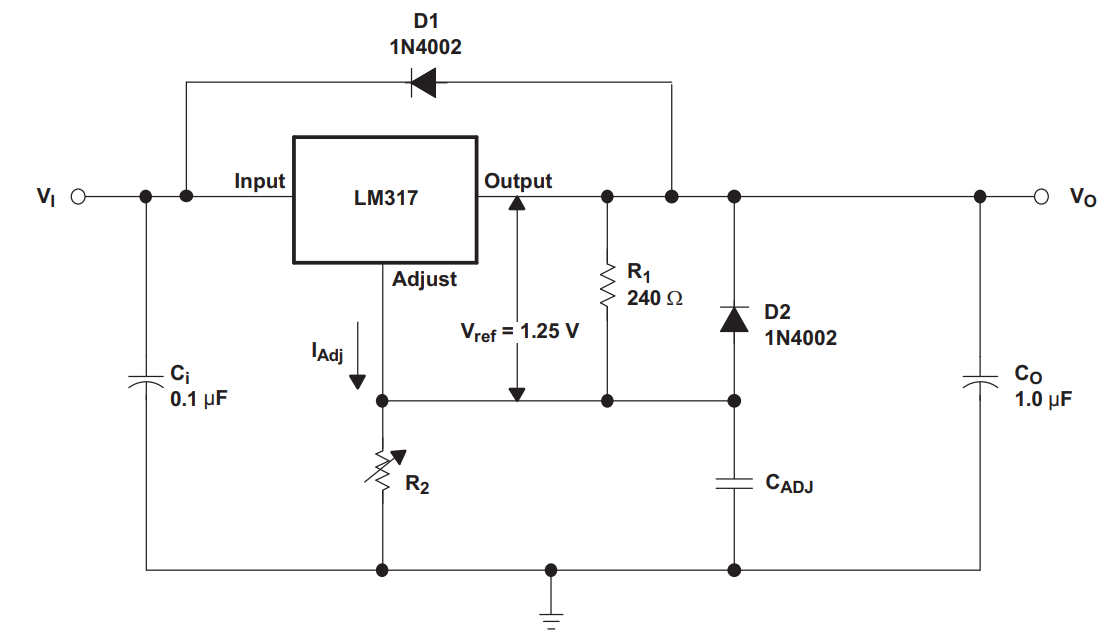
figures/lm317.png
