eddygrinder/LaRE_LaTeX/figures/local_architecture.png

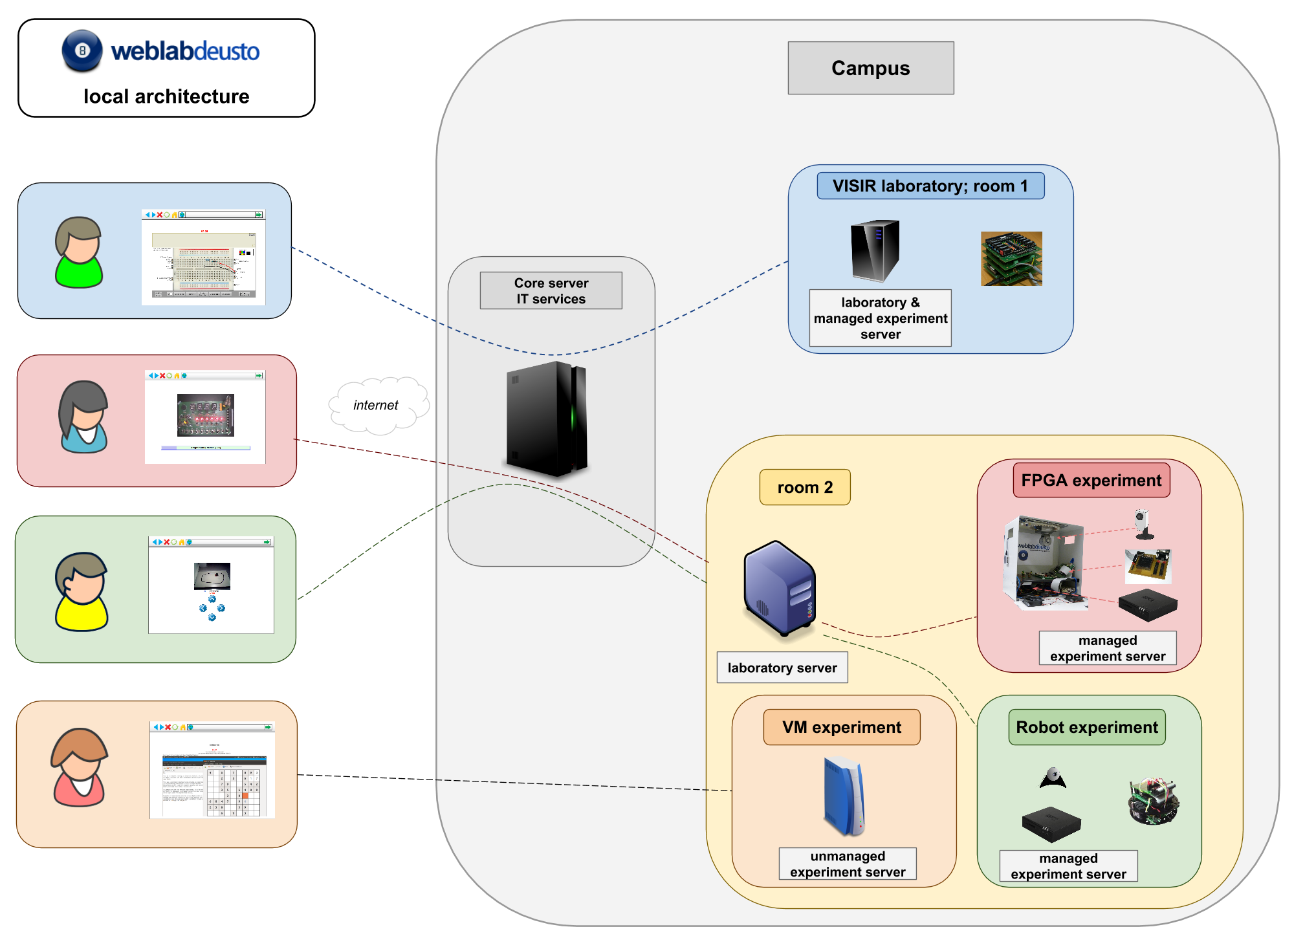
figures/local_architecture.png
