eddygrinder/LaRE_LaTeX/figures/login.png

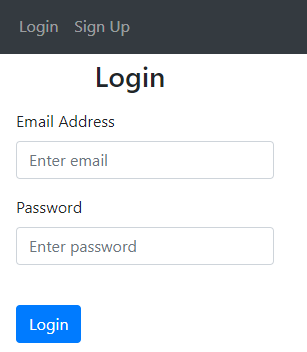
figures/login.png
