eddygrinder/LaRE_LaTeX/figures/matriz.png

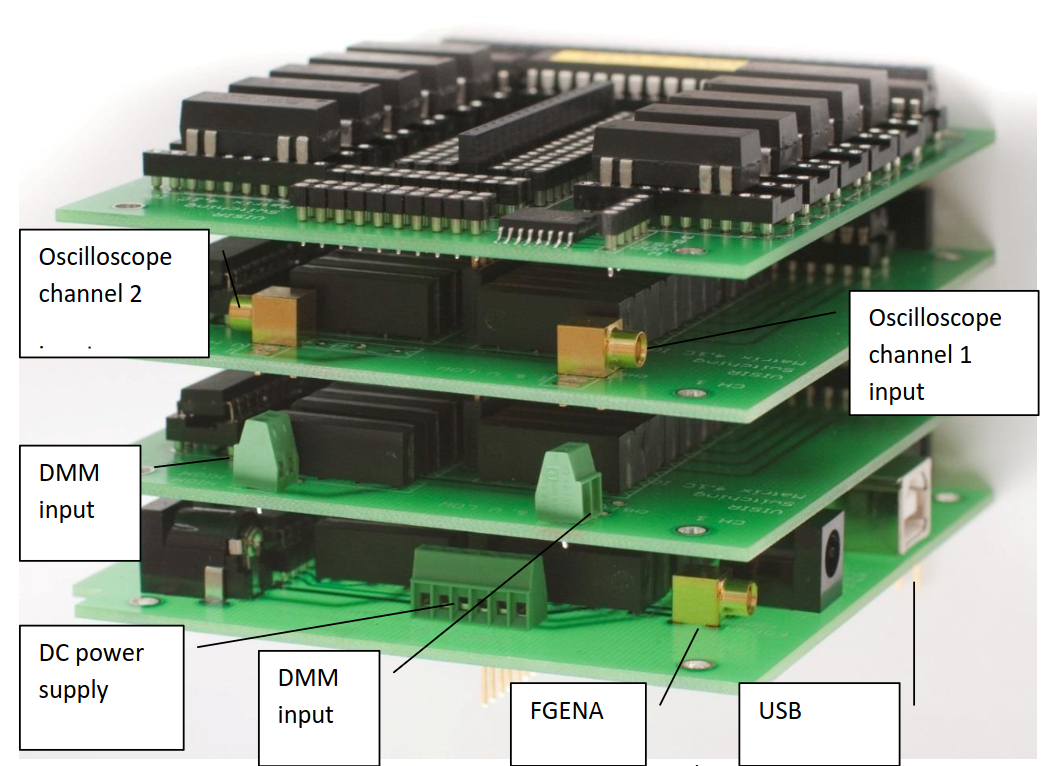
figures/matriz.png
