eddygrinder/LaRE_LaTeX/figures/medicoes_OHM.drawio.png

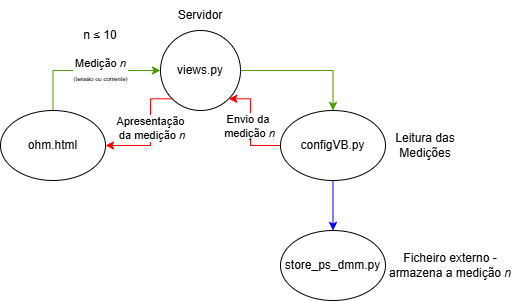
figures/medicoes_OHM.drawio.png
