eddygrinder/LaRE_LaTeX/figures/meia_onda_Sedra.png

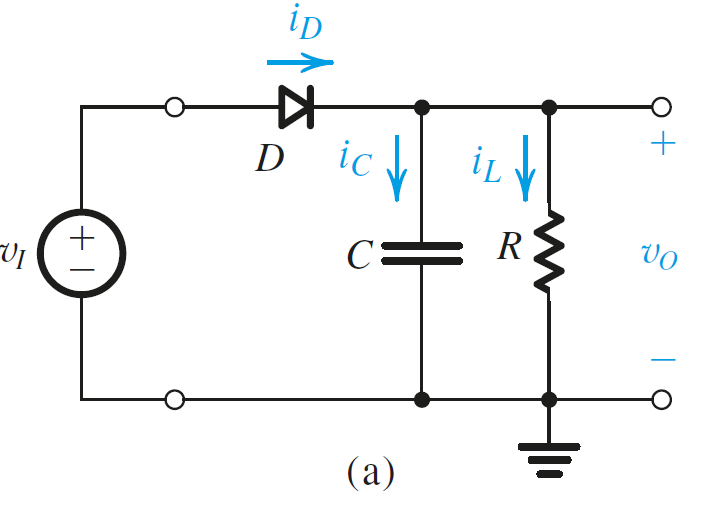
figures/meia_onda_Sedra.png
