eddygrinder/LaRE_LaTeX/figures/meiaonda-4.7-2.2.png

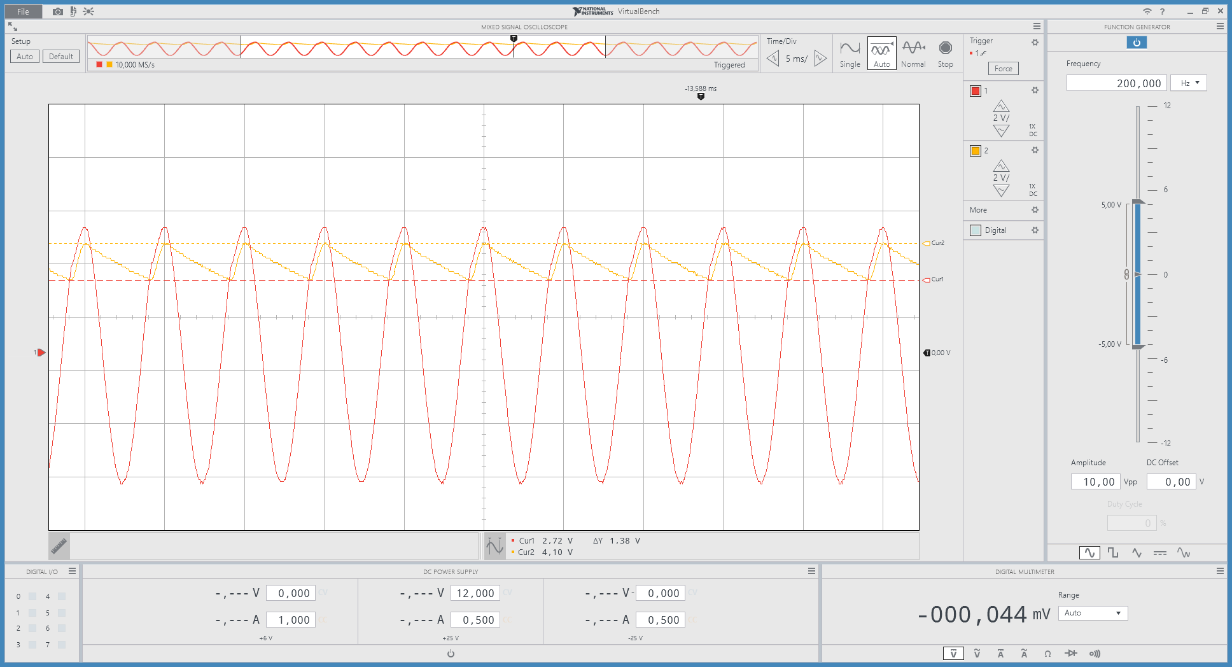
figures/meiaonda-4.7-2.2.png
