eddygrinder/LaRE_LaTeX/figures/meiaonda_page_controlo-FULL.png

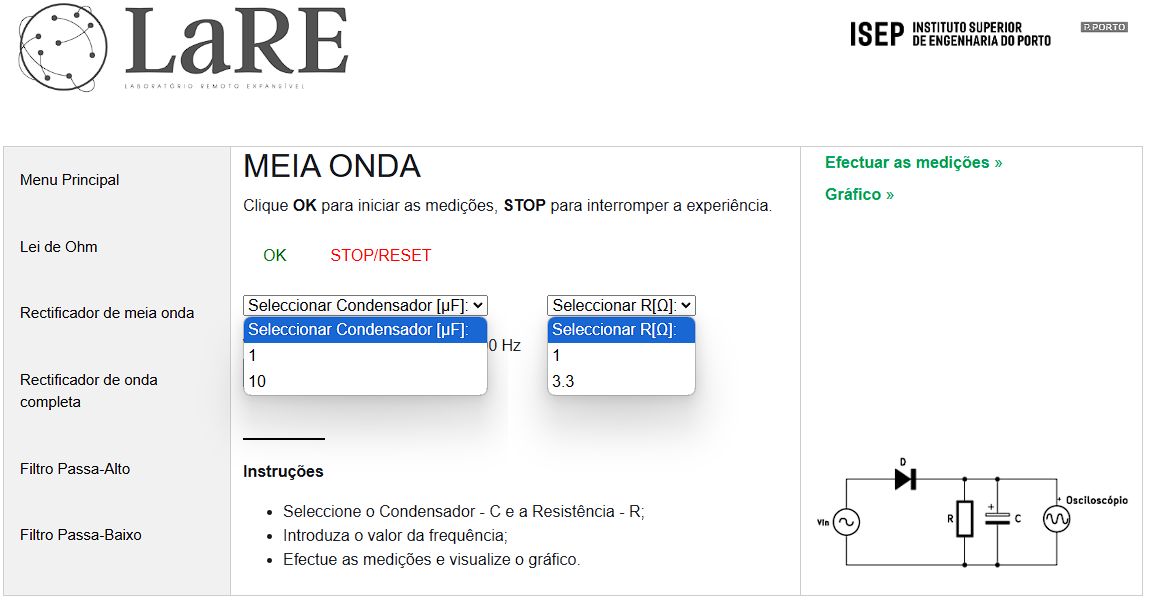
figures/meiaonda_page_controlo-FULL.png
