eddygrinder/LaRE_LaTeX/figures/MeiaOndaSimplificado.png

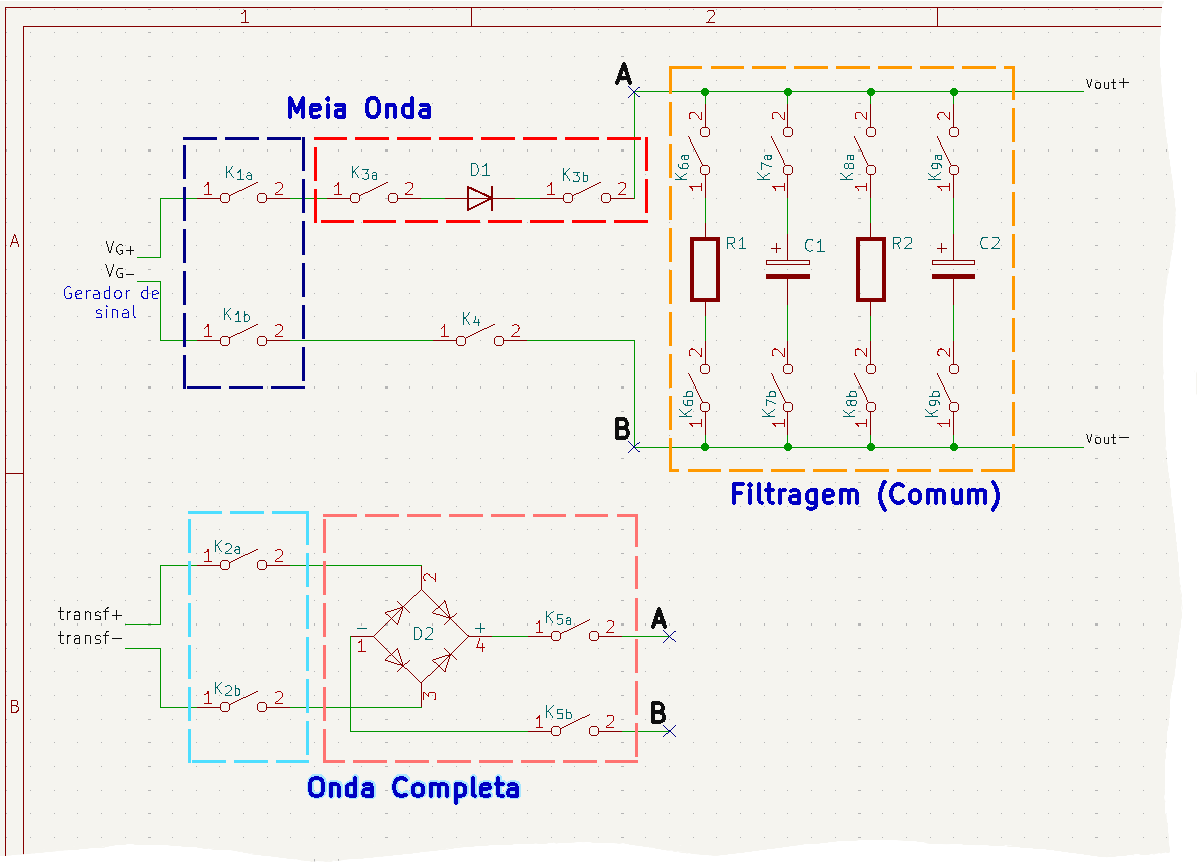
figures/MeiaOndaSimplificado.png
