eddygrinder/LaRE_LaTeX/figures/MeiaOndaSimplificado_VER2.png

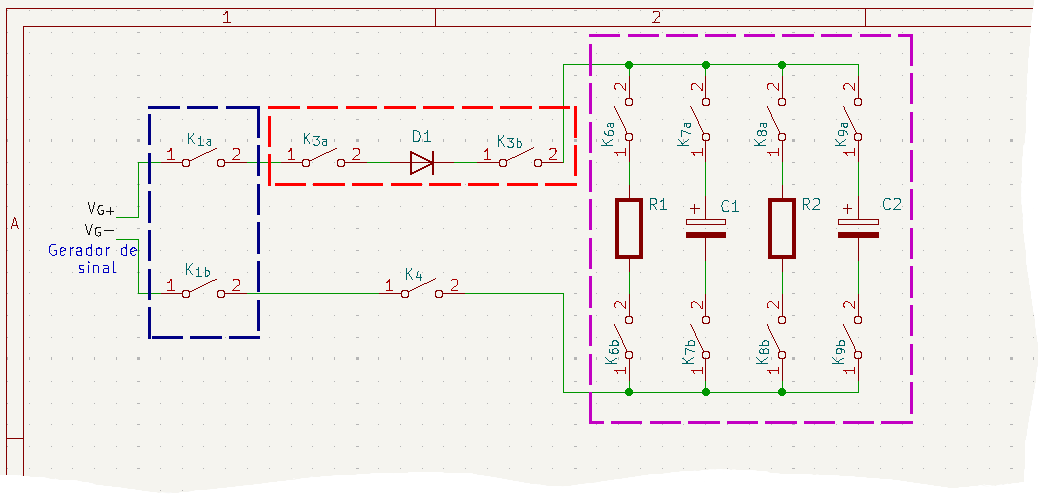
figures/MeiaOndaSimplificado_VER2.png
