eddygrinder/LaRE_LaTeX/figures/menupage.png

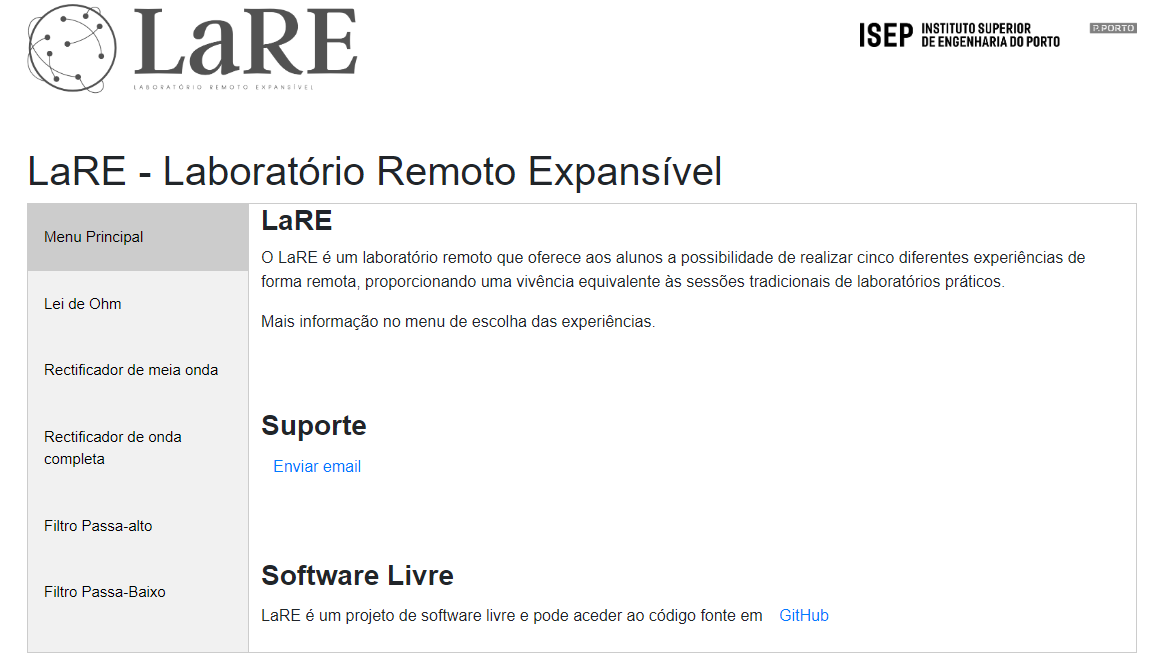
figures/menupage.png
