eddygrinder/LaRE_LaTeX/figures/Multisim_ACsweep.png

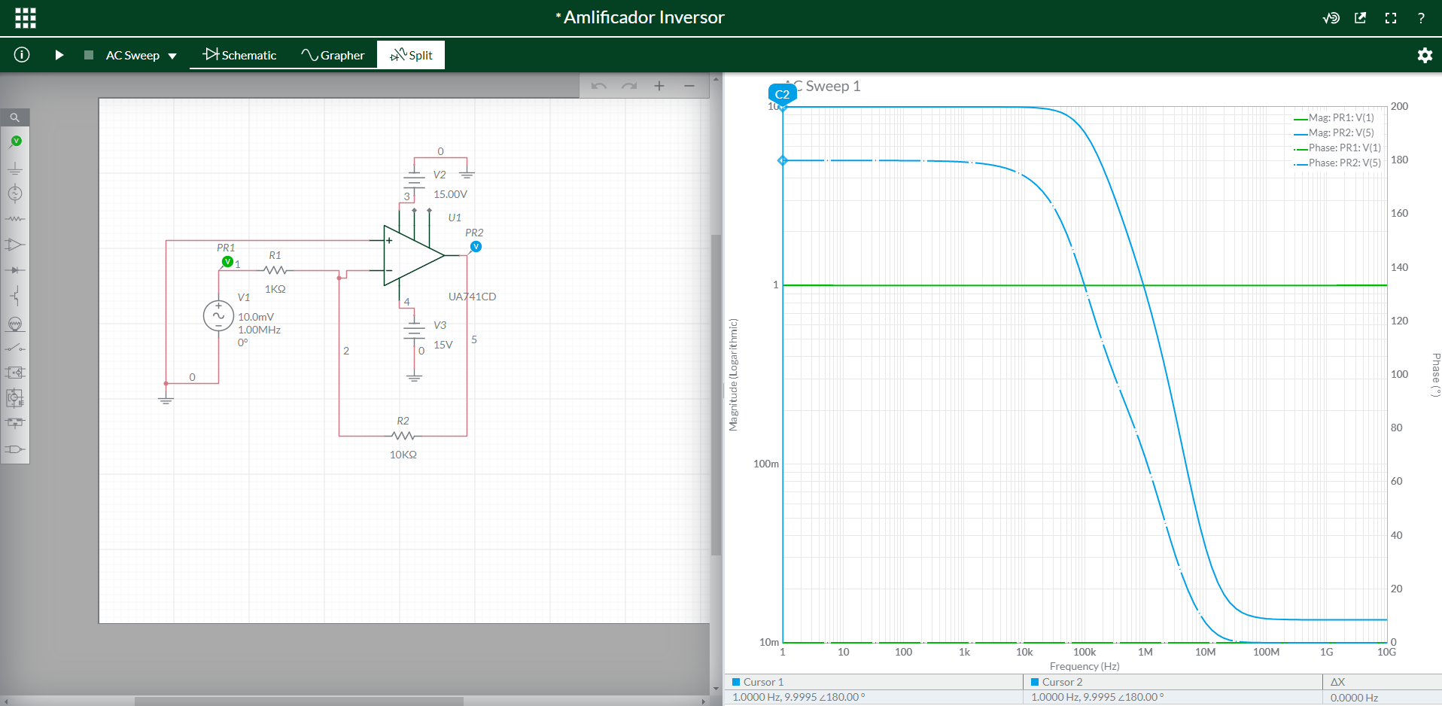
figures/Multisim_ACsweep.png
