eddygrinder/LaRE_LaTeX/figures/Multisim_AmpInv.png

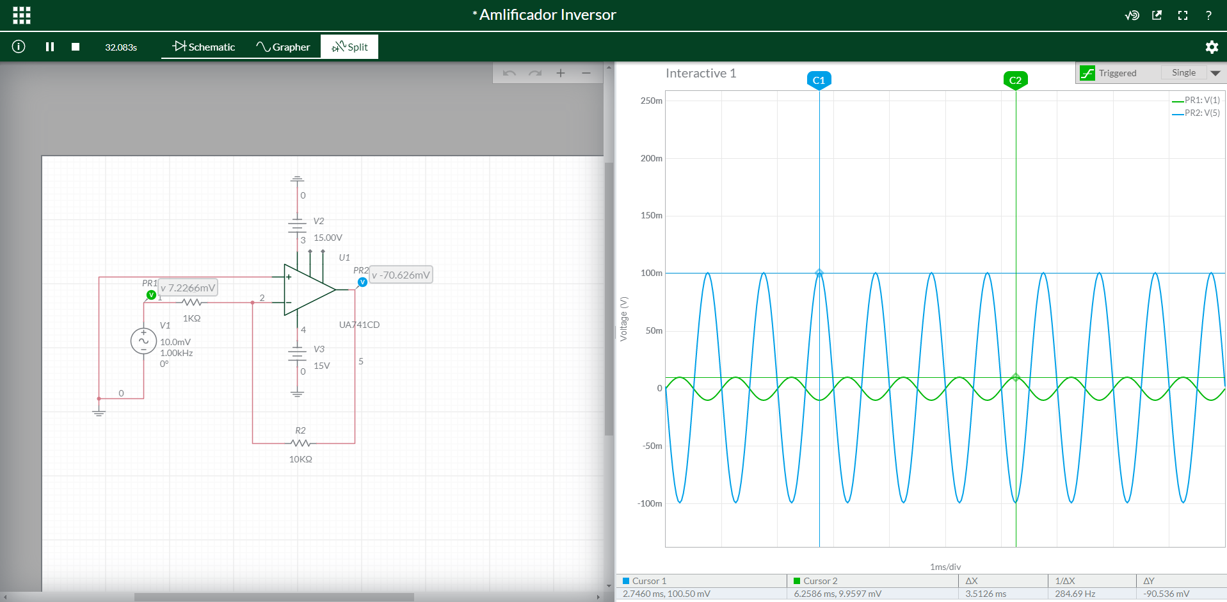
figures/Multisim_AmpInv.png
