eddygrinder/LaRE_LaTeX/figures/Multisim_Desktop.png

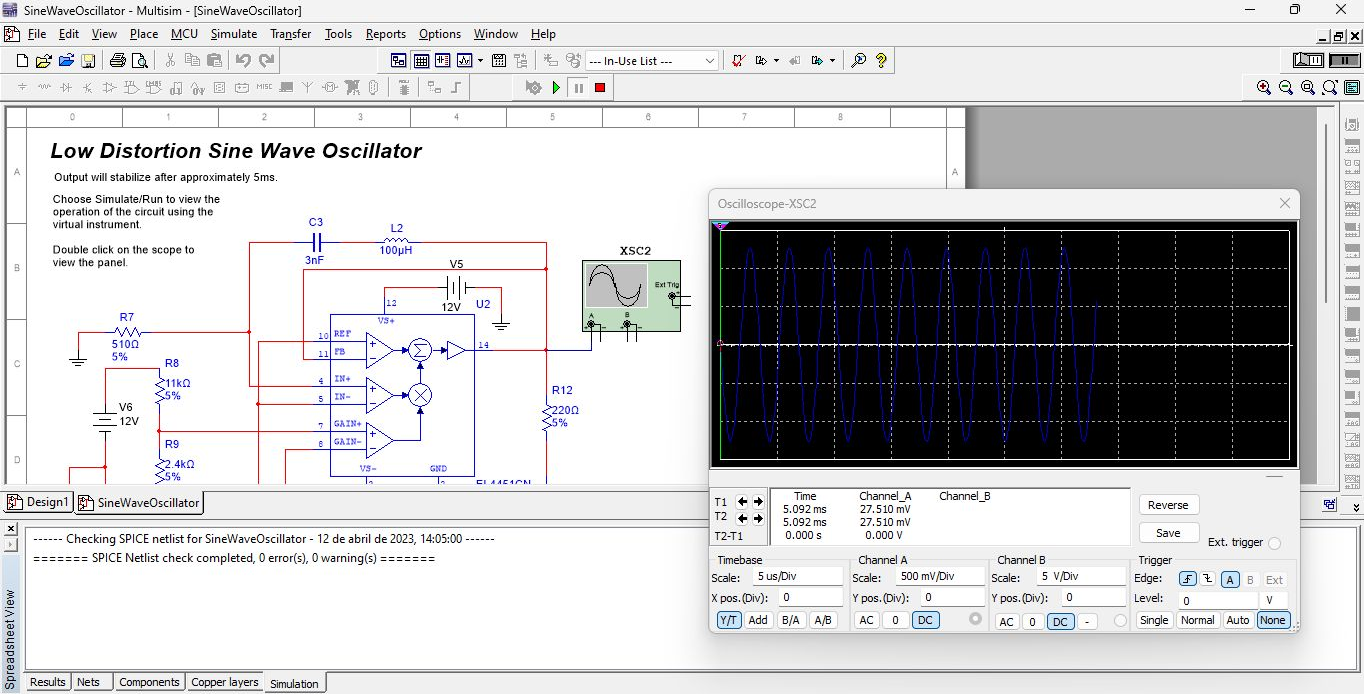
figures/Multisim_Desktop.png
