eddygrinder/LaRE_LaTeX/figures/Multisim_RC.png

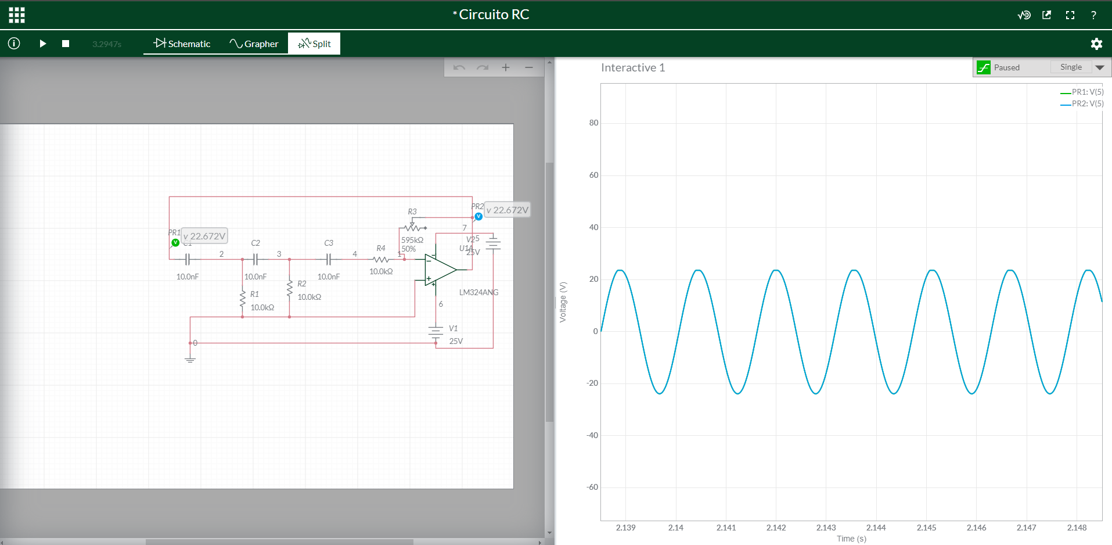
figures/Multisim_RC.png
