eddygrinder/LaRE_LaTeX/figures/nx-4i.jpg

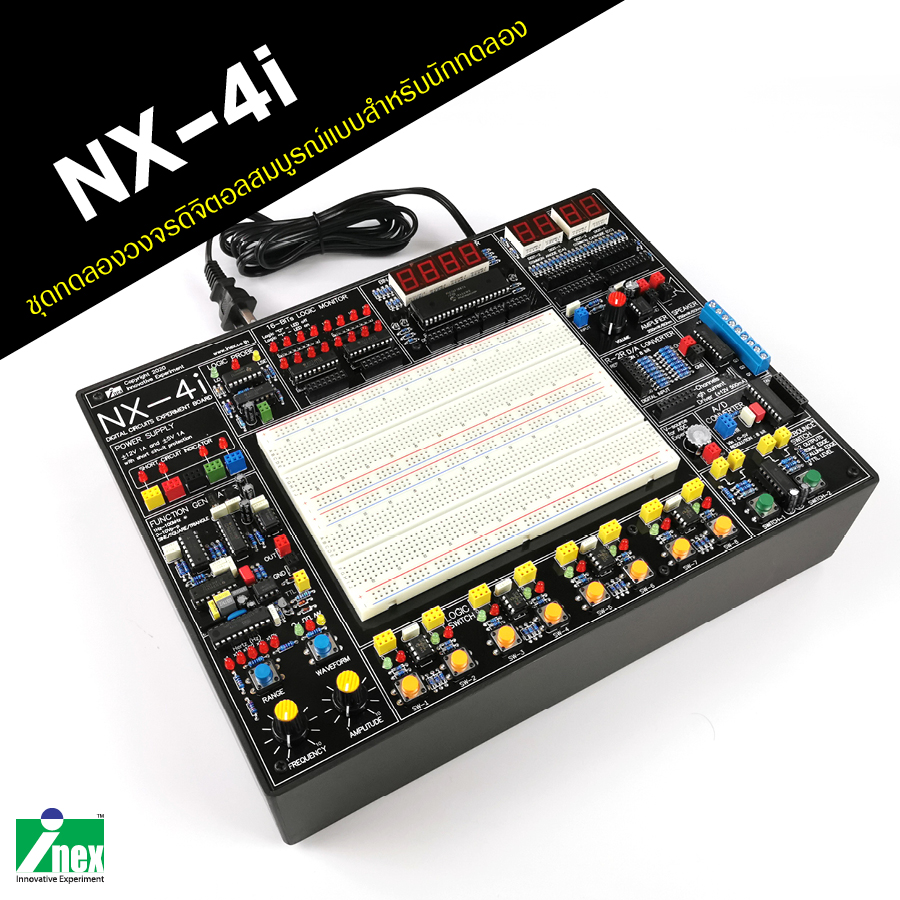
figures/nx-4i.jpg
