eddygrinder/LaRE_LaTeX/figures/OC_RIPPLE_VB_1N4007.png

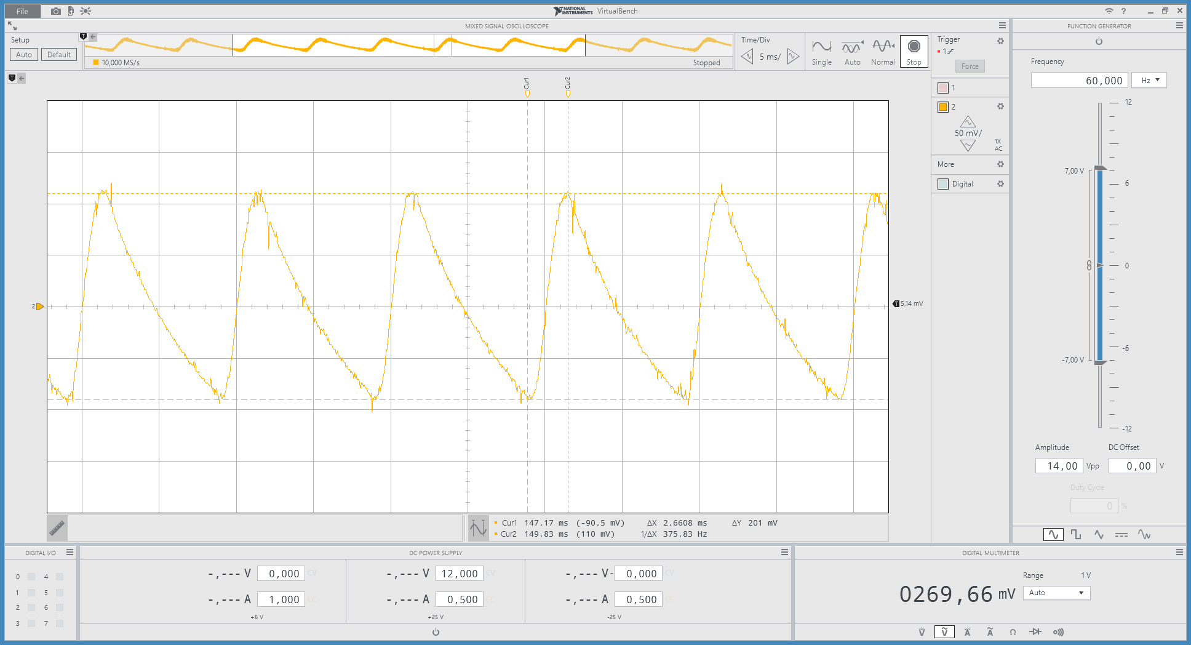
figures/OC_RIPPLE_VB_1N4007.png
