eddygrinder/LaRE_LaTeX/figures/OC_Vin_VB.png

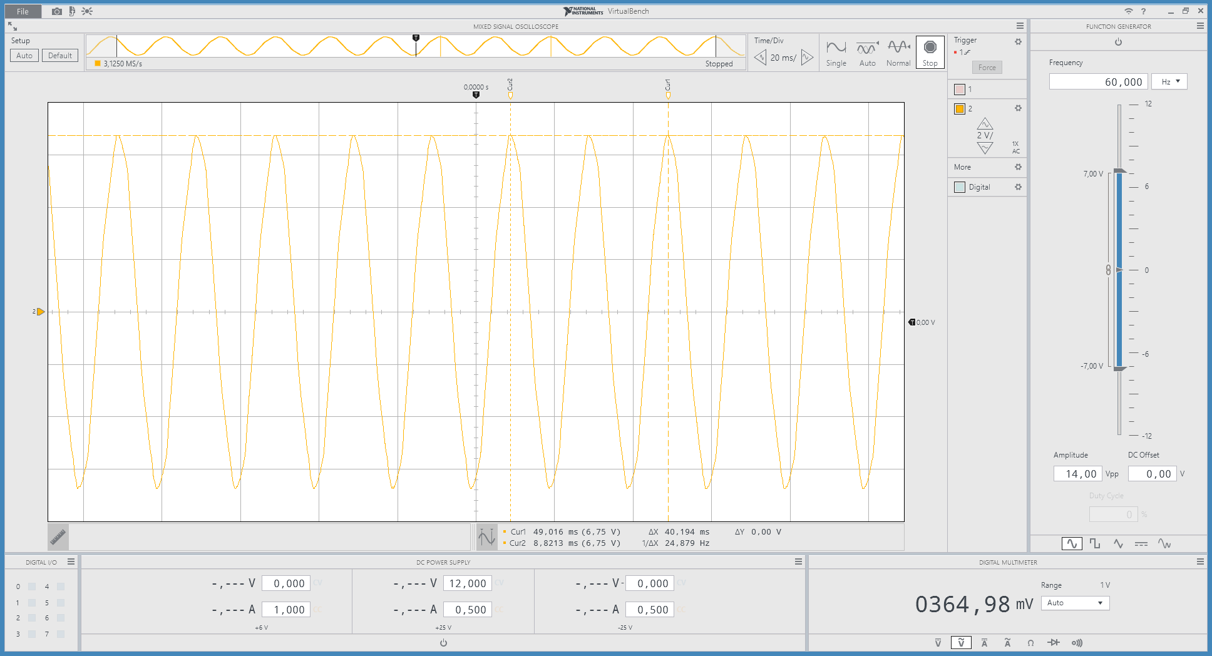
figures/OC_Vin_VB.png
