eddygrinder/LaRE_LaTeX/figures/OC_VR_VB_1N4007.png

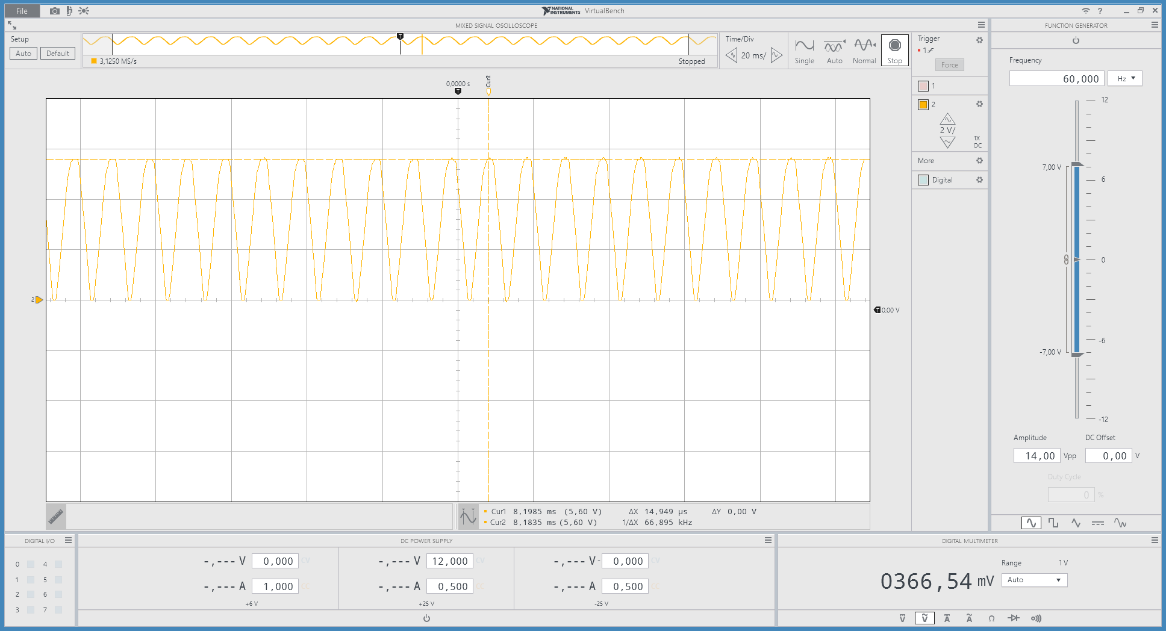
figures/OC_VR_VB_1N4007.png
