eddygrinder/LaRE_LaTeX/figures/OC_VR_VB_Ponte.png

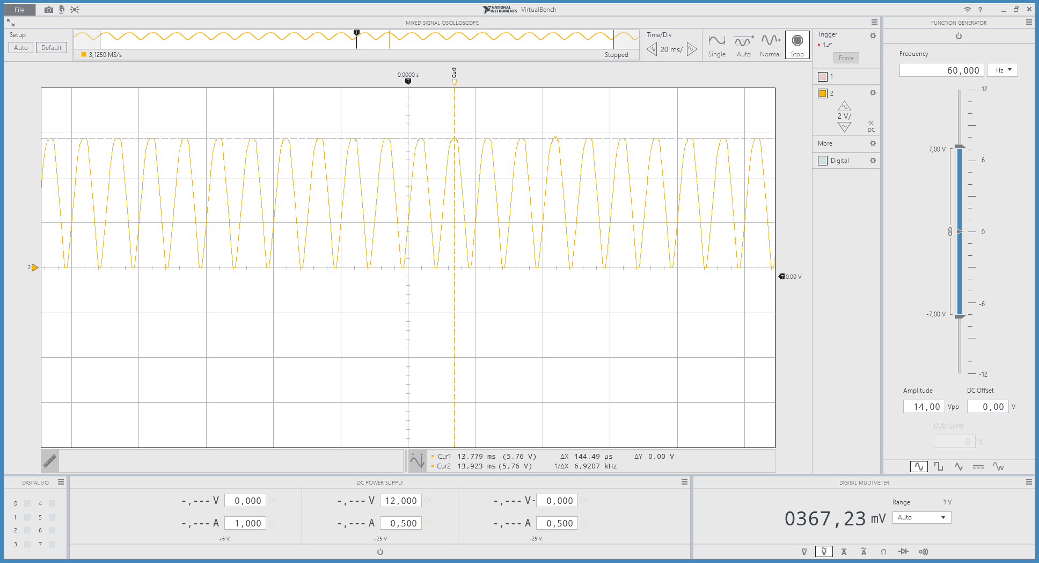
figures/OC_VR_VB_Ponte.png
