eddygrinder/LaRE_LaTeX/figures/ohm_diagrama.drawio-Recuperado.png

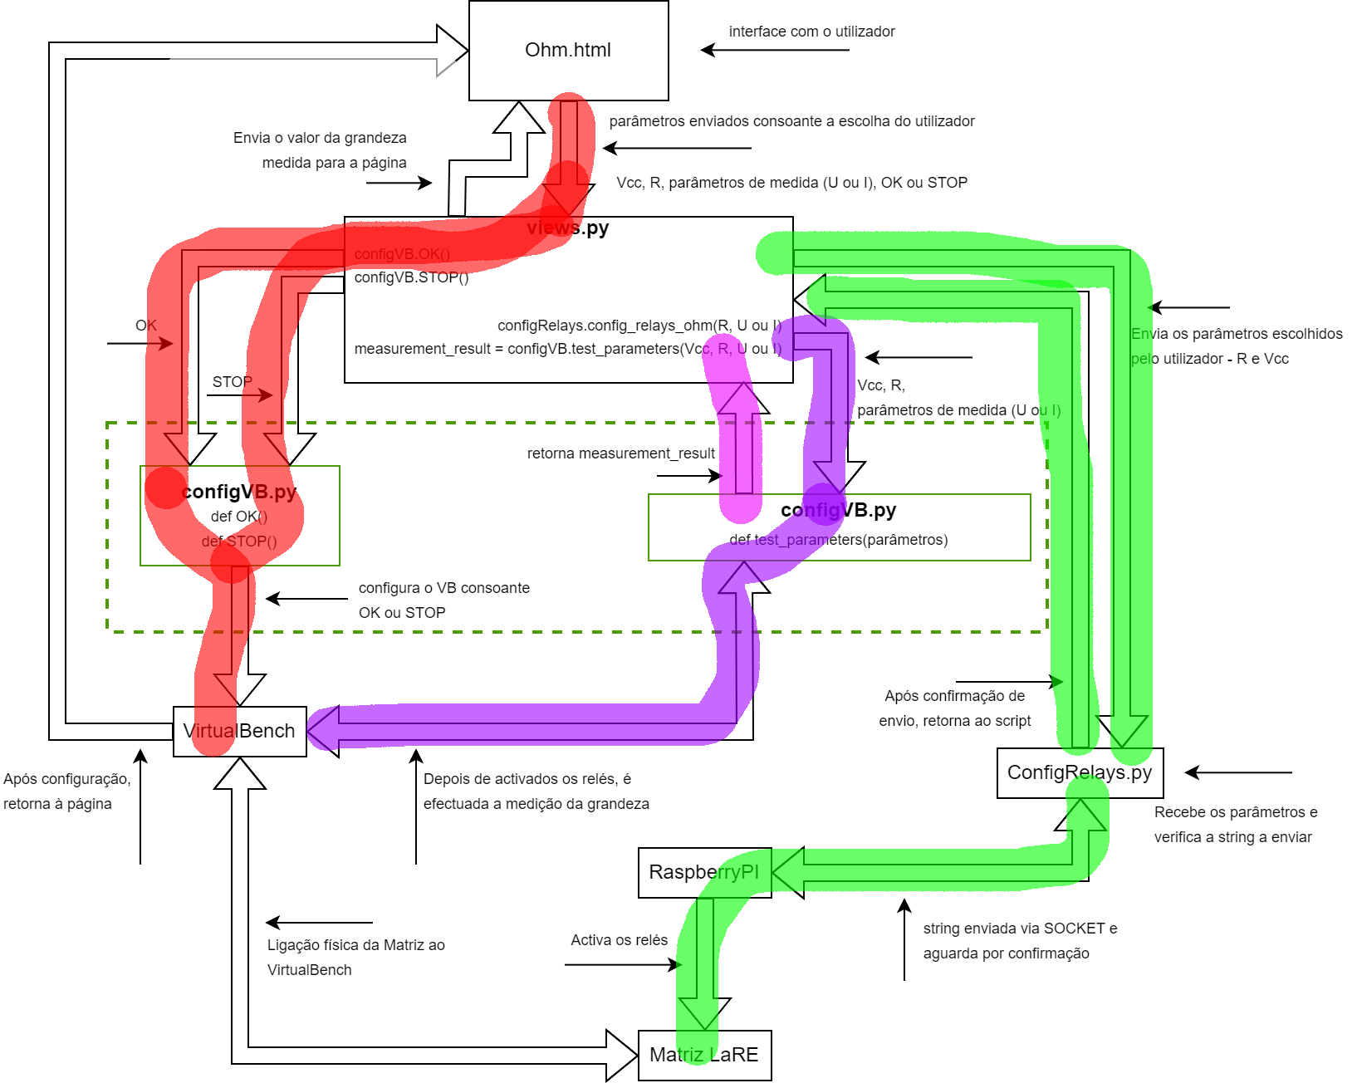
figures/ohm_diagrama.drawio-Recuperado.png
