eddygrinder/LaRE_LaTeX/figures/ohm_diagrama.drawio.png

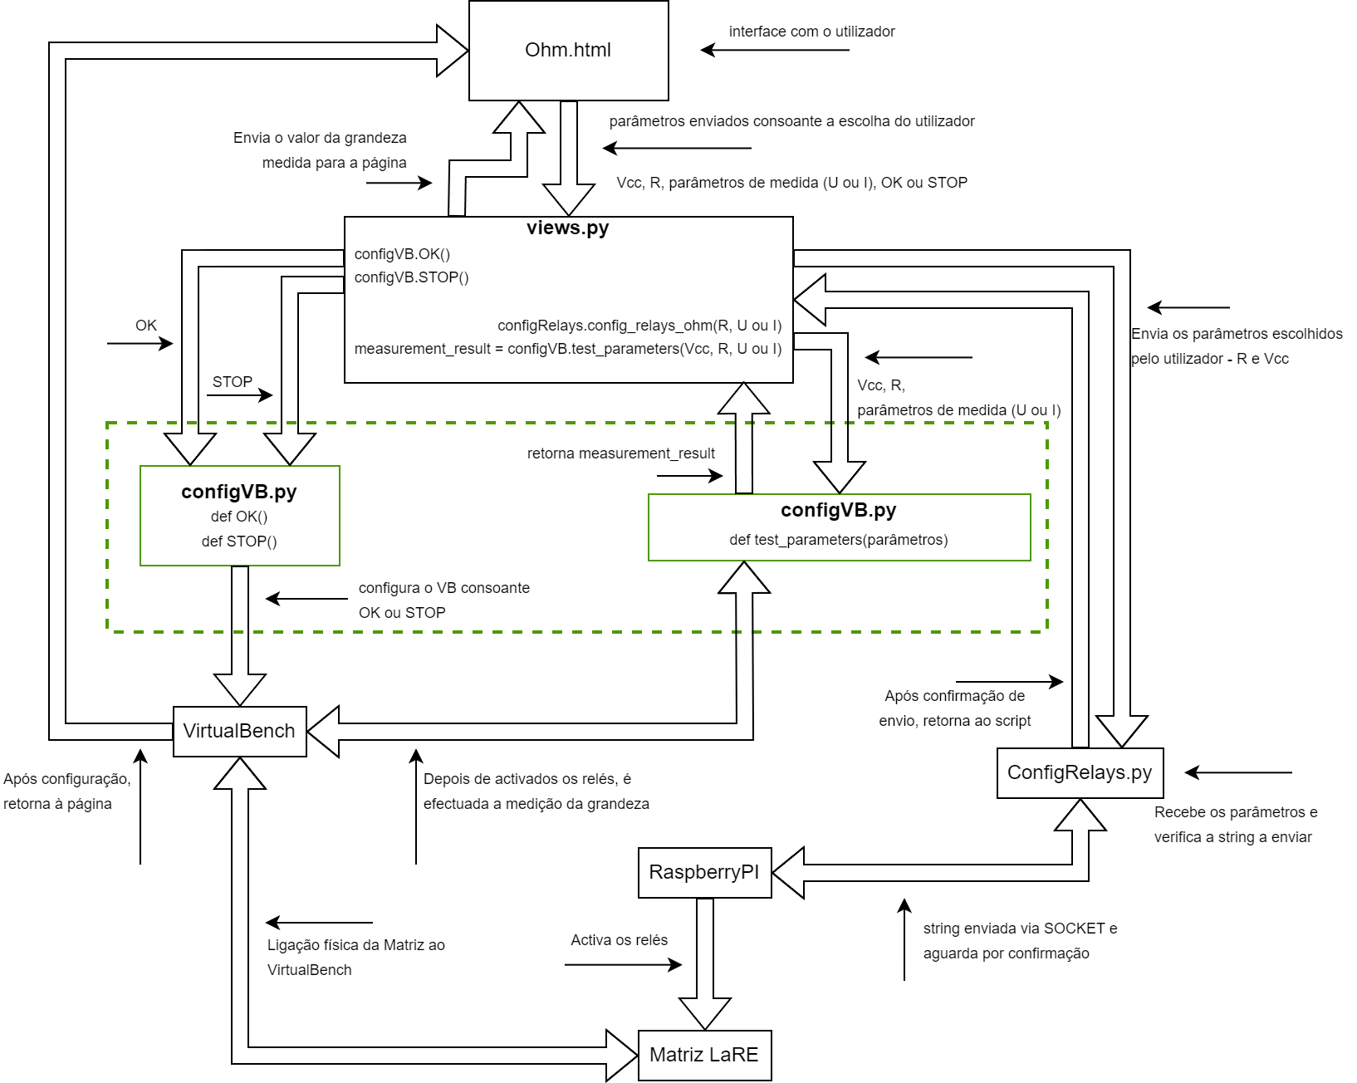
figures/ohm_diagrama.drawio.png
