eddygrinder/LaRE_LaTeX/figures/ohm_diagrama.drawio_VER1.png

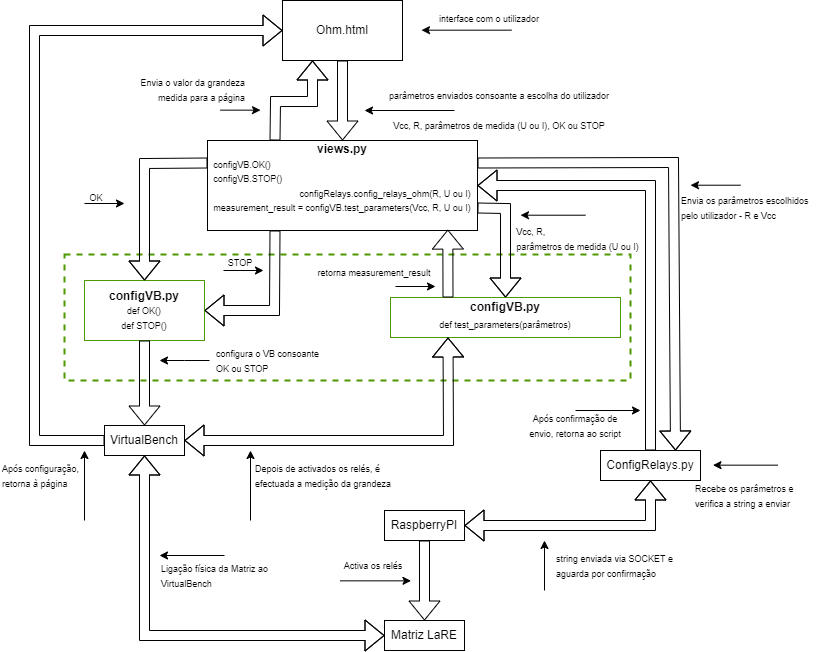
figures/ohm_diagrama.drawio_VER1.png
