eddygrinder/LaRE_LaTeX/figures/ohm_diagrama_pormenor.drawio.png

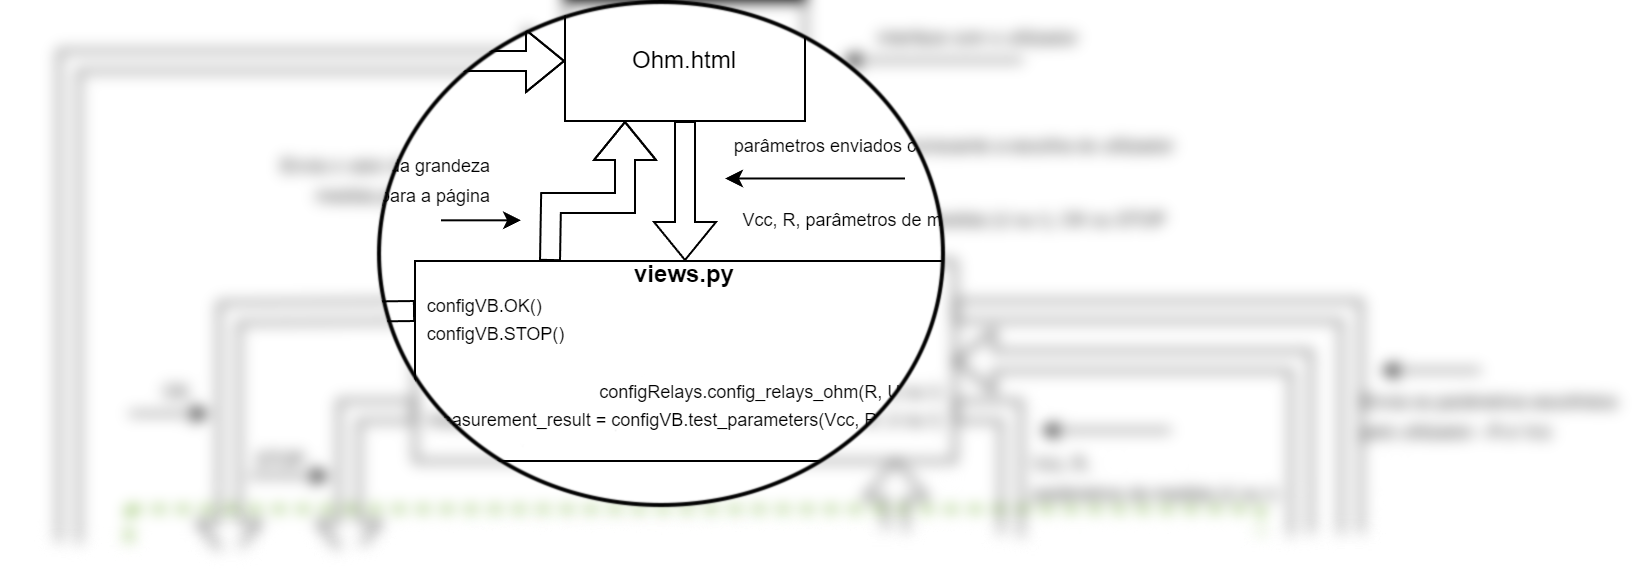
figures/ohm_diagrama_pormenor.drawio.png
