eddygrinder/LaRE_LaTeX/figures/ohm_diagramaCUT.drawio.png

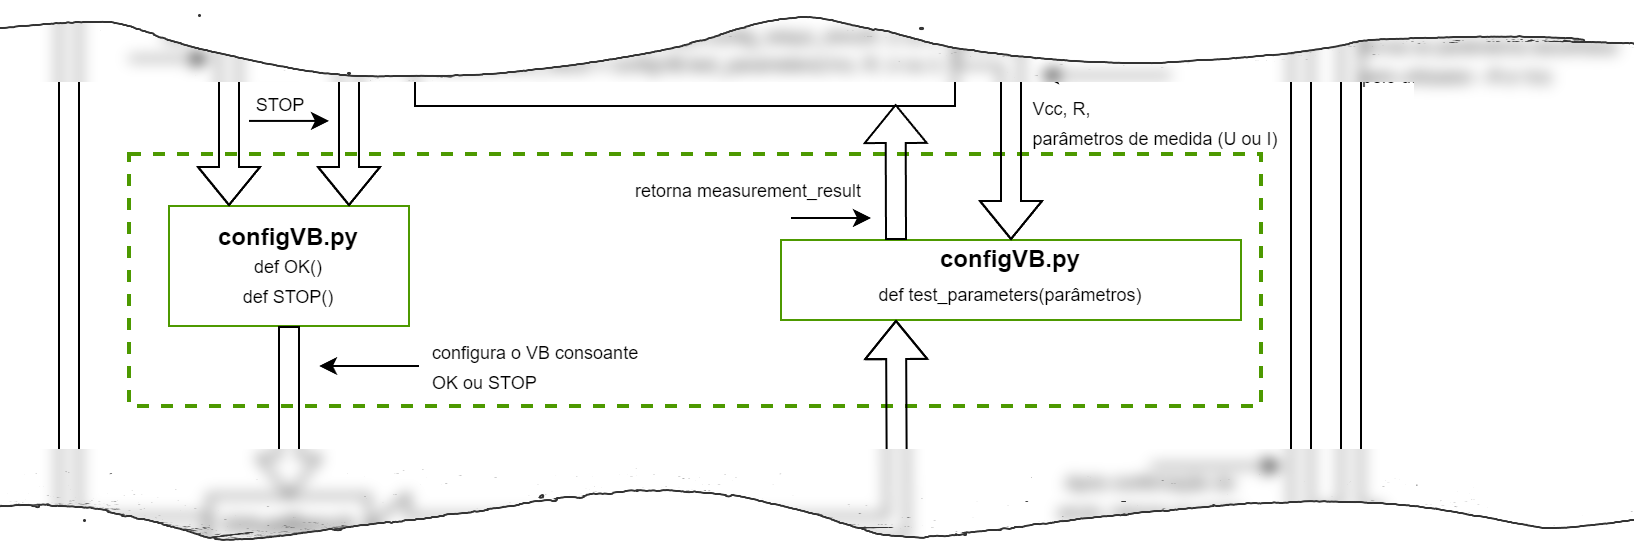
figures/ohm_diagramaCUT.drawio.png
