eddygrinder/LaRE_LaTeX/figures/ohm_diagramaCUTRelay.drawio.png

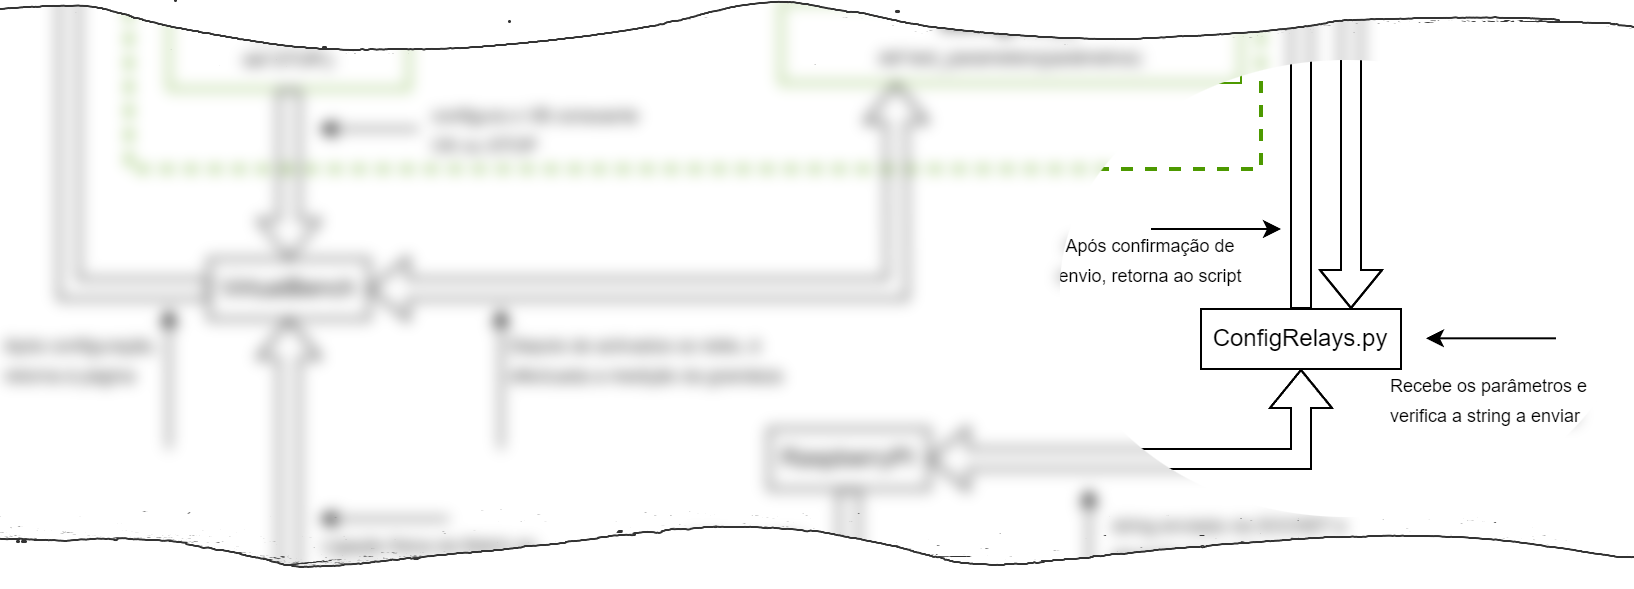
figures/ohm_diagramaCUTRelay.drawio.png
