eddygrinder/LaRE_LaTeX/figures/ohm_escolha.png

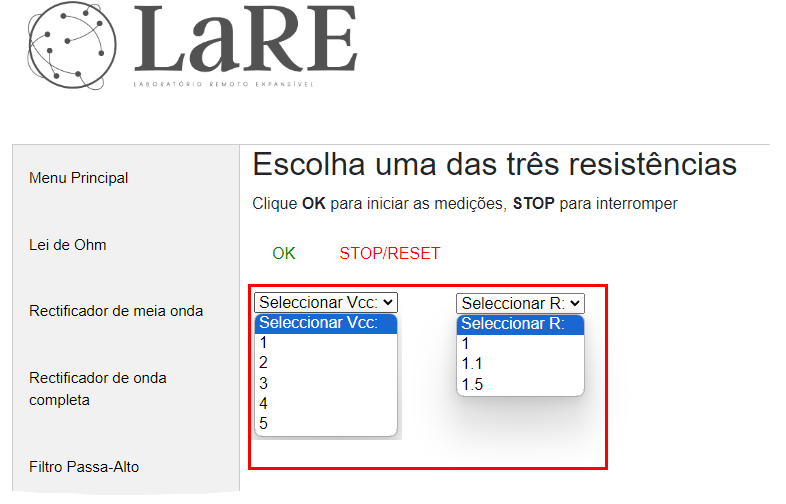
figures/ohm_escolha.png
