eddygrinder/LaRE_LaTeX/figures/ohm_escolha_abc.png

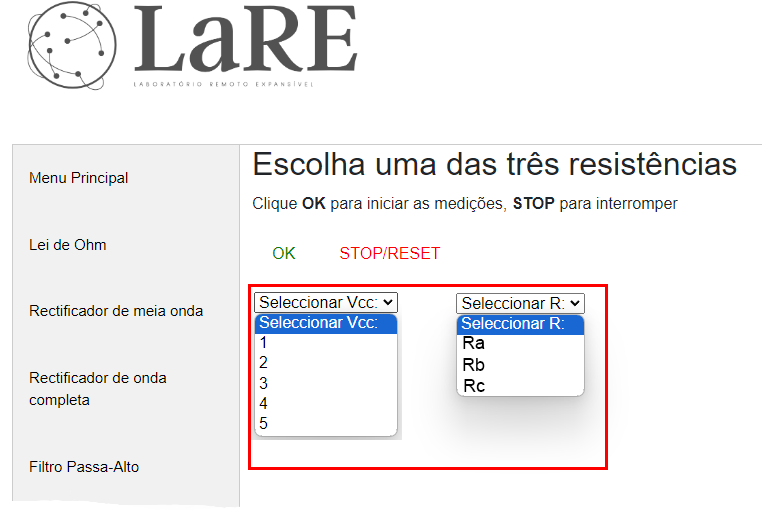
figures/ohm_escolha_abc.png
