eddygrinder/LaRE_LaTeX/figures/ohm_graph.png

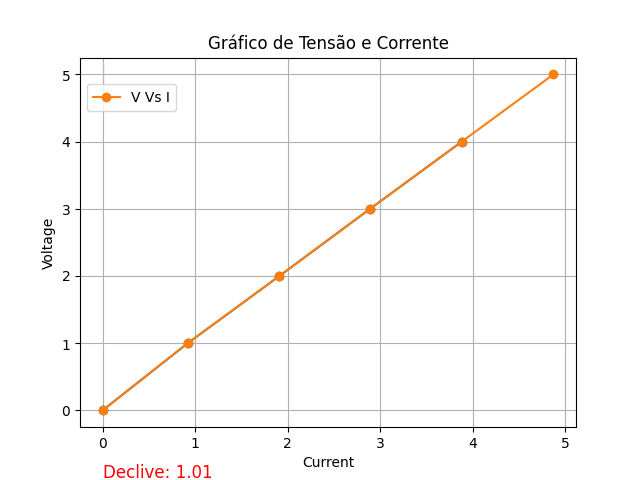
figures/ohm_graph.png
