eddygrinder/LaRE_LaTeX/figures/ohm_page.png

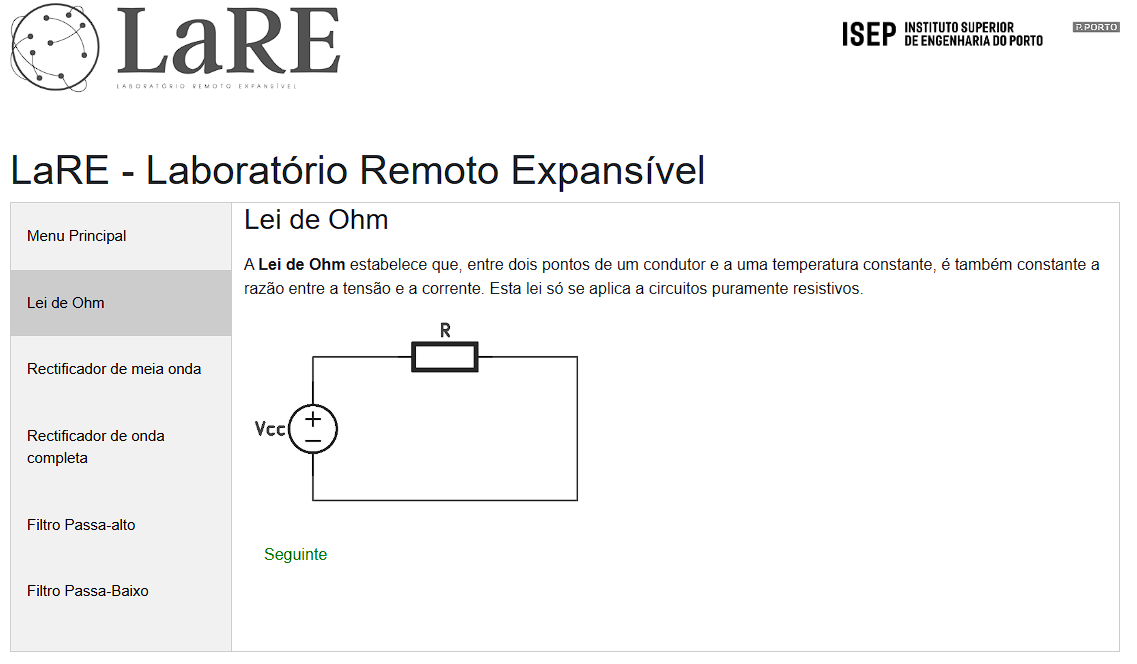
figures/ohm_page.png
