eddygrinder/LaRE_LaTeX/figures/ohm_page_controlo-FULL.png

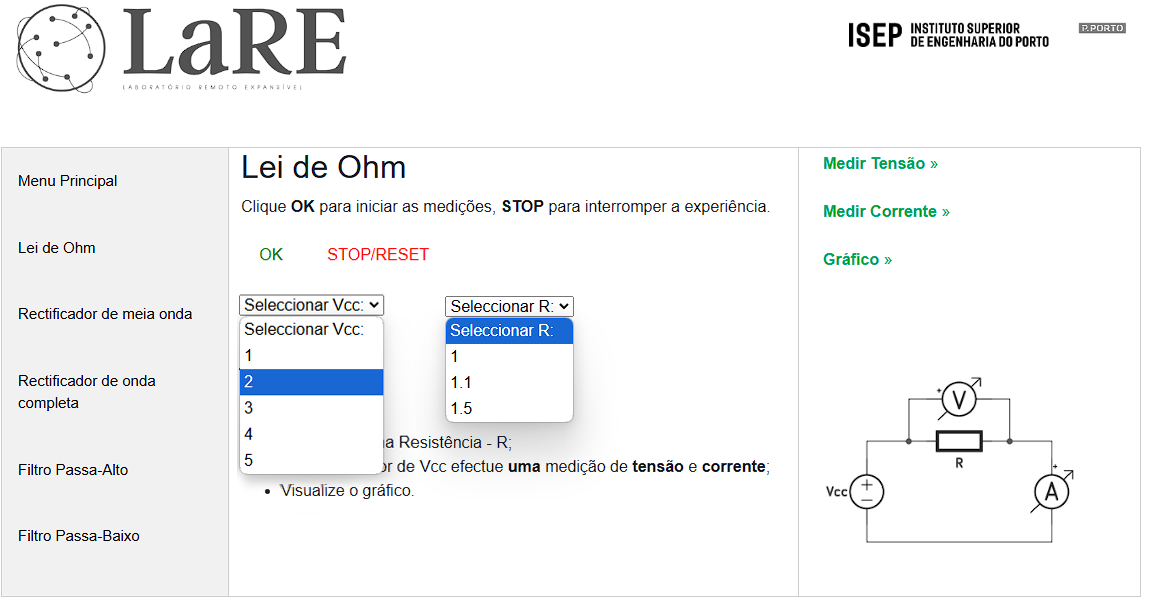
figures/ohm_page_controlo-FULL.png
