eddygrinder/LaRE_LaTeX/figures/ohm_page_controlo.png

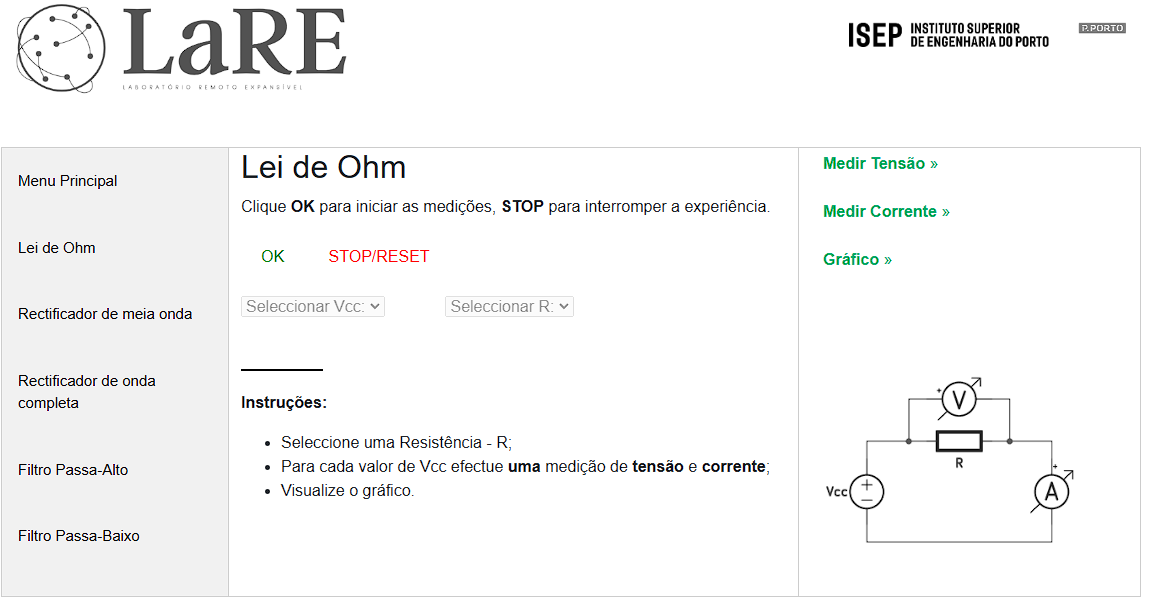
figures/ohm_page_controlo.png
