eddygrinder/LaRE_LaTeX/figures/onda_completa_Sedra.png

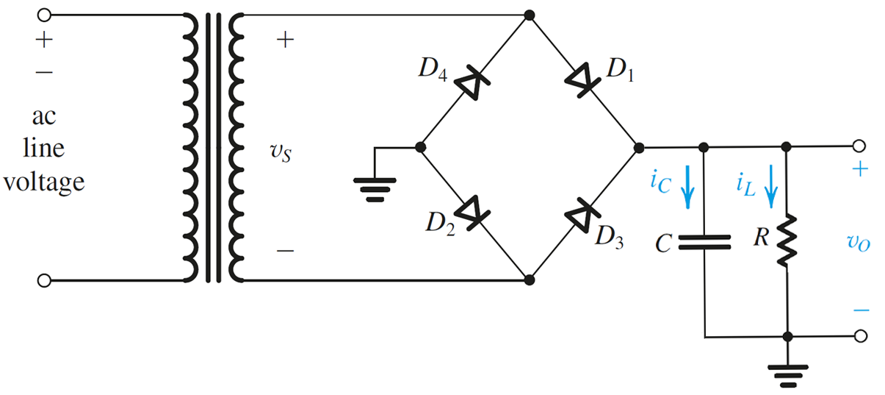
figures/onda_completa_Sedra.png
