eddygrinder/LaRE_LaTeX/figures/onda_OndaCompleta_diagrama.png

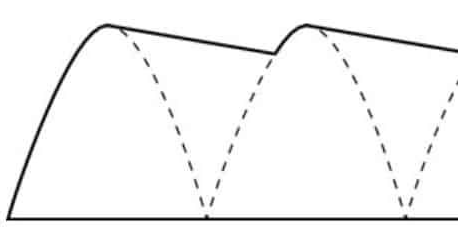
figures/onda_OndaCompleta_diagrama.png
