eddygrinder/LaRE_LaTeX/figures/ondacompleta.png

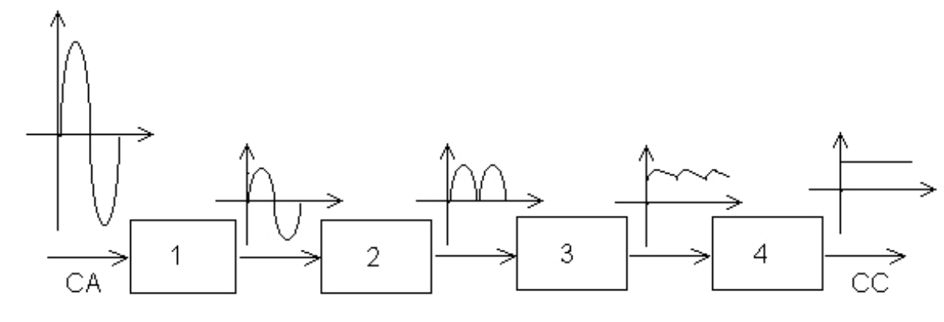
figures/ondacompleta.png
