eddygrinder/LaRE_LaTeX/figures/ondacompleta_control.png

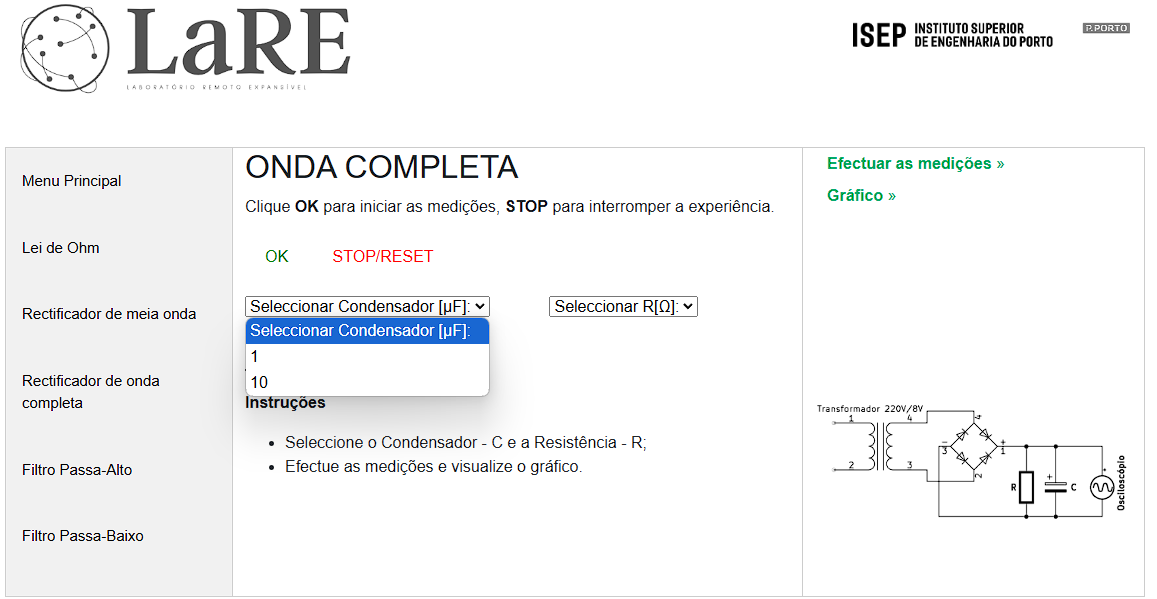
figures/ondacompleta_control.png
