eddygrinder/LaRE_LaTeX/figures/PA_10nF2k2-80Khz.png

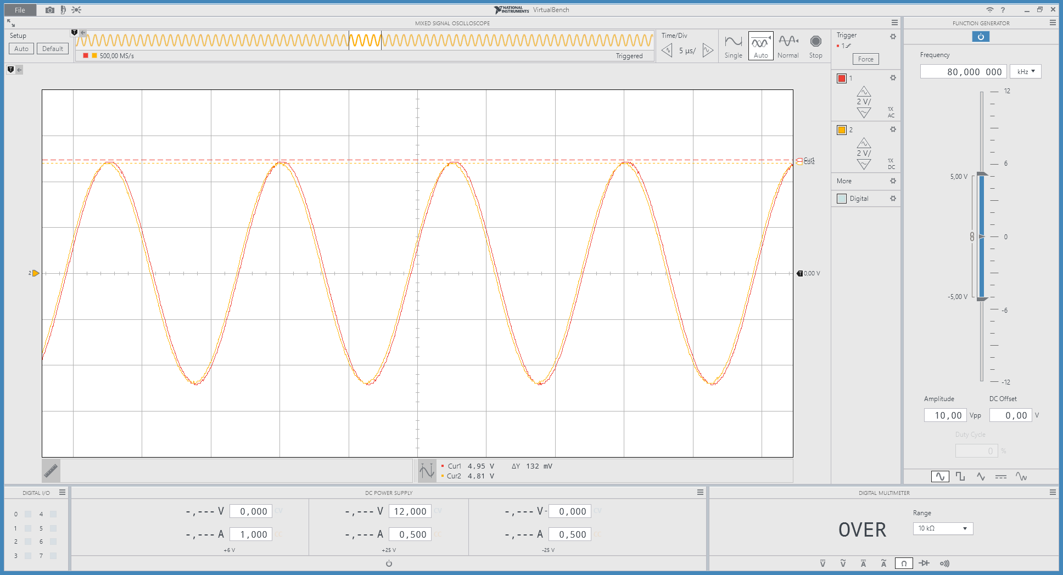
figures/PA_10nF2k2-80Khz.png
