eddygrinder/LaRE_LaTeX/figures/PA_10nF2k2-Fc.png

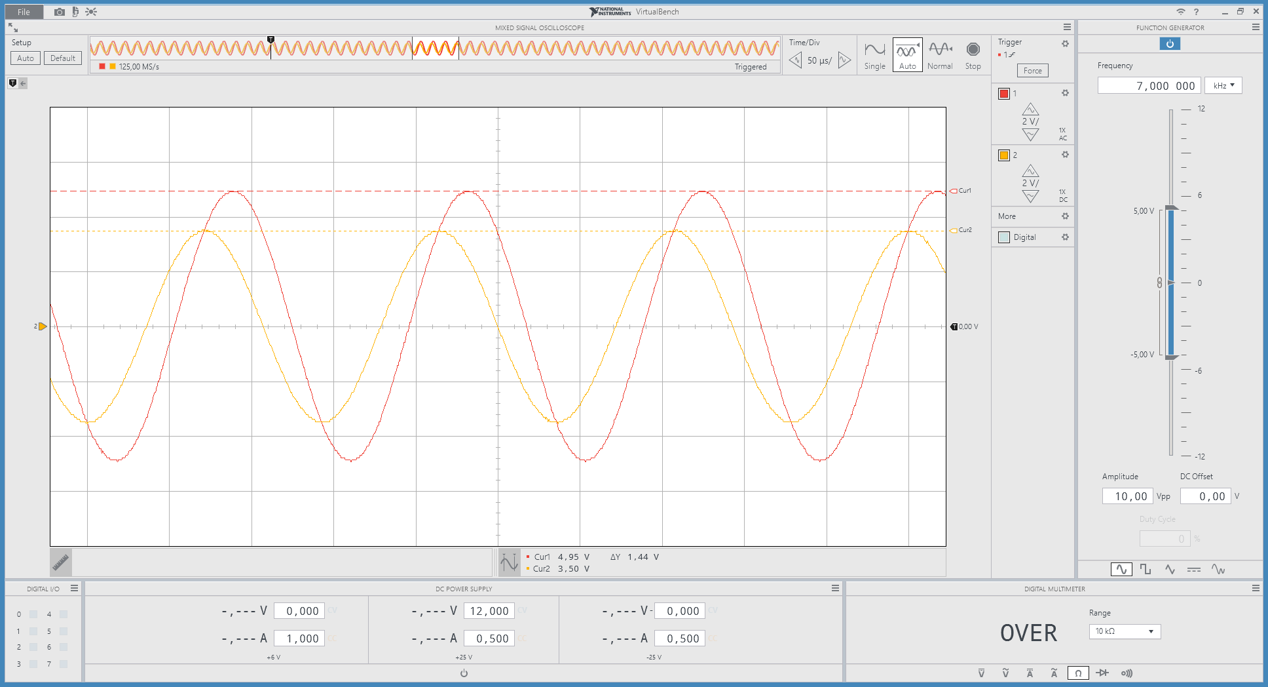
figures/PA_10nF2k2-Fc.png
