eddygrinder/LaRE_LaTeX/figures/page_login.png

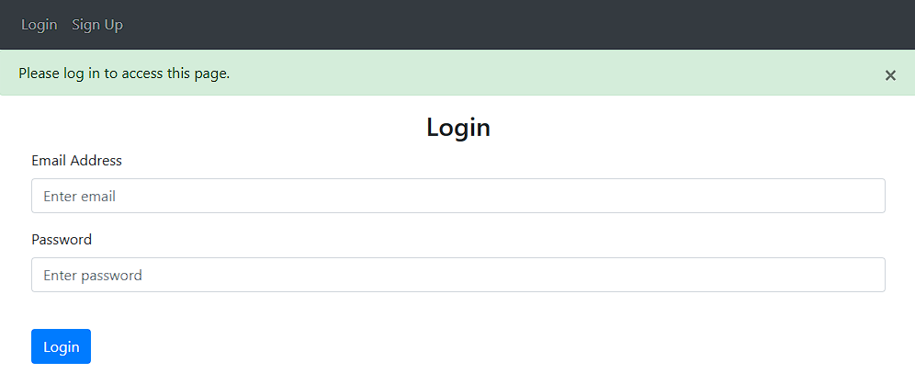
figures/page_login.png
