eddygrinder/LaRE_LaTeX/figures/page_menu_principal.png

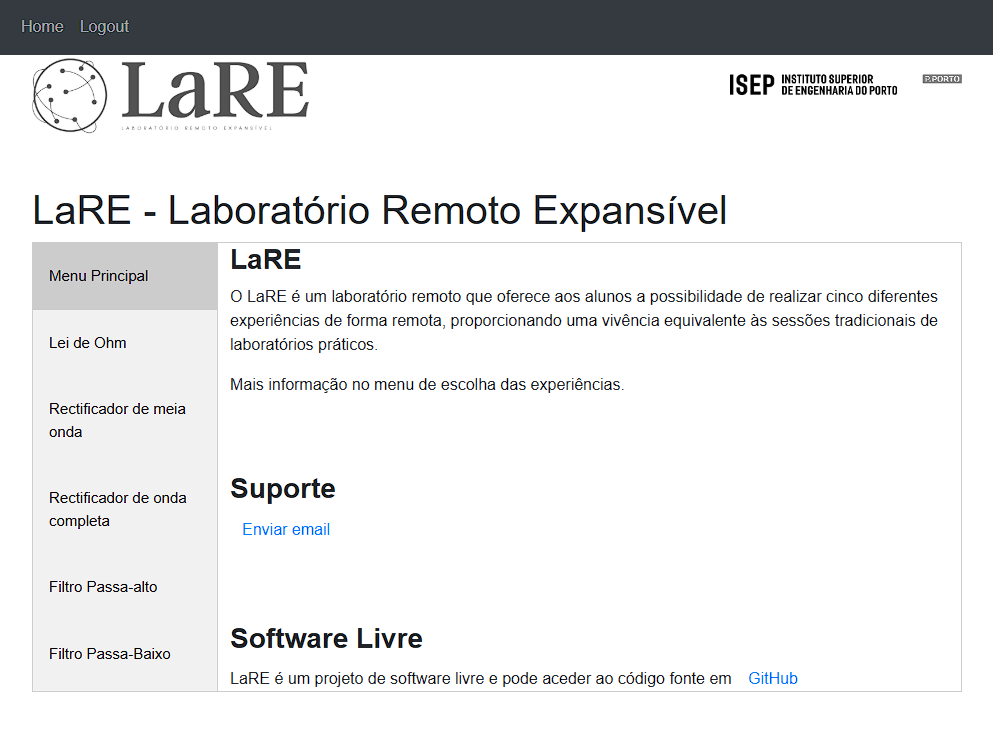
figures/page_menu_principal.png
