eddygrinder/LaRE_LaTeX/figures/parametros_desabilitados.png

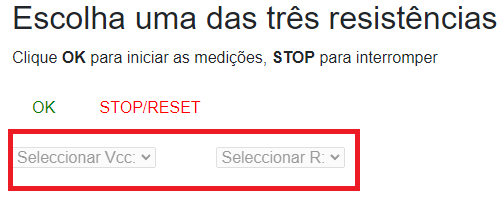
figures/parametros_desabilitados.png
