eddygrinder/LaRE_LaTeX/figures/passaalto_page_controlo.png

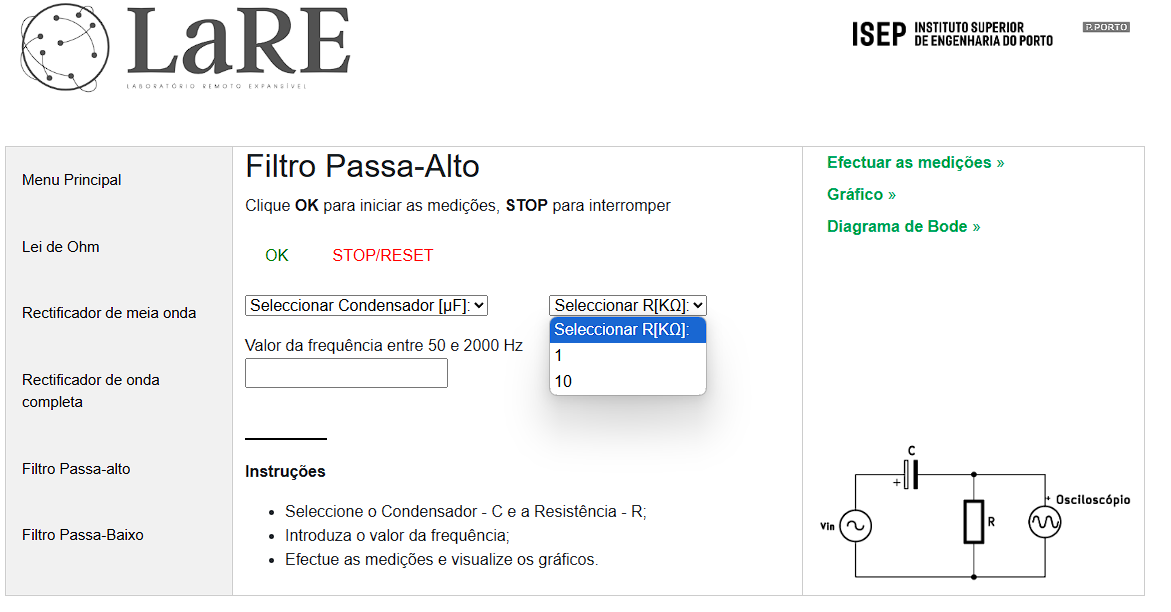
figures/passaalto_page_controlo.png
