eddygrinder/LaRE_LaTeX/figures/passabaixo_page_controlo.png

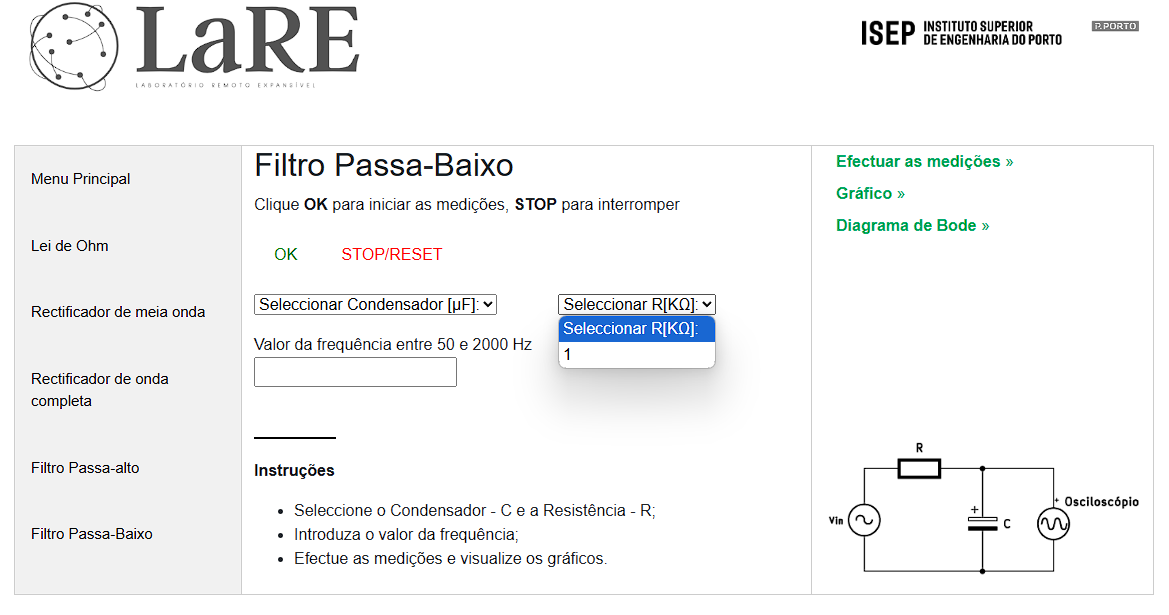
figures/passabaixo_page_controlo.png
