eddygrinder/LaRE_LaTeX/figures/pi5_dissipador.png

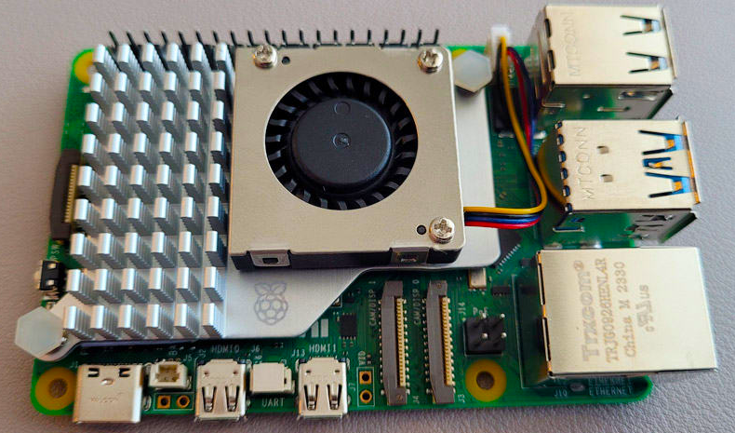
figures/pi5_dissipador.png
