eddygrinder/LaRE_LaTeX/figures/pinout.png

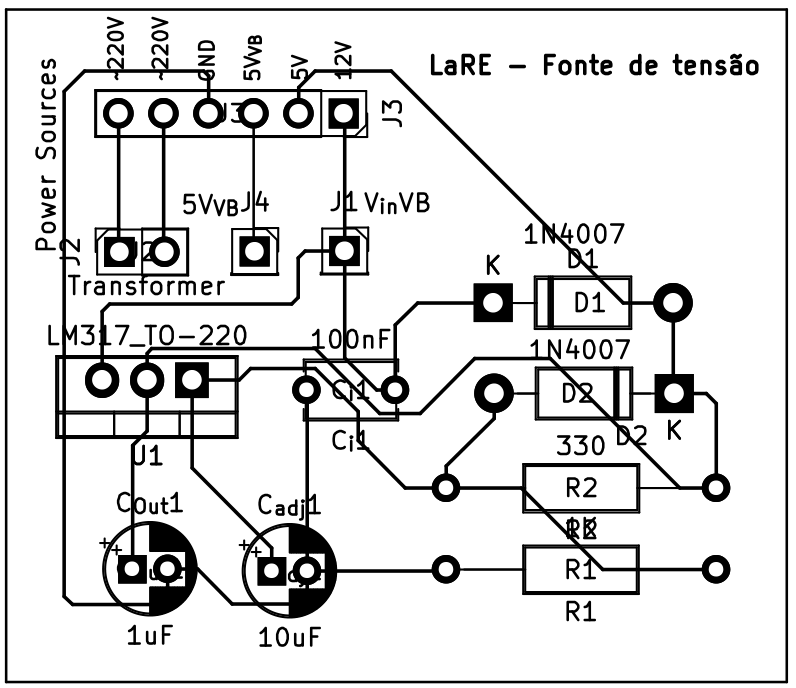
figures/pinout.png
