eddygrinder/LaRE_LaTeX/figures/promenorDMM.png

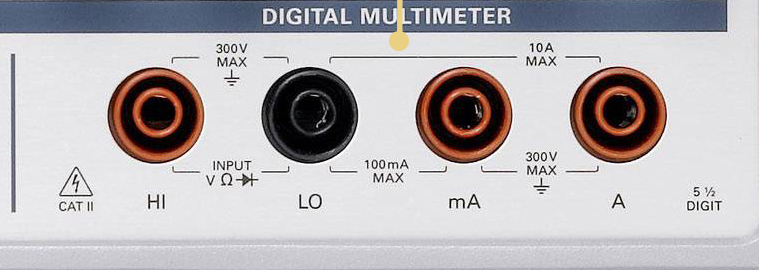
figures/promenorDMM.png
