eddygrinder/LaRE_LaTeX/figures/promenorvisirISEP.png

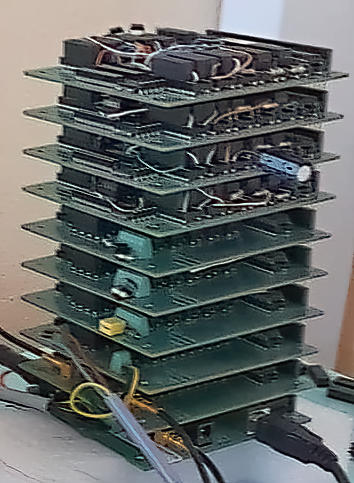
figures/promenorvisirISEP.png
