eddygrinder/LaRE_LaTeX/figures/protboard_visir.png

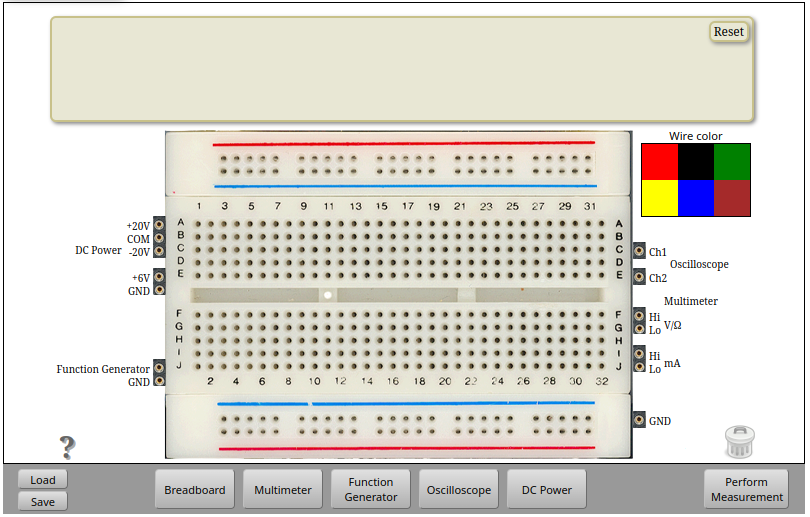
figures/protboard_visir.png
