eddygrinder/LaRE_LaTeX/figures/pspice.jpg

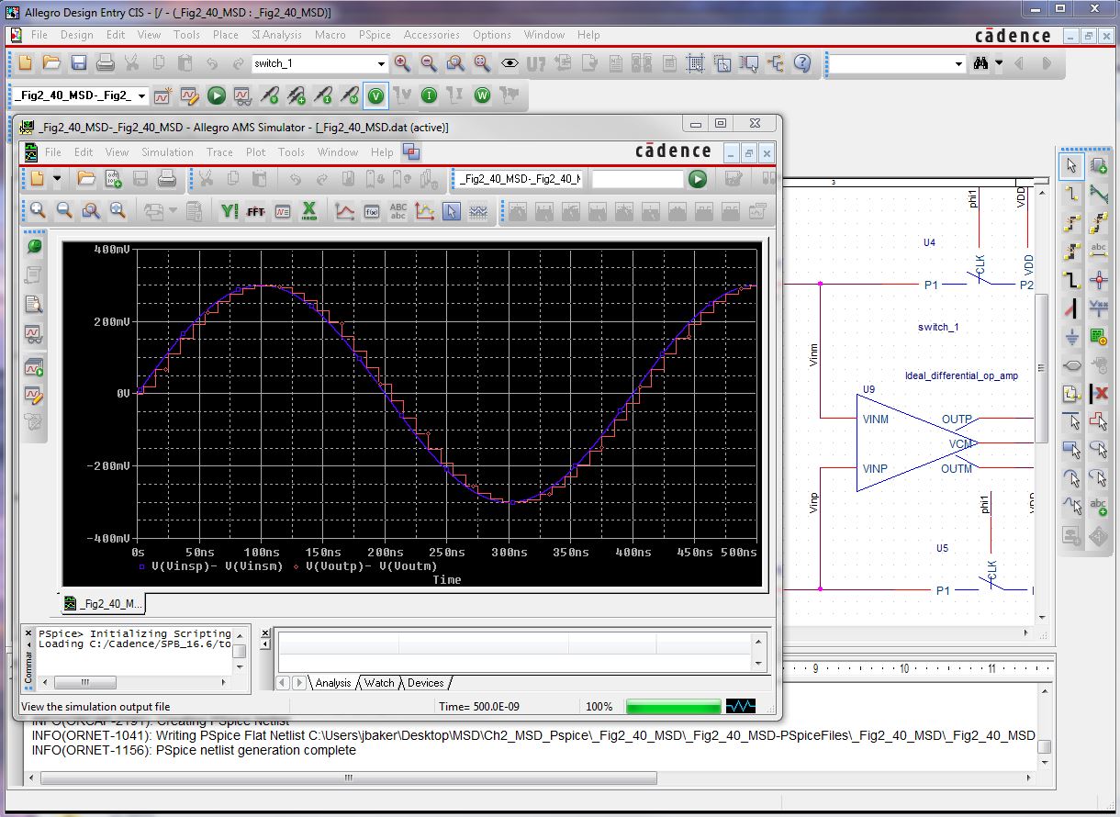
figures/pspice.jpg
