eddygrinder/LaRE_LaTeX/figures/PXI-1033.png

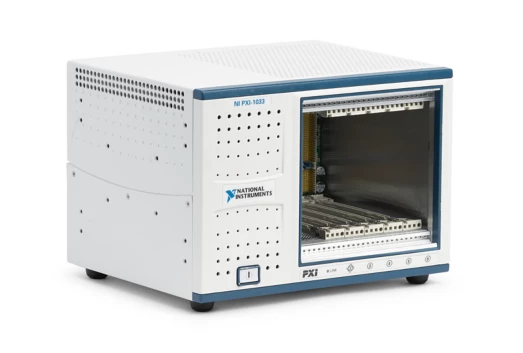
figures/PXI-1033.png
