eddygrinder/LaRE_LaTeX/figures/PXI-4072.png

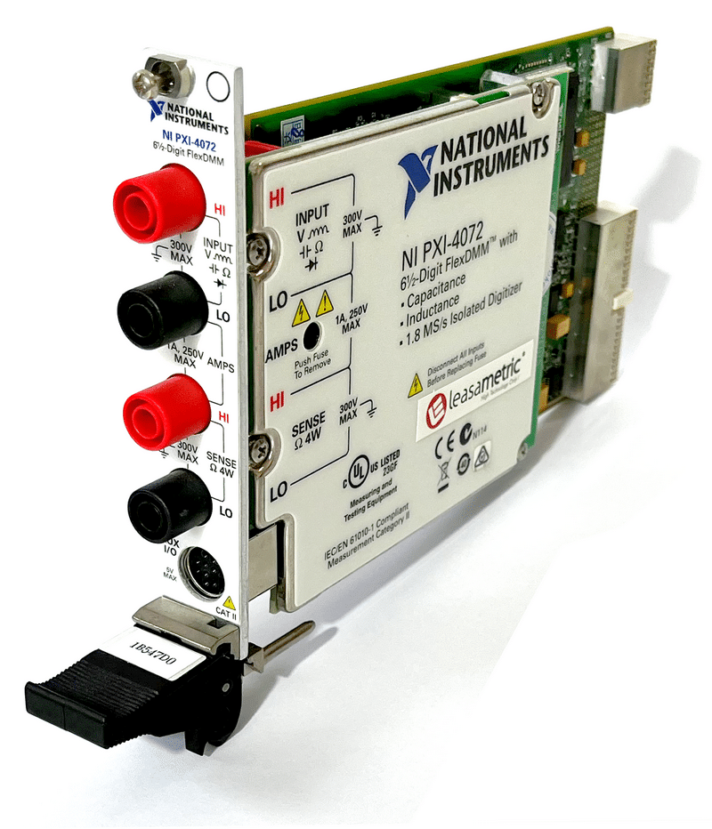
figures/PXI-4072.png
