eddygrinder/LaRE_LaTeX/figures/PXI-4110.png

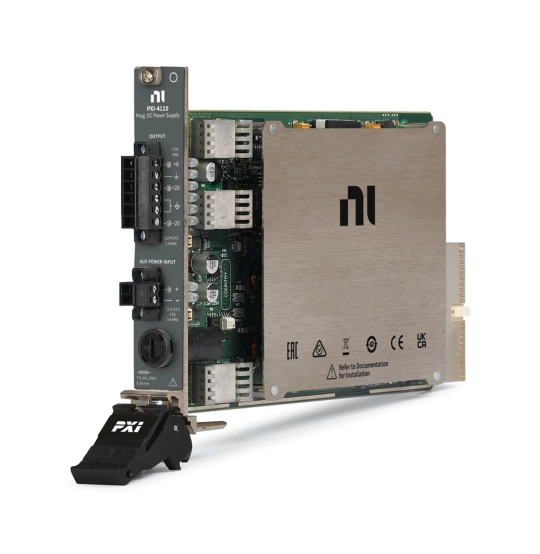
figures/PXI-4110.png
