eddygrinder/LaRE_LaTeX/figures/PXI-5114.png

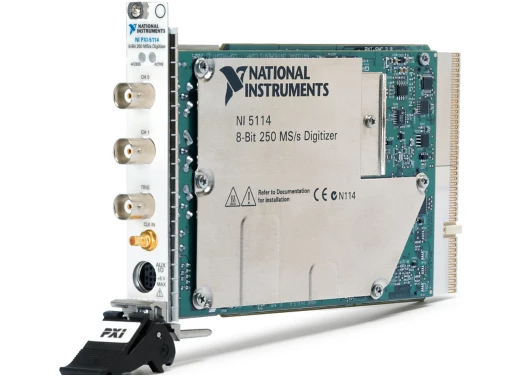
figures/PXI-5114.png
