eddygrinder/LaRE_LaTeX/figures/PXI-5402.png

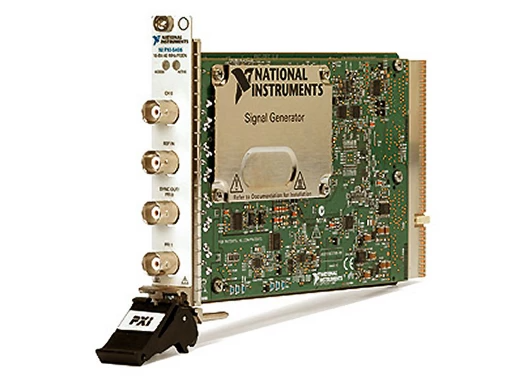
figures/PXI-5402.png
