eddygrinder/LaRE_LaTeX/figures/rec_fil_FULL.png

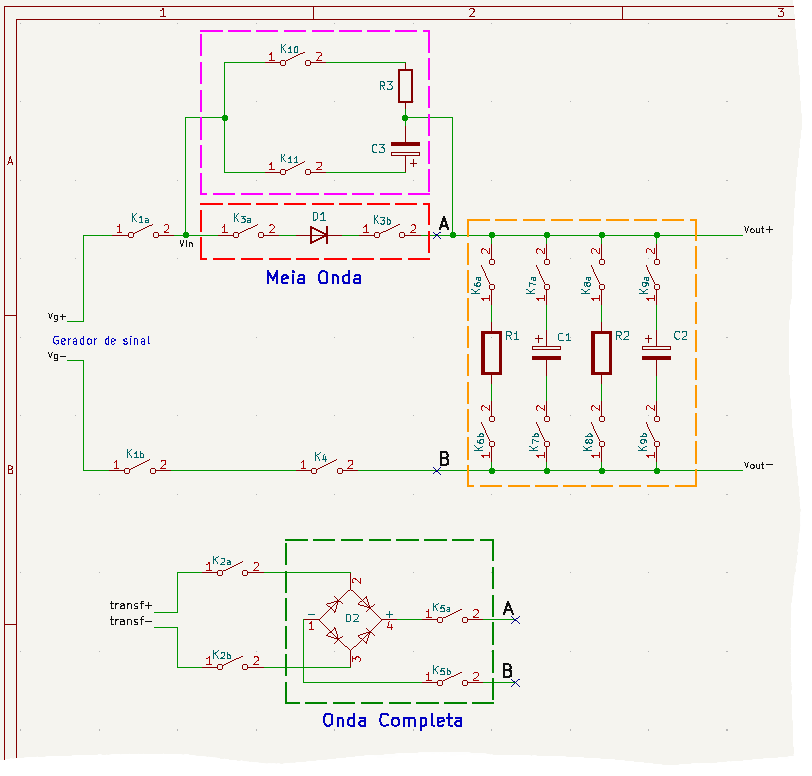
figures/rec_fil_FULL.png
