eddygrinder/LaRE_LaTeX/figures/rectificador_filtro_simplificado.png

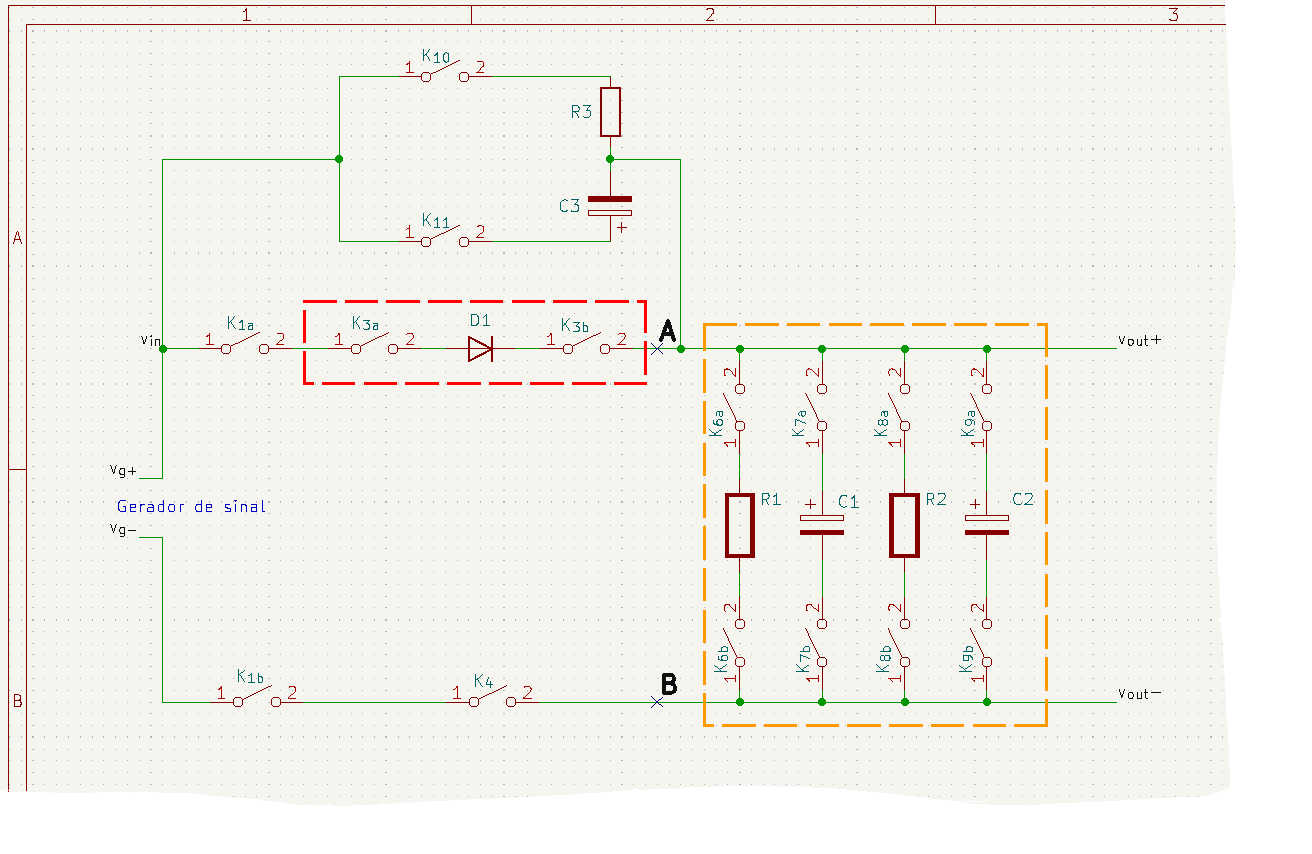
figures/rectificador_filtro_simplificado.png
