eddygrinder/LaRE_LaTeX/figures/registo deslocamente.drawio.png

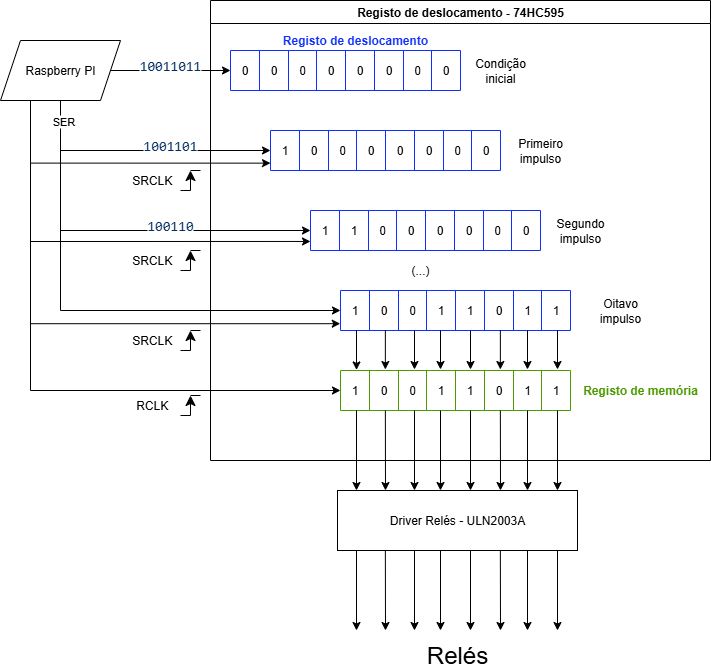
figures/registo deslocamente.drawio.png
