eddygrinder/LaRE_LaTeX/figures/registo.png

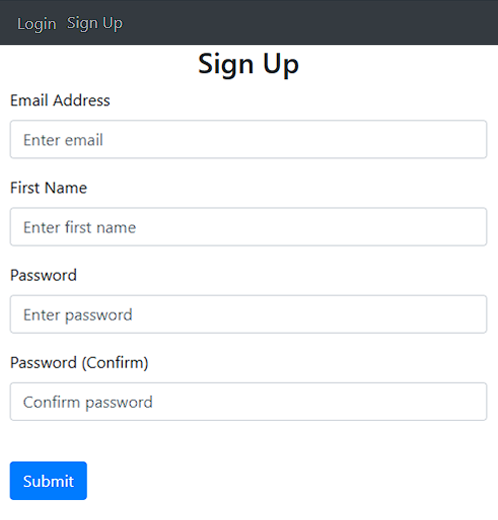
figures/registo.png
