eddygrinder/LaRE_LaTeX/figures/reles.png

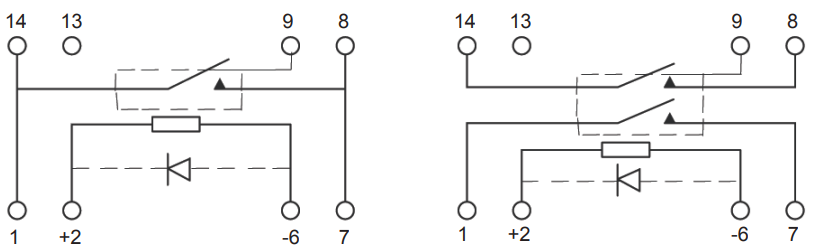
figures/reles.png
