eddygrinder/LaRE_LaTeX/figures/ripple_lab_1N4007.jpeg

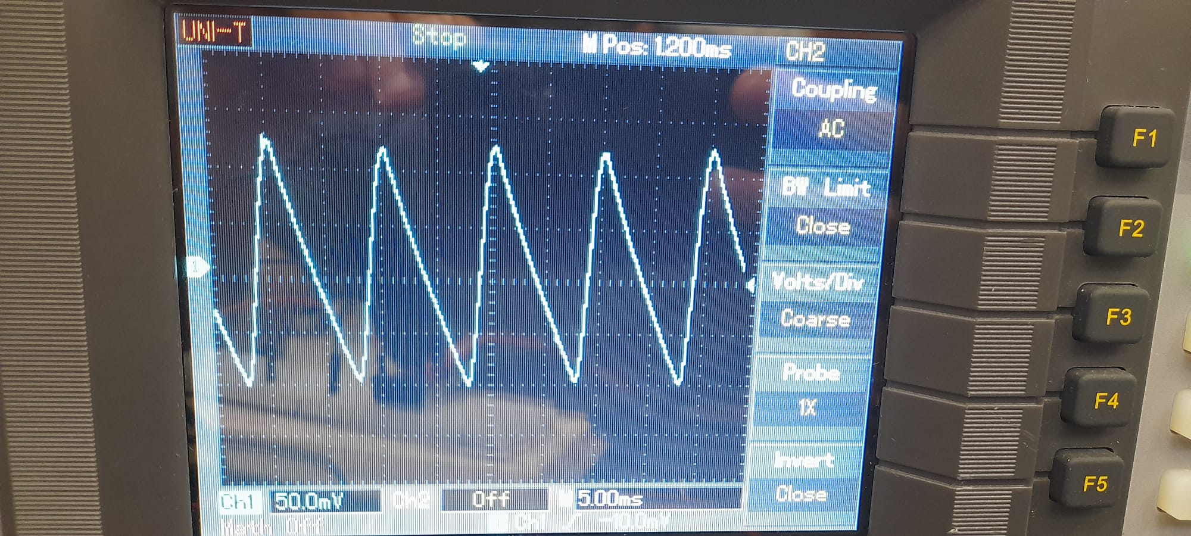
figures/ripple_lab_1N4007.jpeg
