eddygrinder/LaRE_LaTeX/figures/ripple_lab_ponte.jpeg

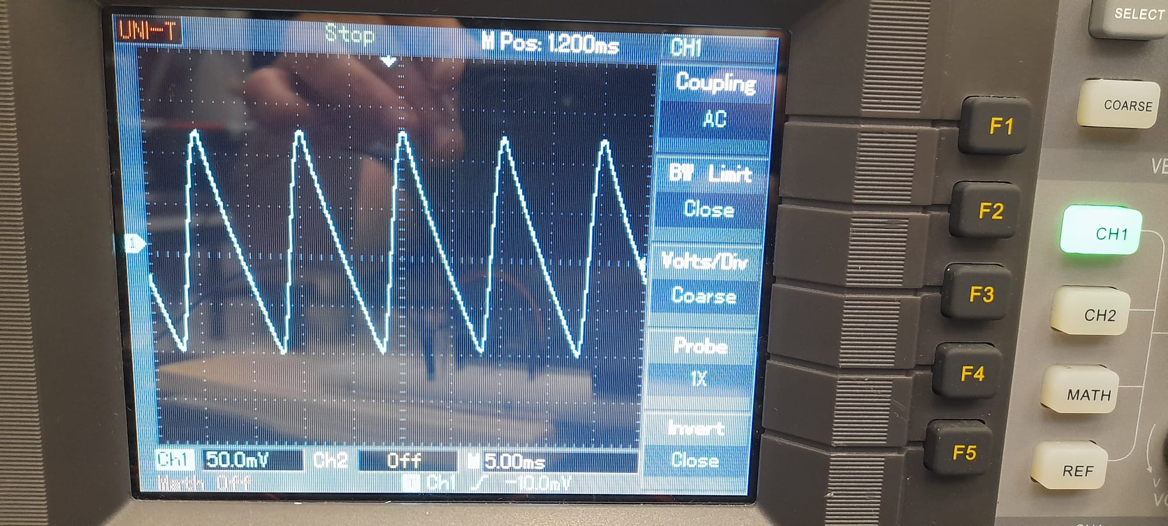
figures/ripple_lab_ponte.jpeg
