eddygrinder/LaRE_LaTeX/figures/ripple_lare_MO-2k2-100uF.png

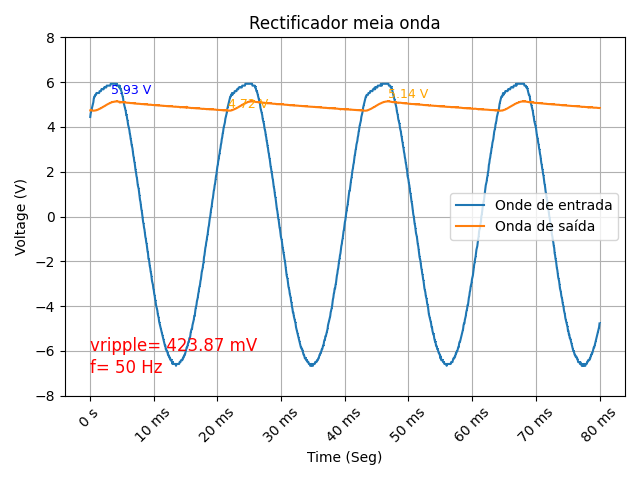
figures/ripple_lare_MO-2k2-100uF.png
