eddygrinder/LaRE_LaTeX/figures/ripple_MO_2k2-100uF-50HZ.png

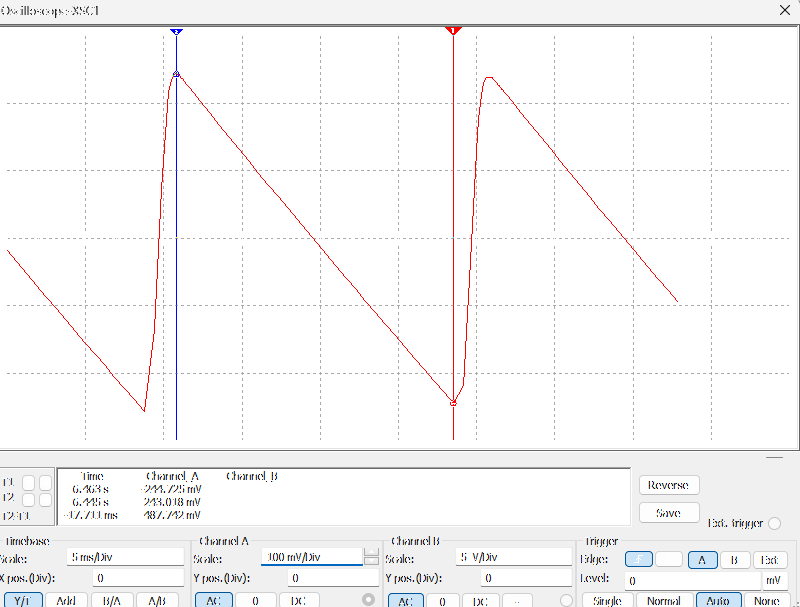
figures/ripple_MO_2k2-100uF-50HZ.png
