eddygrinder/LaRE_LaTeX/figures/ripple_multisim_MO-2k2-100uF.png

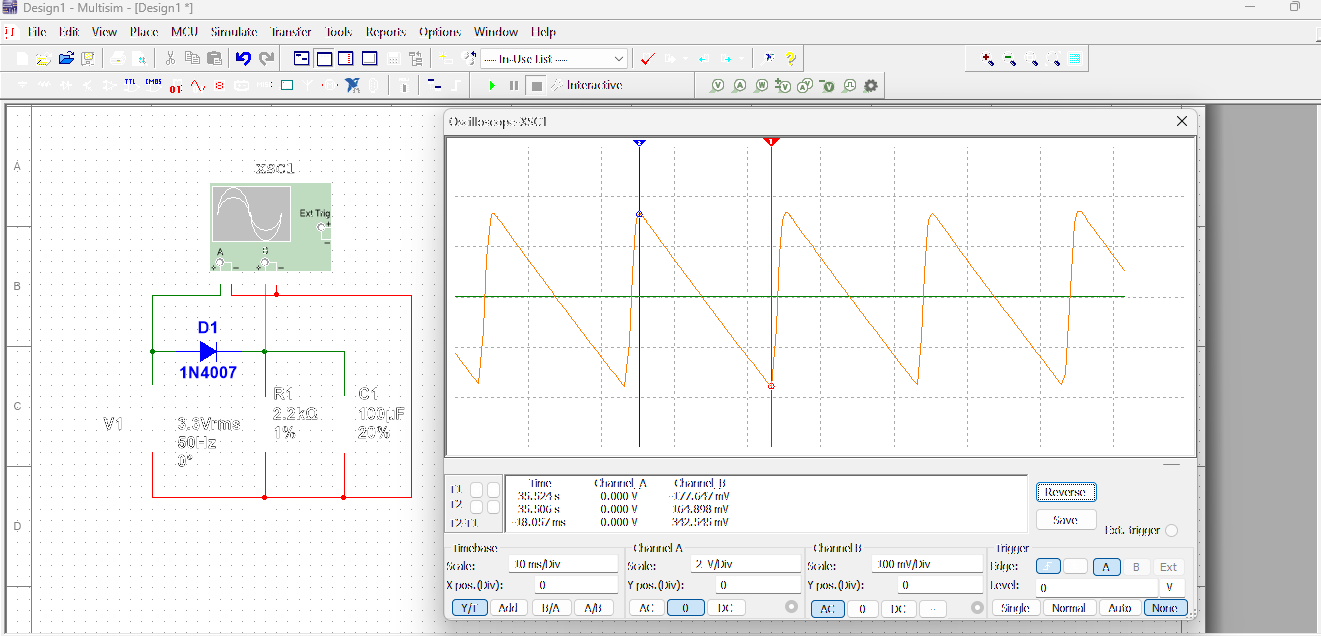
figures/ripple_multisim_MO-2k2-100uF.png
