eddygrinder/LaRE_LaTeX/figures/ripple_OC_2k2-100u.png

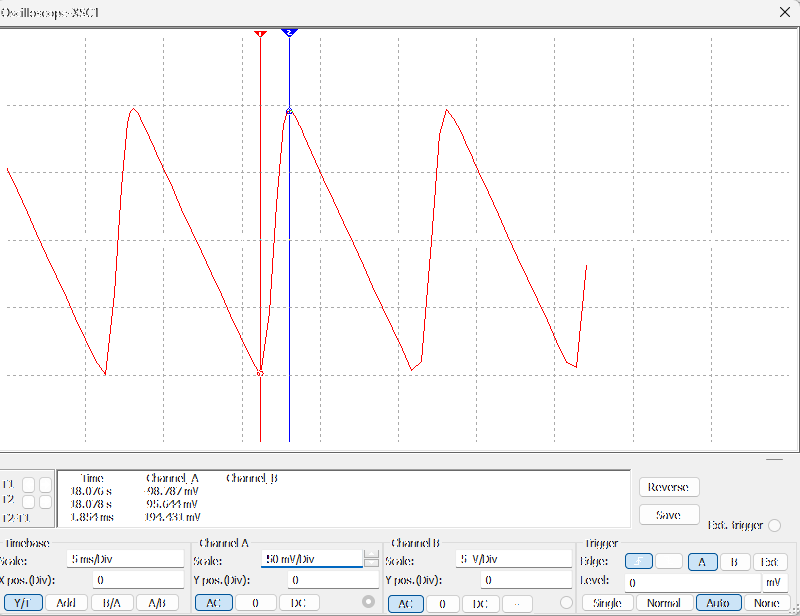
figures/ripple_OC_2k2-100u.png
