eddygrinder/LaRE_LaTeX/figures/ripple_práctica_MO-2k2-100uF.png

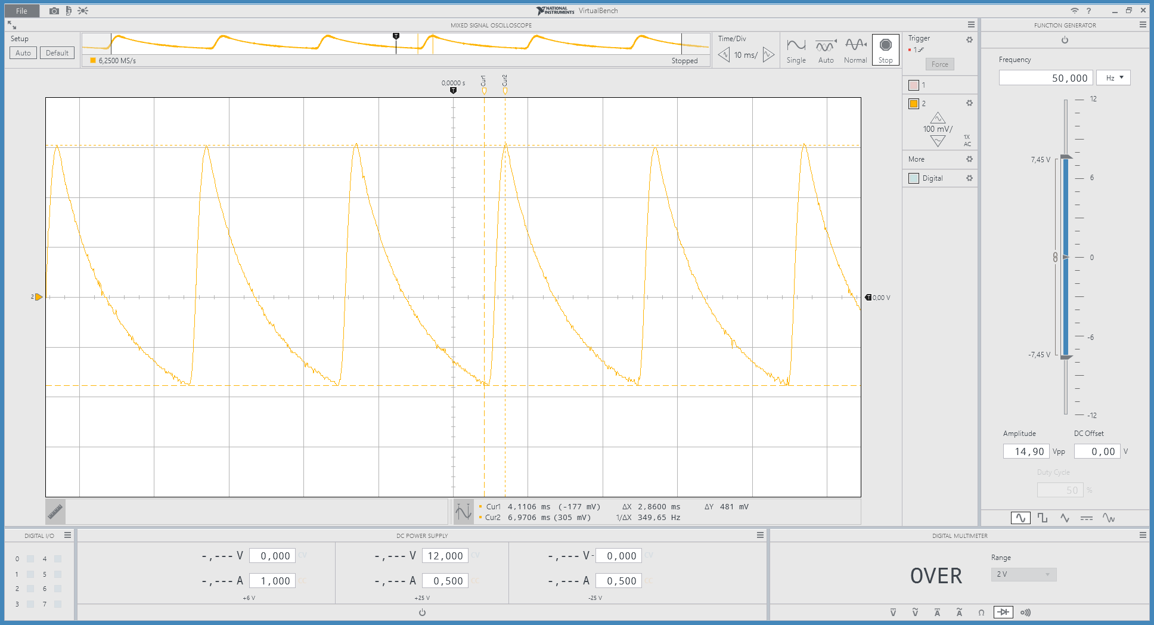
figures/ripple_práctica_MO-2k2-100uF.png
