eddygrinder/LaRE_LaTeX/figures/sch-ondacompleta-massa.png

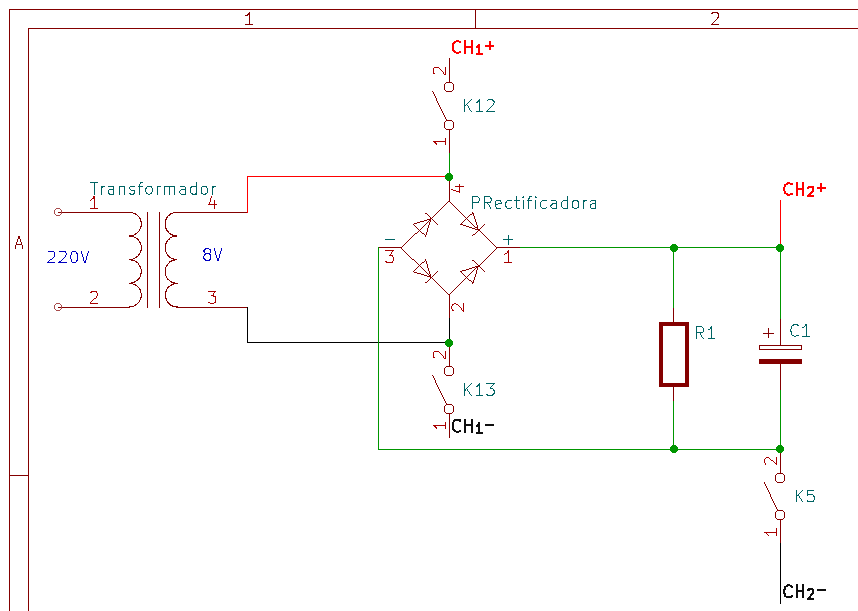
figures/sch-ondacompleta-massa.png
