eddygrinder/LaRE_LaTeX/figures/sch_completa_CC.png

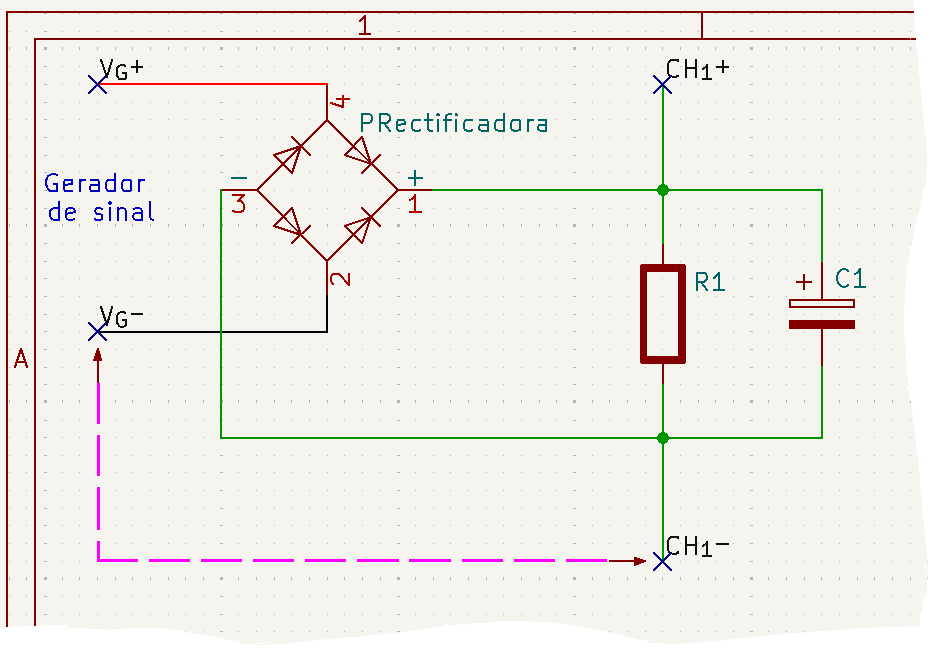
figures/sch_completa_CC.png
