eddygrinder/LaRE_LaTeX/figures/sch_fonte5V.png

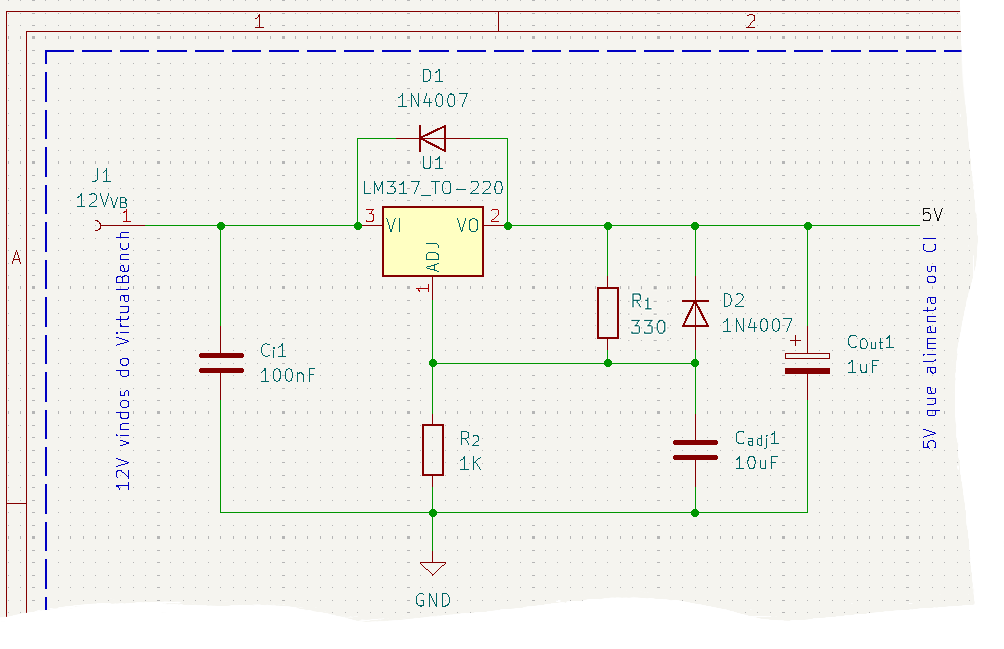
figures/sch_fonte5V.png
