eddygrinder/LaRE_LaTeX/figures/sch_fonte5VB.png

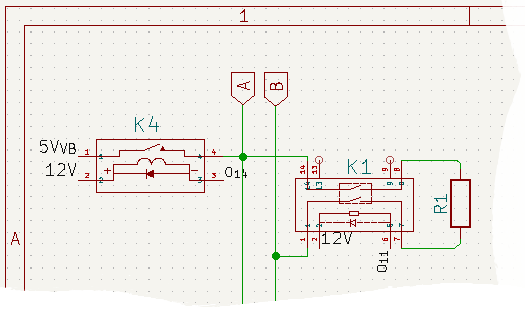
figures/sch_fonte5VB.png
