eddygrinder/LaRE_LaTeX/figures/sch_fonte12V.png

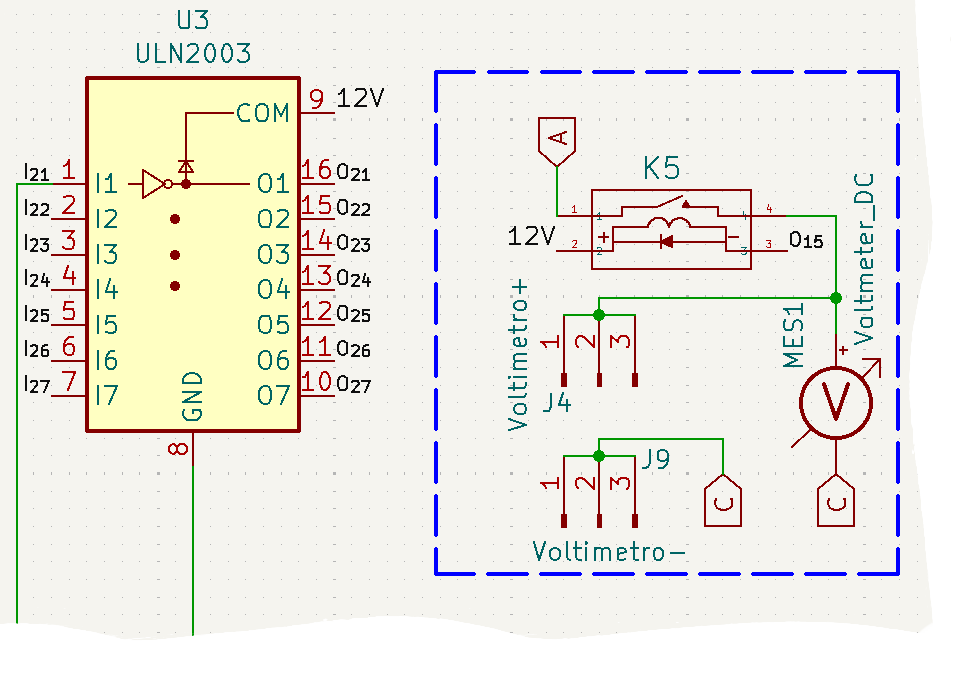
figures/sch_fonte12V.png
