eddygrinder/LaRE_LaTeX/figures/sch_meia-onda_modificado.png

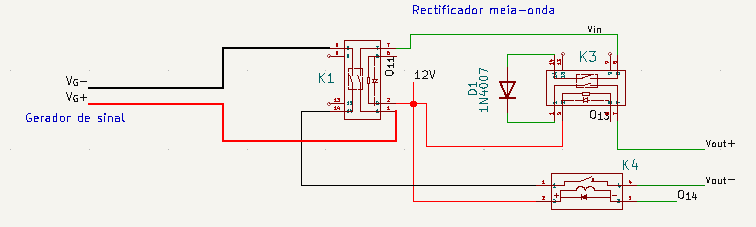
figures/sch_meia-onda_modificado.png
