eddygrinder/LaRE_LaTeX/figures/schematicMO_2k2-100uf_50HZ.png

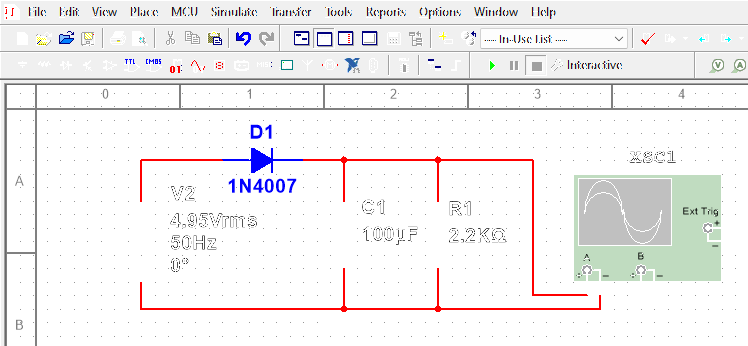
figures/schematicMO_2k2-100uf_50HZ.png
