eddygrinder/LaRE_LaTeX/figures/schematicOC_2k2-100uf.png

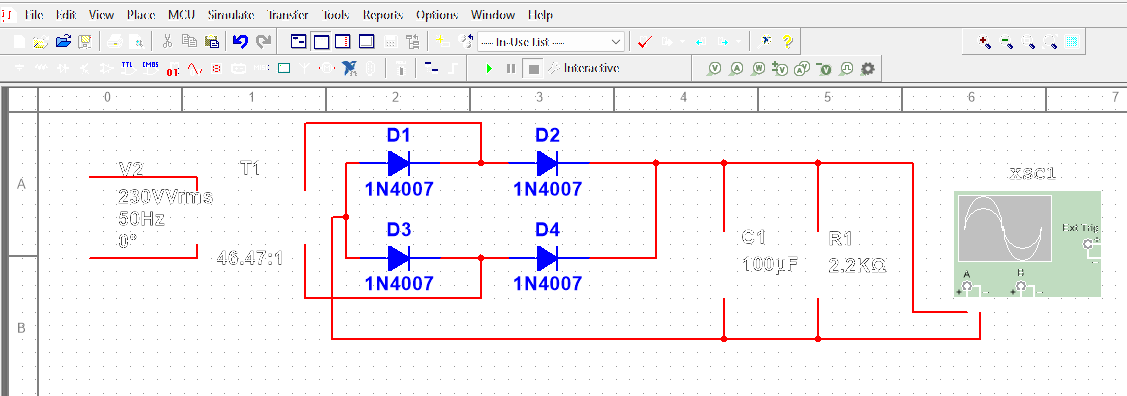
figures/schematicOC_2k2-100uf.png
