eddygrinder/LaRE_LaTeX/figures/Sedra_BodeFPA.png

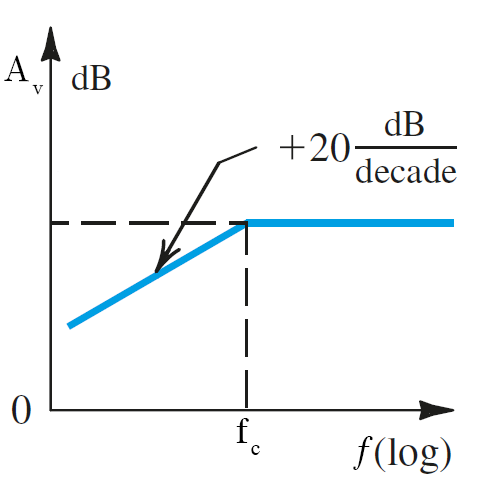
figures/Sedra_BodeFPA.png
