eddygrinder/LaRE_LaTeX/figures/Sedra_BodeFPB.png

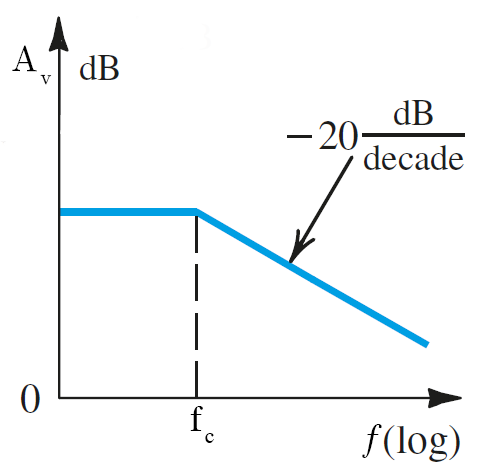
figures/Sedra_BodeFPB.png
