eddygrinder/LaRE_LaTeX/figures/Sedra_FPA.png

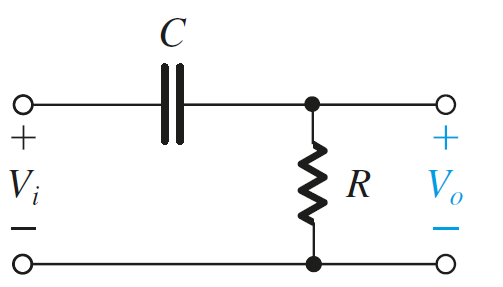
figures/Sedra_FPA.png
