eddygrinder/LaRE_LaTeX/figures/Sedra_FPA_GIMP.png

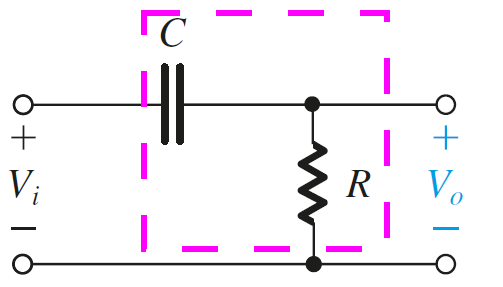
figures/Sedra_FPA_GIMP.png
