eddygrinder/LaRE_LaTeX/figures/Sedra_FPABode.png

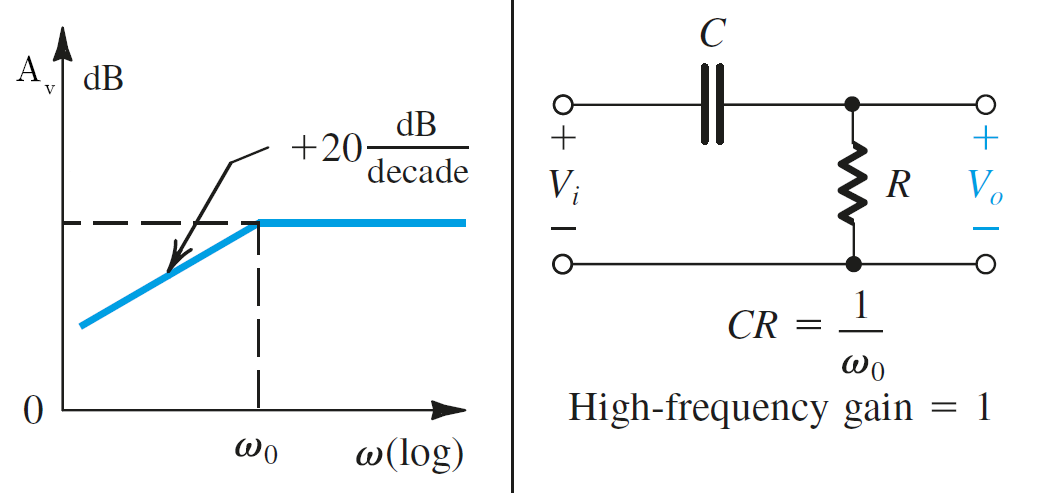
figures/Sedra_FPABode.png
