eddygrinder/LaRE_LaTeX/figures/Sedra_FPB.png

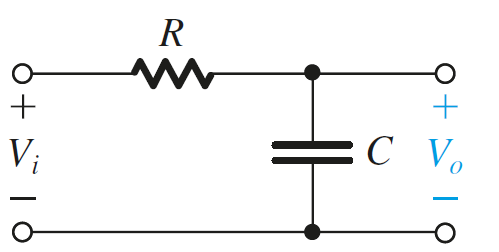
figures/Sedra_FPB.png
