eddygrinder/LaRE_LaTeX/figures/Sedra_FPB_GIMP.png

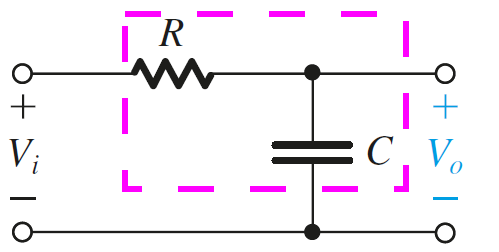
figures/Sedra_FPB_GIMP.png
