eddygrinder/LaRE_LaTeX/figures/Sedra_FPBBode.png

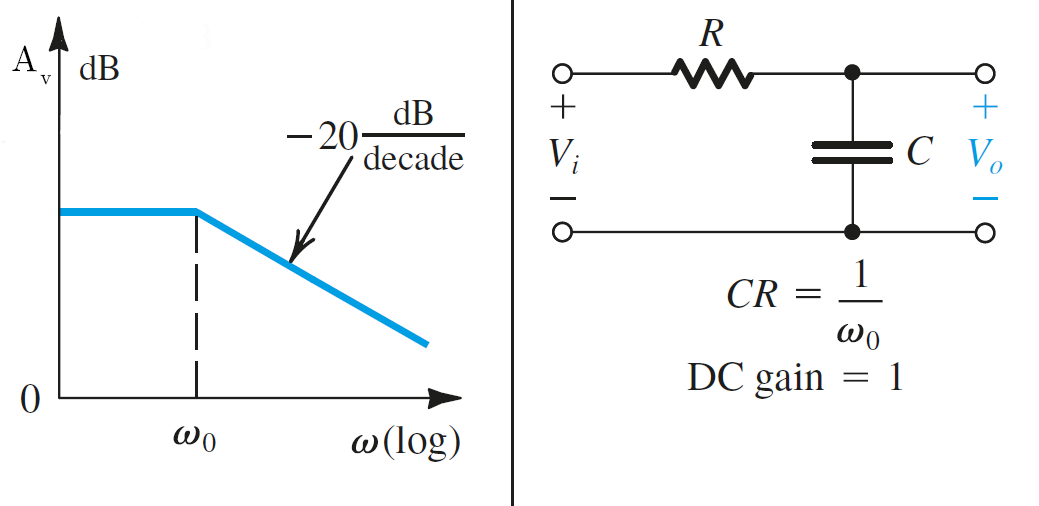
figures/Sedra_FPBBode.png
