eddygrinder/LaRE_LaTeX/figures/sedra_ripple.png

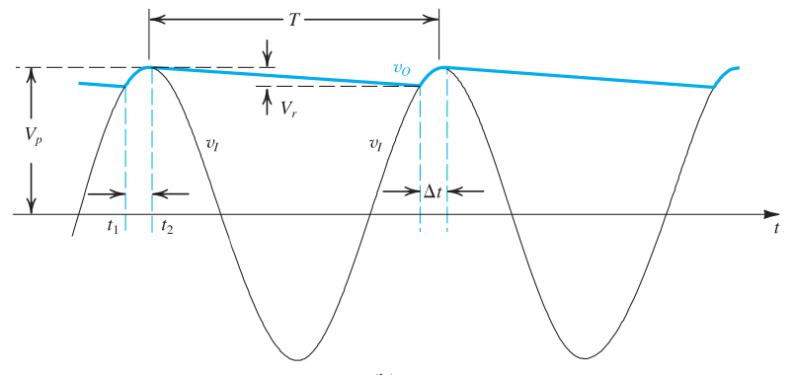
figures/sedra_ripple.png
