eddygrinder/LaRE_LaTeX/figures/sedra_ripple_OC.png

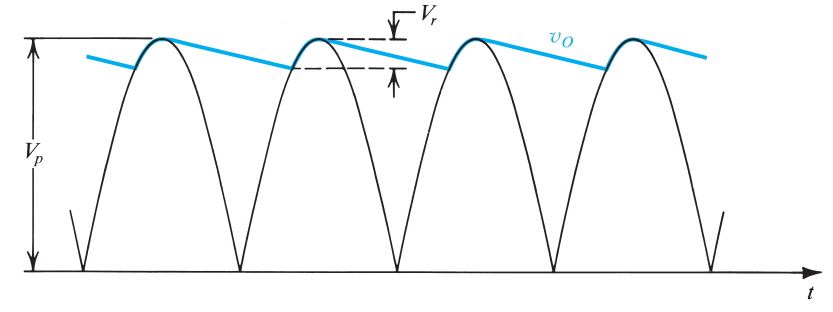
figures/sedra_ripple_OC.png
