eddygrinder/LaRE_LaTeX/figures/sej.jpg

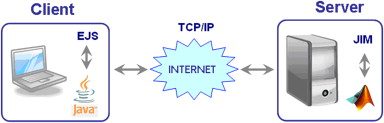
figures/sej.jpg
