eddygrinder/LaRE_LaTeX/figures/socketsdiagrama.png

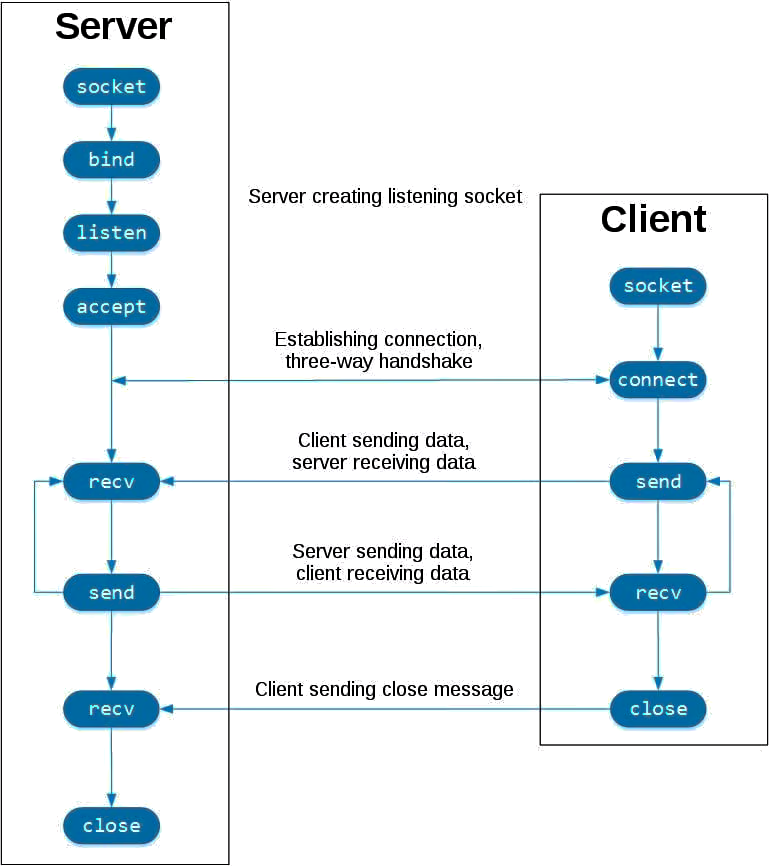
figures/socketsdiagrama.png
