eddygrinder/LaRE_LaTeX/figures/specs_PC104 copy.png

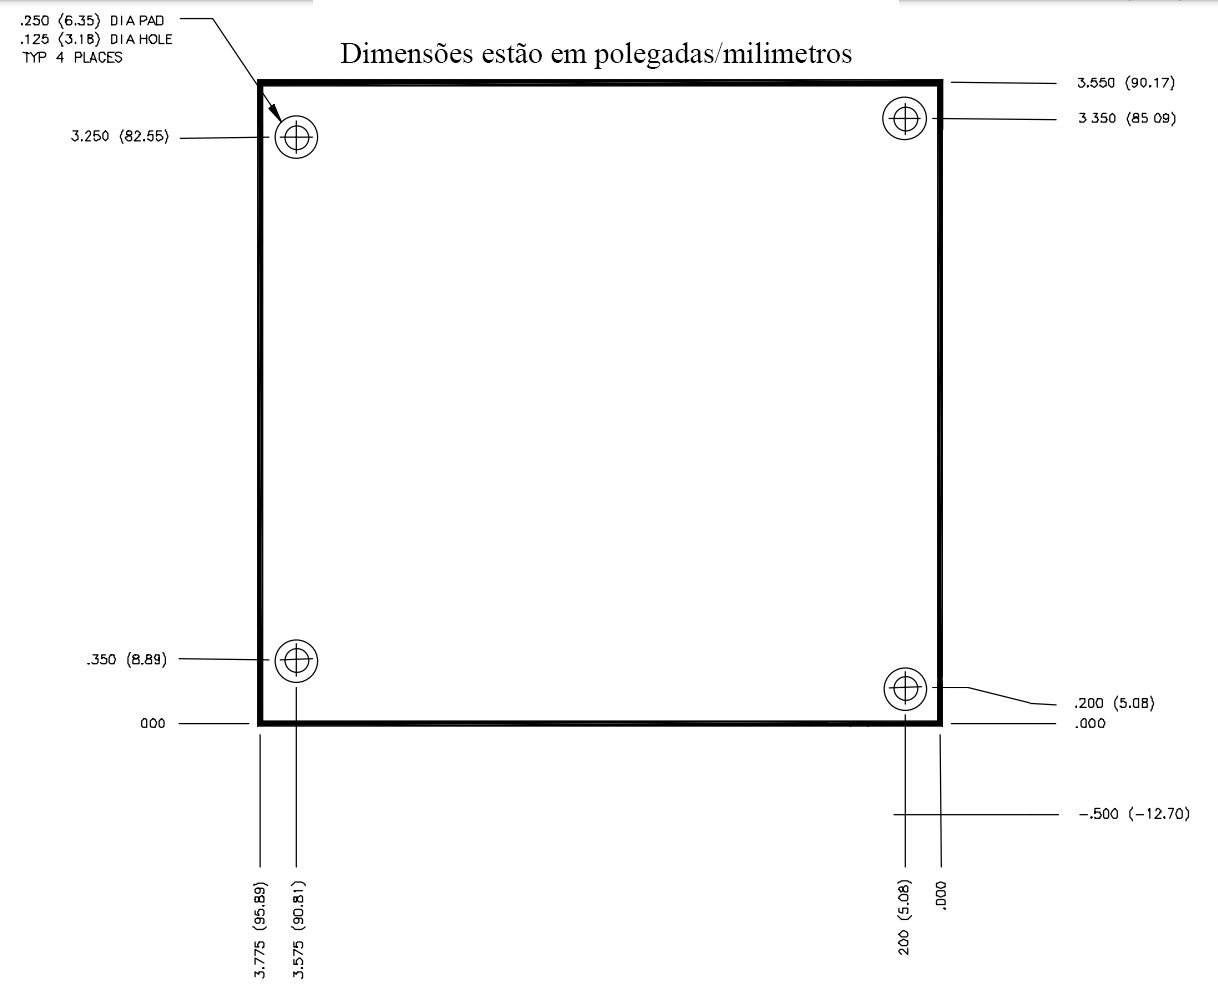
figures/specs_PC104 copy.png
