eddygrinder/LaRE_LaTeX/figures/SR_blocos.png

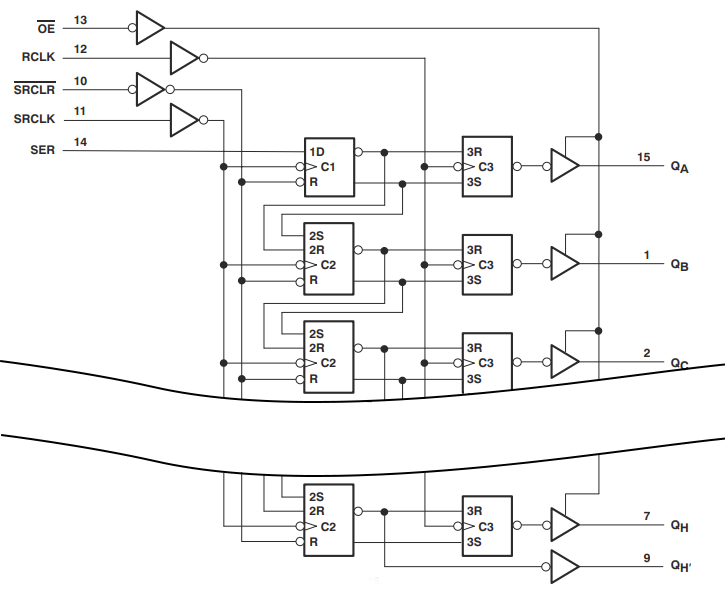
figures/SR_blocos.png
