eddygrinder/LaRE_LaTeX/figures/tinkercad.png

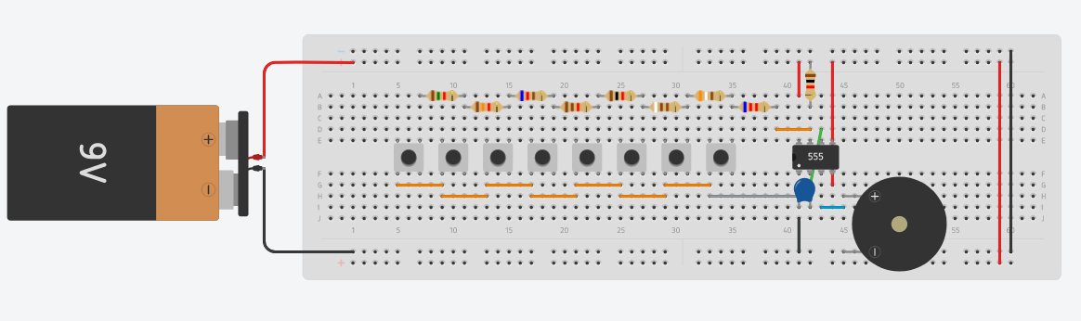
figures/tinkercad.png
