eddygrinder/LaRE_LaTeX/figures/tinkercad_exemplo.png

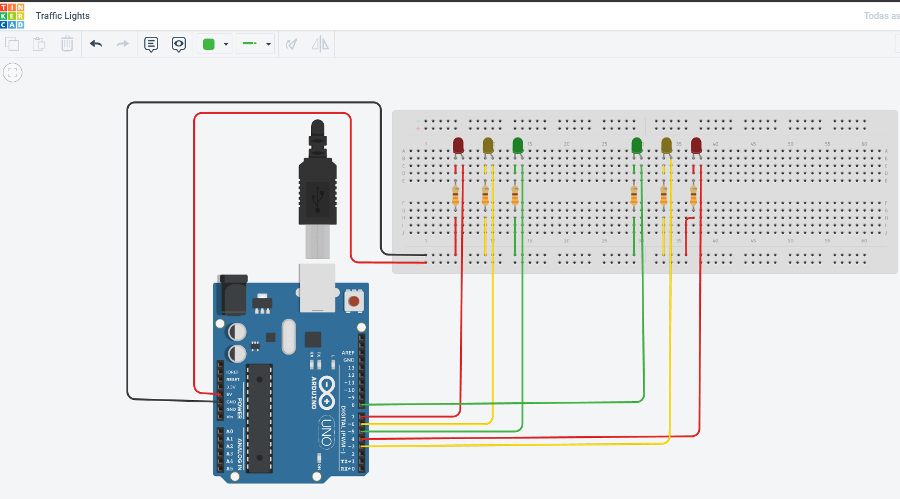
figures/tinkercad_exemplo.png
