eddygrinder/LaRE_LaTeX/figures/tinkercad_simulator.png

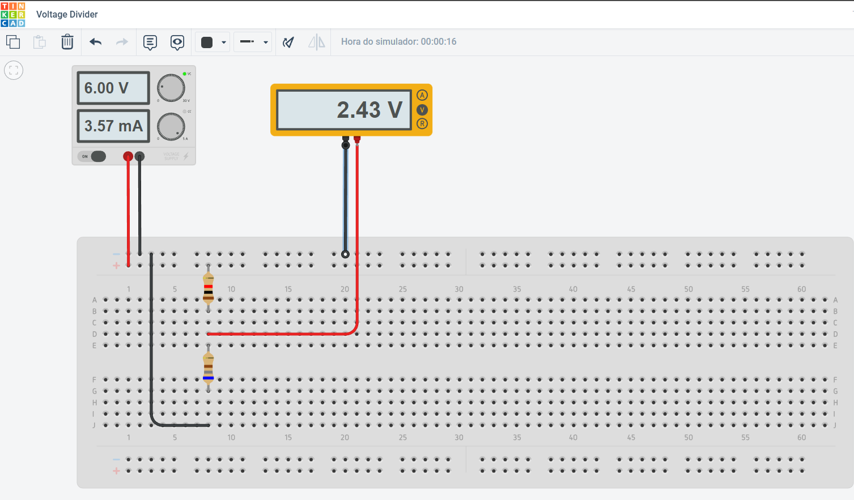
figures/tinkercad_simulator.png
