eddygrinder/LaRE_LaTeX/figures/tree_flask.png

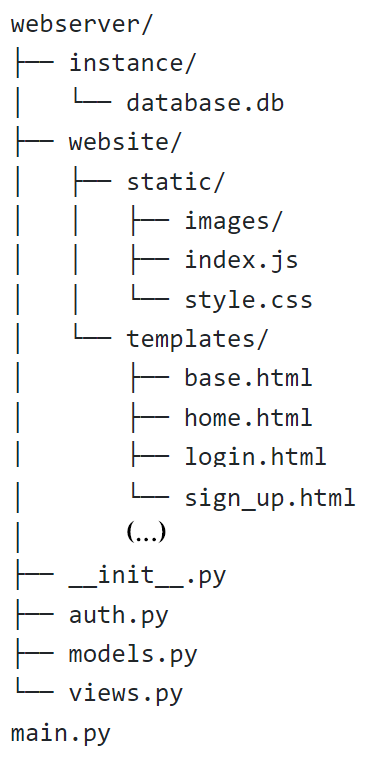
figures/tree_flask.png
