eddygrinder/LaRE_LaTeX/figures/VB8012-Desktop.png

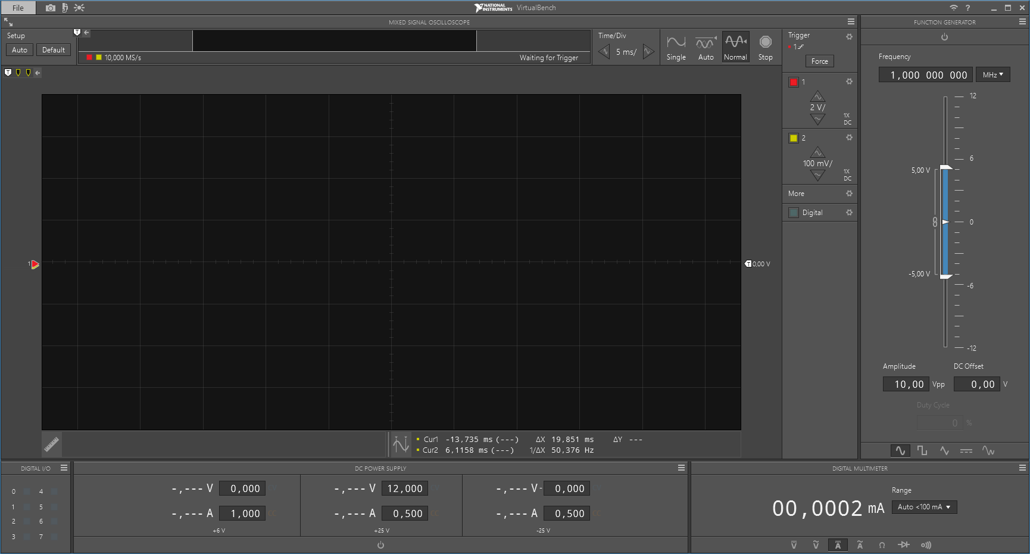
figures/VB8012-Desktop.png
