eddygrinder/LaRE_LaTeX/figures/virtualbench_back-panel.jpg

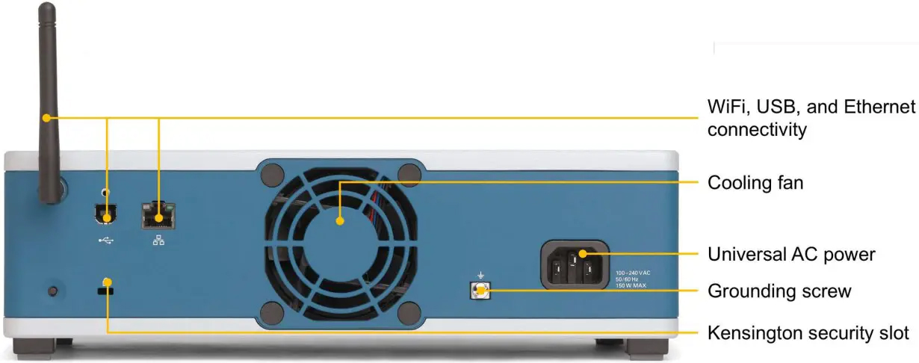
figures/virtualbench_back-panel.jpg
