eddygrinder/LaRE_LaTeX/figures/virtualbench_front-panel.jpg

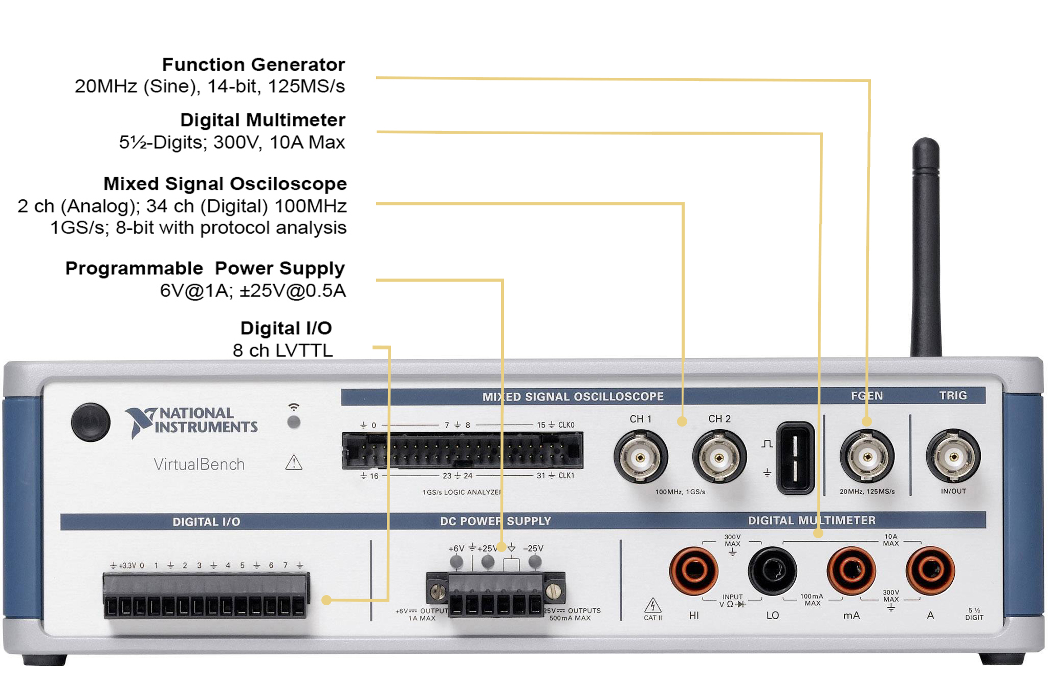
figures/virtualbench_front-panel.jpg
