eddygrinder/LaRE_LaTeX/figures/visir_ISEP.png

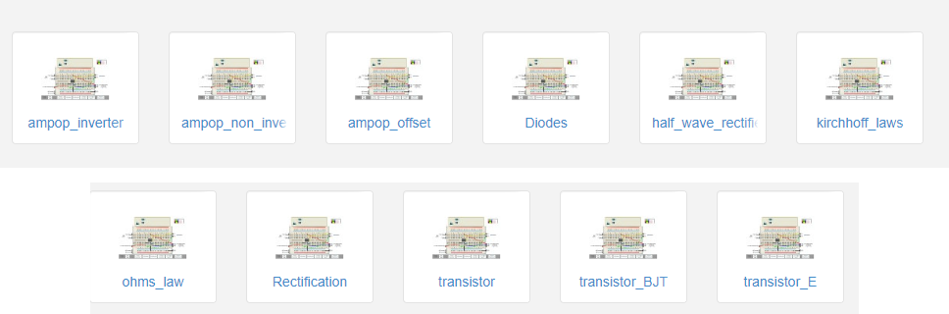
figures/visir_ISEP.png
