eddygrinder/LaRE_LaTeX/figures/visir_osc.png

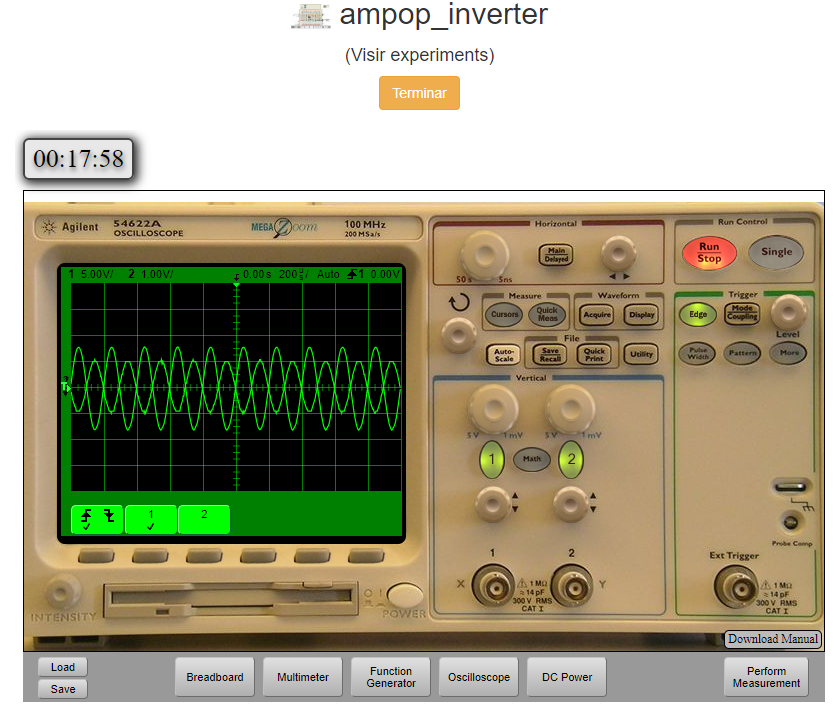
figures/visir_osc.png
