eddygrinder/LaRE_LaTeX/figures/visir_sch.png

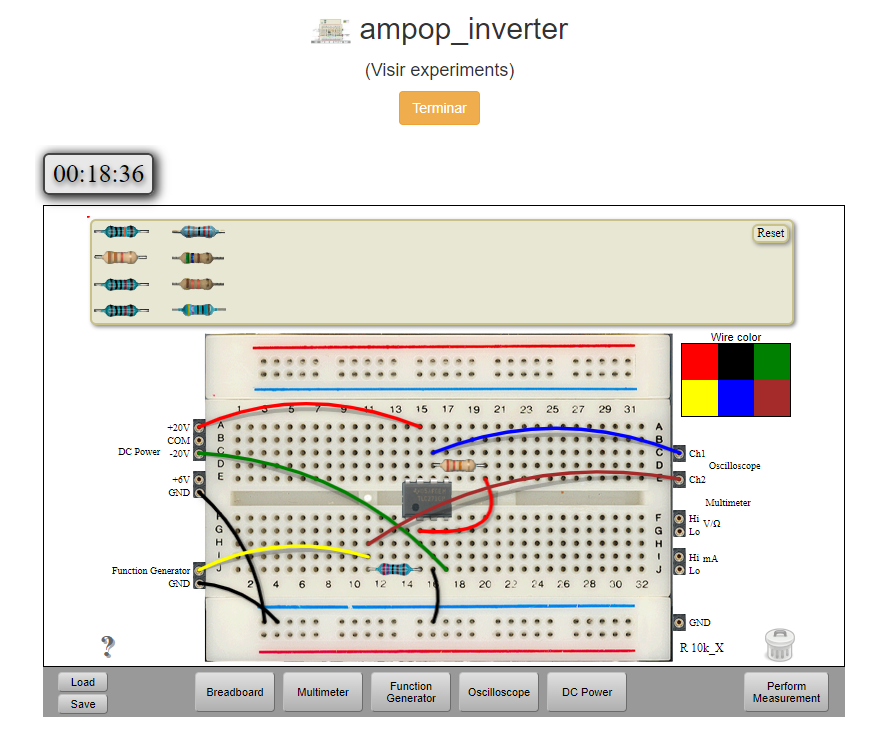
figures/visir_sch.png
