eddygrinder/LaRE_LaTeX/figures/visirISEP.jpeg

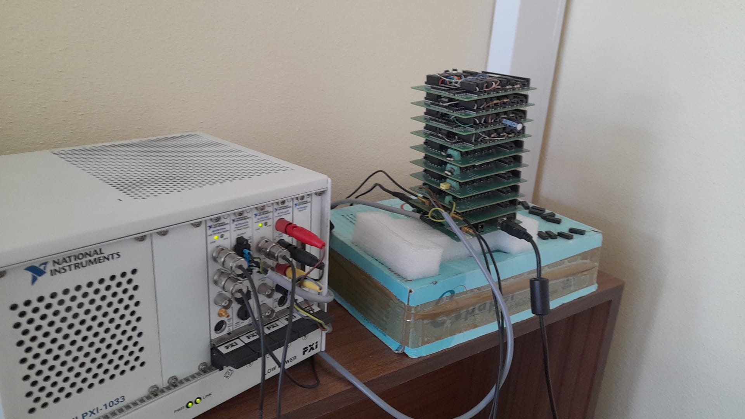
figures/visirISEP.jpeg
