eddygrinder/LaRE_LaTeX/figures/wokwi.png

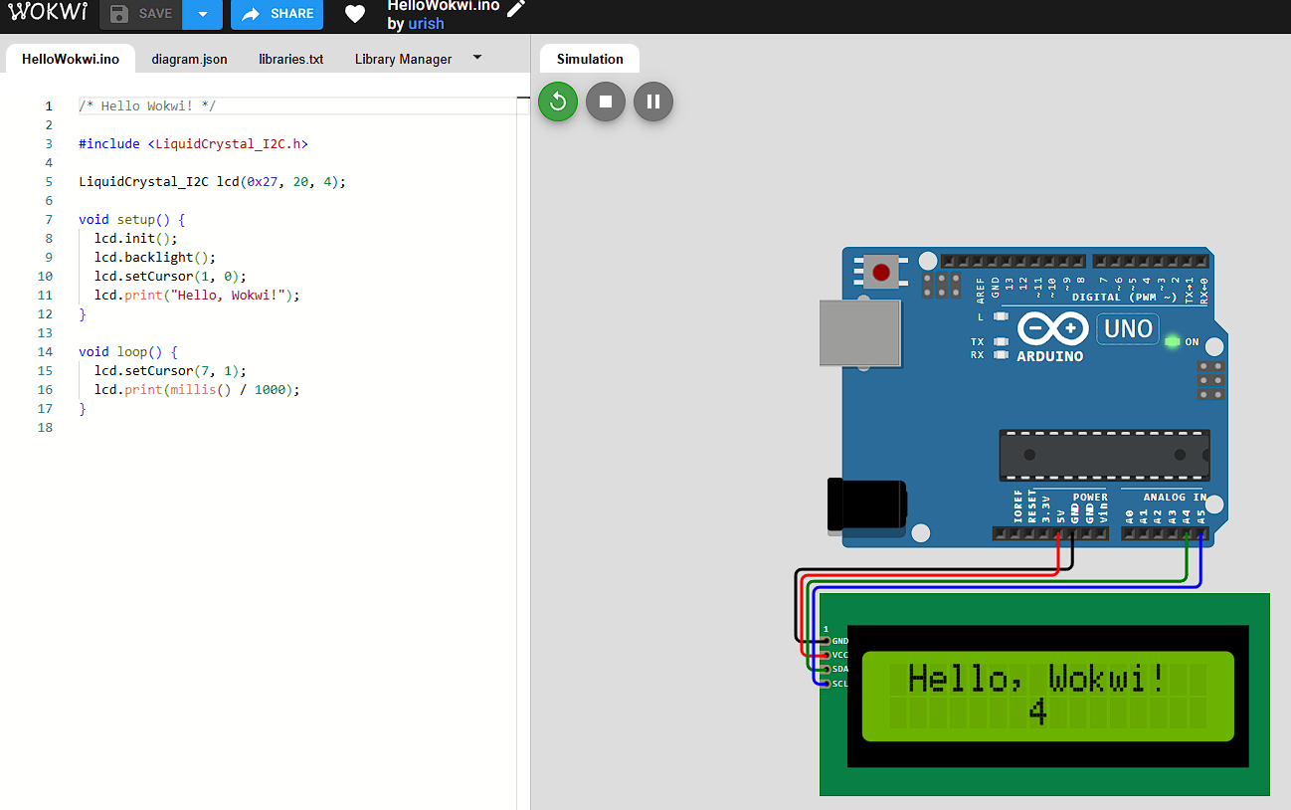
figures/wokwi.png
