eddygrinder/LaRE_LaTeX/figures/OHM_resultado_circuitlab.png

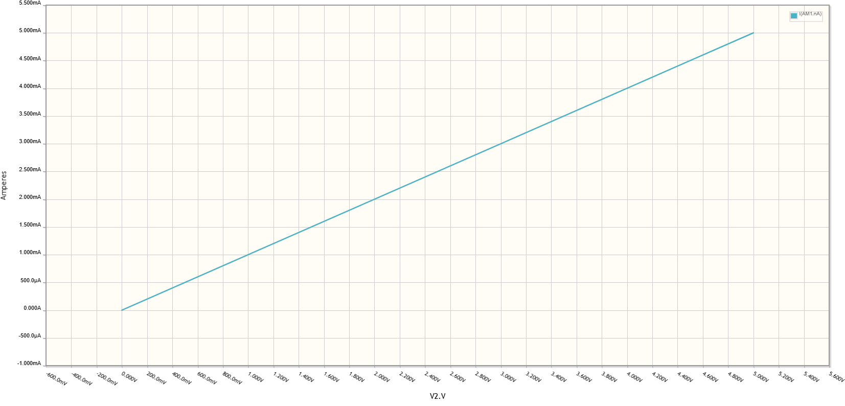
figures/OHM_resultado_circuitlab.png
