eddygrinder/LaRE_LaTeX/figures/OHM_resultado_multisim.png

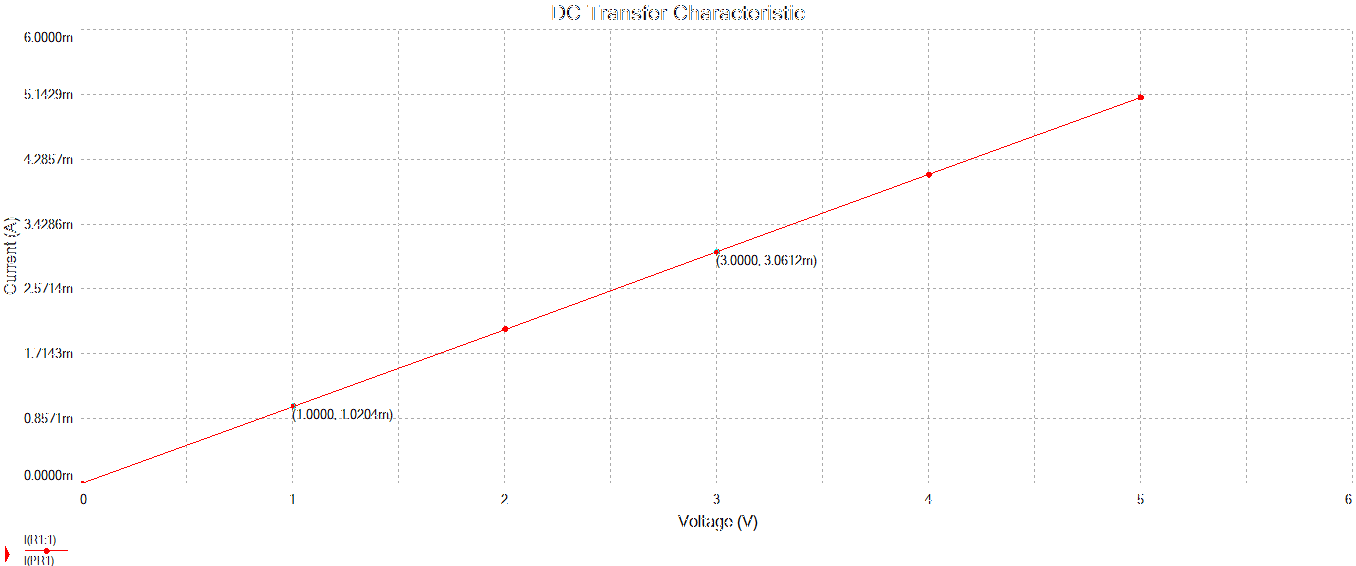
figures/OHM_resultado_multisim.png
