eddygrinder/LaRE_LaTeX/figures/resultado_meiaonda_200Hz.png

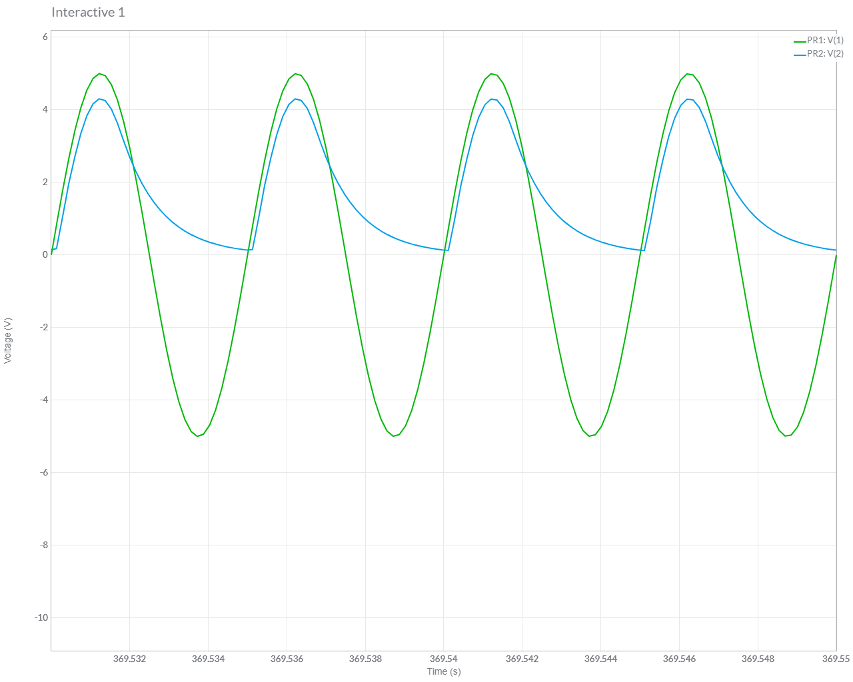
figures/resultado_meiaonda_200Hz.png
