eddygrinder/LaRE_LaTeX/figures/resultados_medicoes_ohm.png

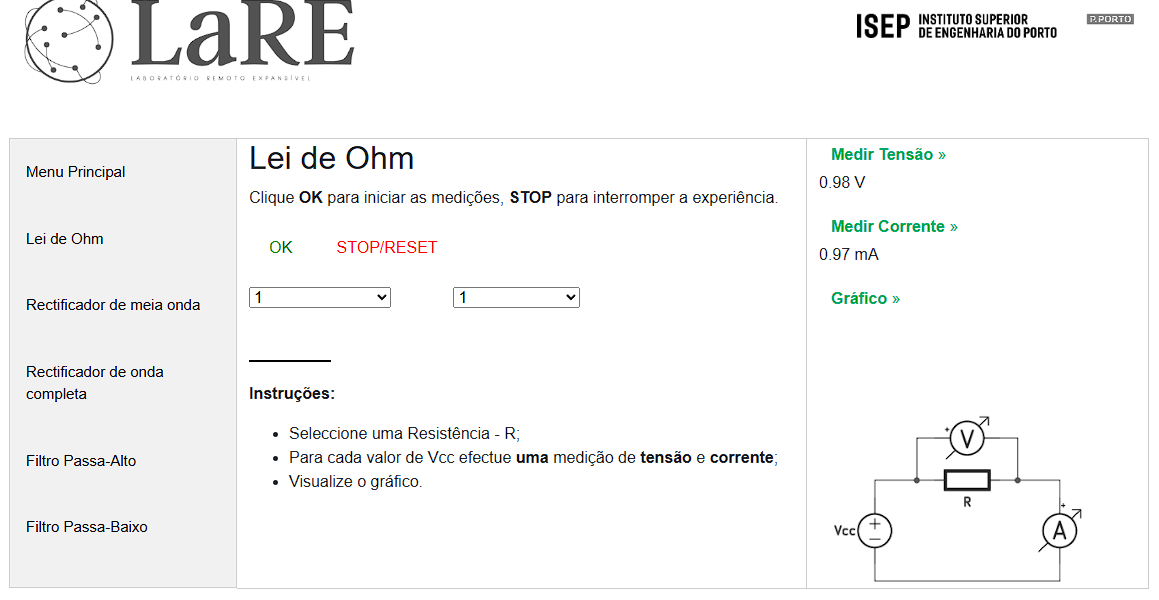
figures/resultados_medicoes_ohm.png
