eddygrinder/LaRE_LaTeX/figures/resultados_meia-onda.png

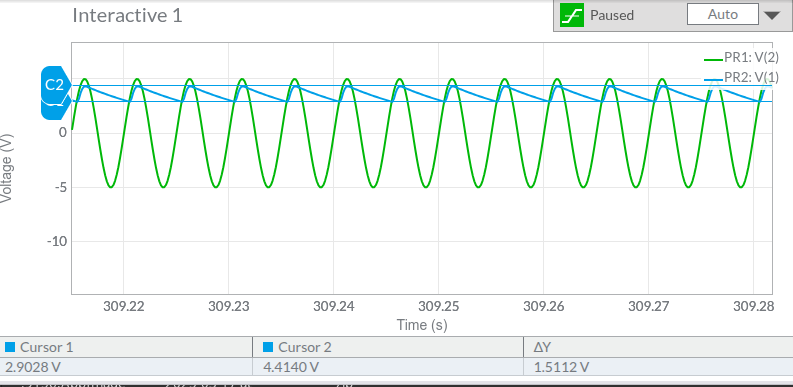
figures/resultados_meia-onda.png
