eddygrinder/LaRE_LaTeX/figures/fonte_sch.pdf

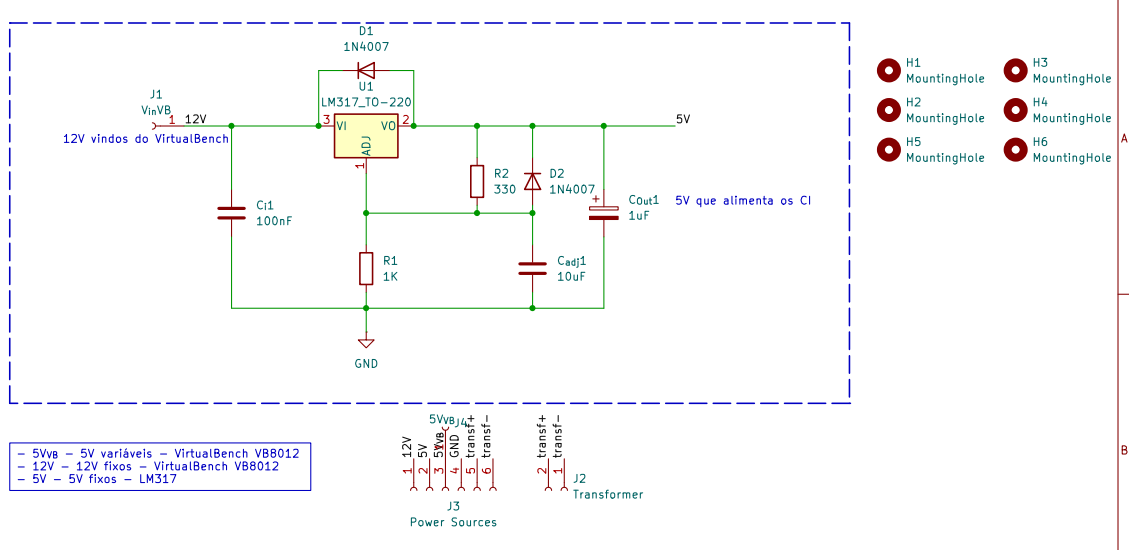
[picture p167: page 1]
