eddygrinder/LaRE_LaTeX/figures/LaRE-dimesoes_mecanicas.pdf

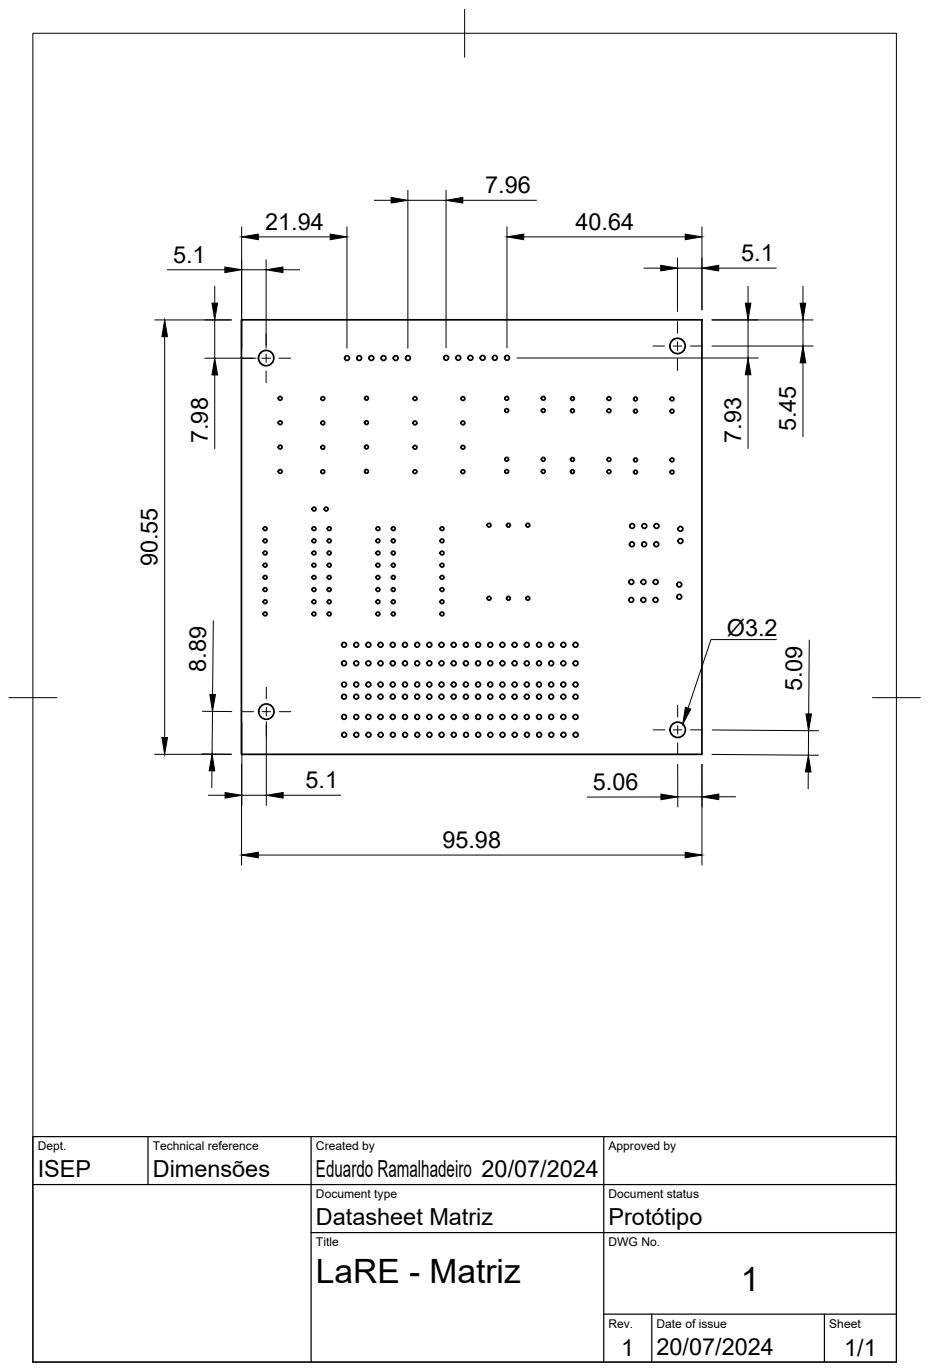
[picture p168: page 1]
ISEP; Dimensões; Eduardo Ramalhadeiro 90.55

Dept. | Technical reference | Created by 20/07/2024 | Approved by

Document type Datasheet Matriz | Document status Protótipo

Title LaRE - Matriz | DWG No. 1

Rev. 1 | Date of issue 20/07/2024 | Sheet 1/1
