eddygrinder/LaRE_LaTeX/figures/ohm_sch.pdf

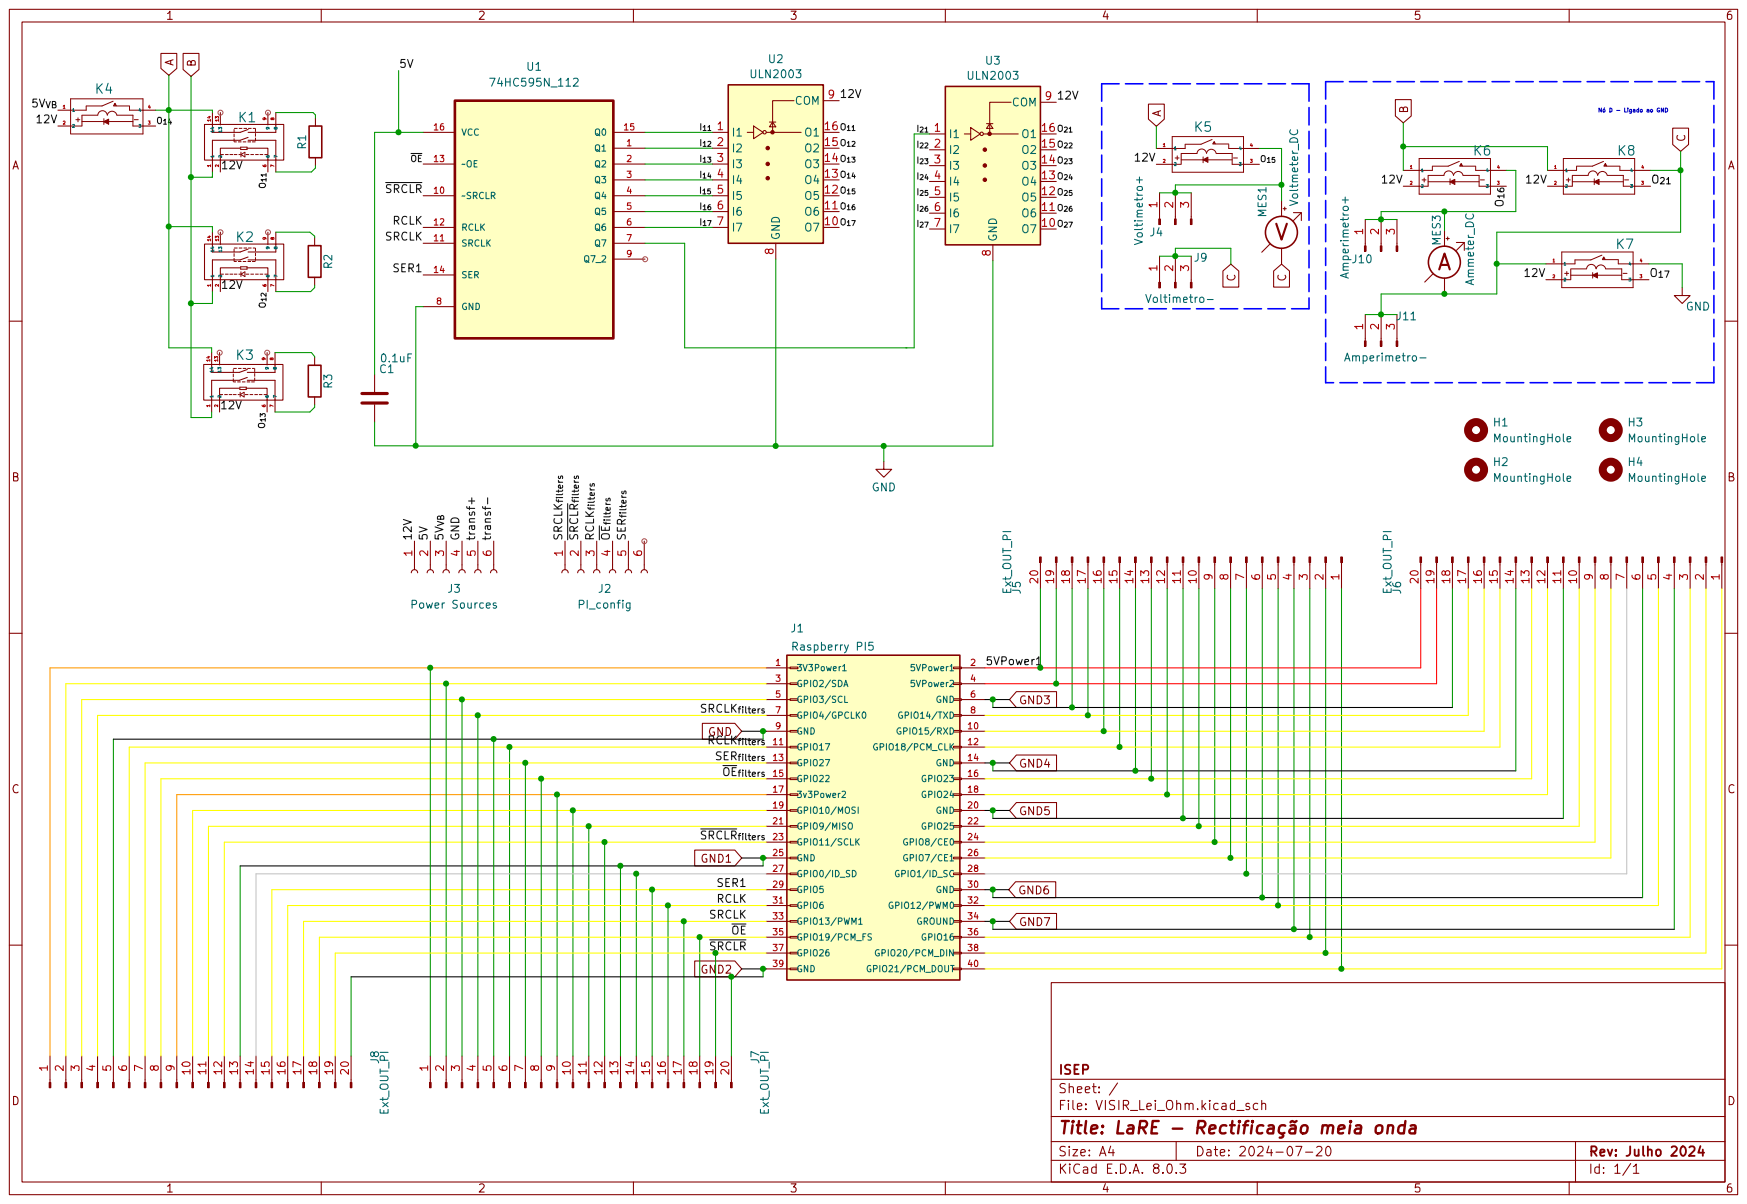
[picture p169: page 1]
