eddygrinder/LaRE_LaTeX/figures/rectificacao_sch.pdf

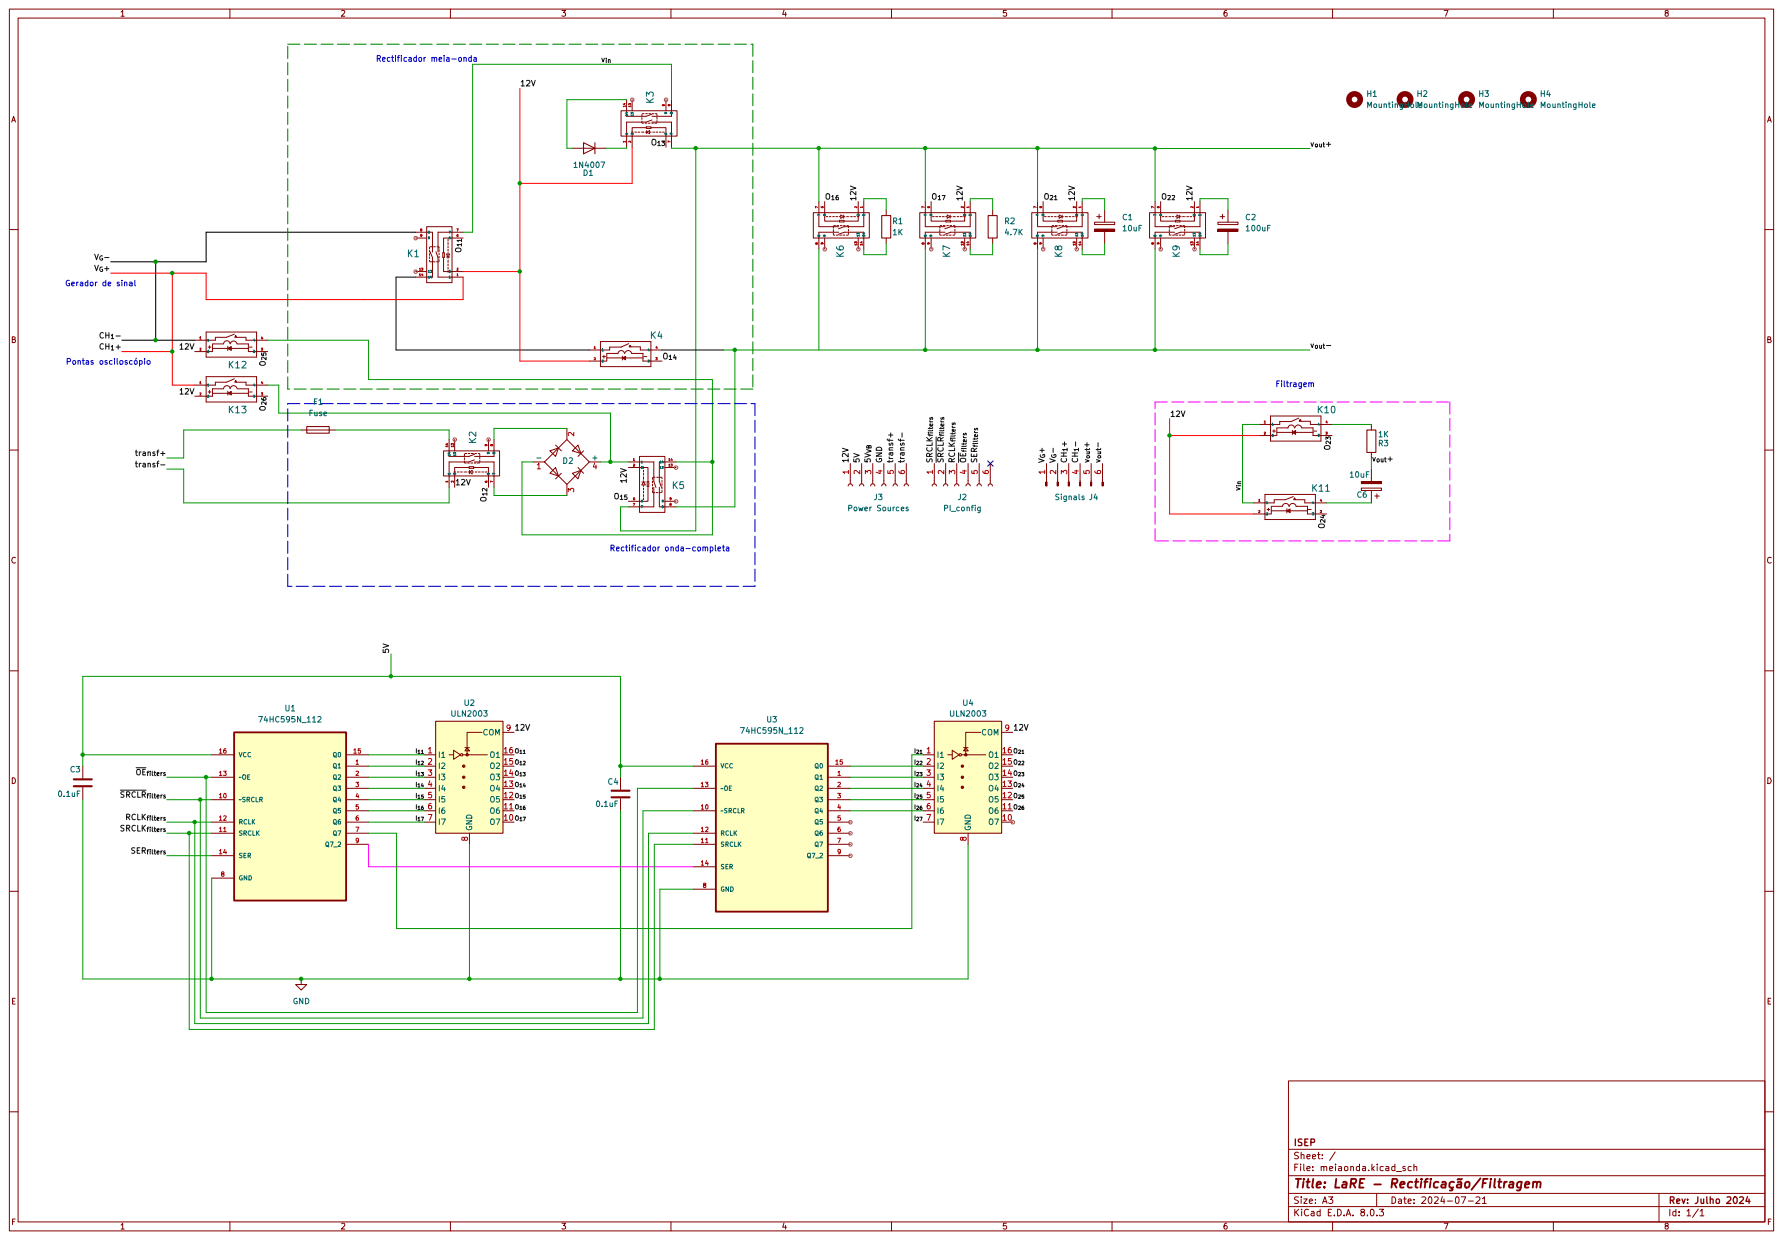
[picture p170: page 1]
