eddygrinder/LaRE_LaTeX/Esquemas_simplificados/meia_onda_simplificado.kicad_sch

## KiCad design Esquemas_simplificados/meia_onda_simplificado.kicad_sch (2025-01-15)

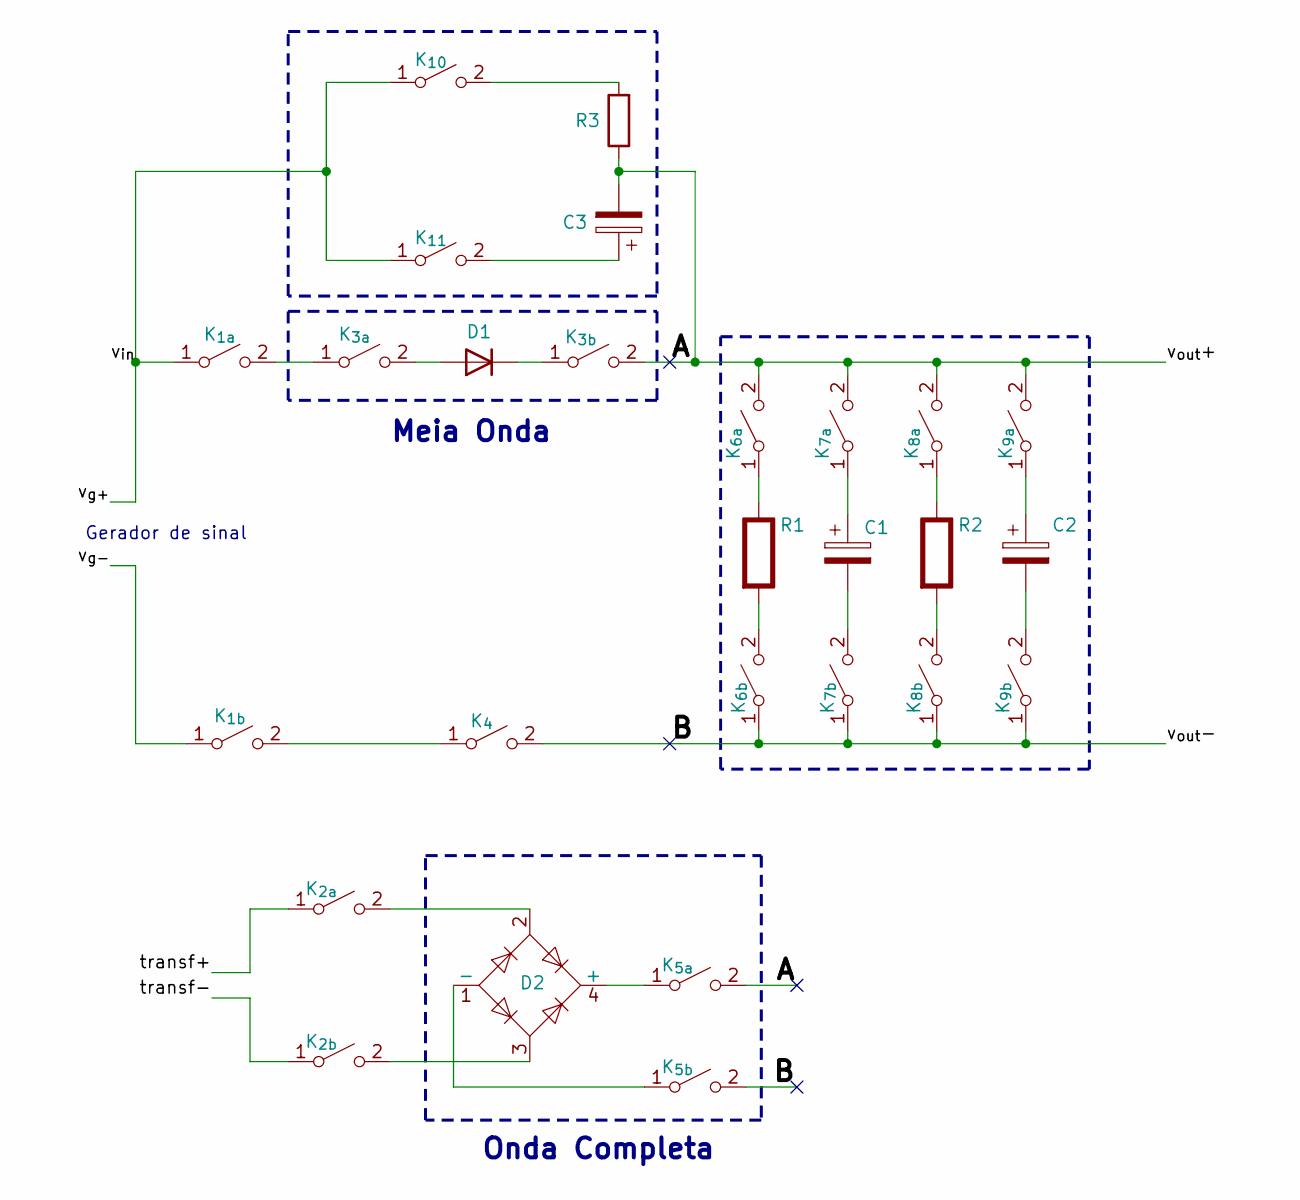
[picture p171: schematic meia_onda_simplificado.kicad_sch]

Parts:
C1, C2: 10uF; CP_Radial_D6.3mm_P2.50mm
C3: 10uF; CP_Radial_D5.0mm_P2.00mm
D1: 1N4007; D_DO-41_SOD81_P10.16mm_Horizontal
D2: B250C2300-1500A; Diode_Bridge_19.0x3.5x10.0mm_P5.0mm
K_{1a}, K_{1b}, K_{2a}, K_{2b}, K_{3a}, K_{3b}, K_{4}, K_{5a}, K_{5b}, K_{6a}, K_{6b}, K_{7a}, K_{7b}, K_{8a}, K_{8b}, K_{9a}, K_{9b}, K_{10}, K_{11}: SW_SPST
R1, R2: R; Rating W
R3: 1K; R_Axial_DIN0207_L6.3mm_D2.5mm_P15.24mm_Horizontal

Connections:
A: C3.2, K_{3b}.2 (B), K_{5a}.2 (B), K_{6a}.2 (B), K_{7a}.2 (B), K_{8a}.2 (B), K_{9a}.2 (B), R3.1
B: K_{4}.2 (B), K_{5b}.2 (B), K_{6b}.1 (A), K_{7b}.1 (A), K_{8b}.1 (A), K_{9b}.1 (A)
unnamed: C1.1, K_{7a}.1 (A)
unnamed: C1.2, K_{7b}.2 (B)
unnamed: C2.1, K_{9a}.1 (A)
unnamed: C2.2, K_{9b}.2 (B)
unnamed: C3.1, K_{11}.2 (B)
unnamed: D1.1 (K), K_{3b}.1 (A)
unnamed: D1.2 (A), K_{3a}.2 (B)
unnamed: D2.1 (-), K_{5b}.1 (A)
unnamed: D2.2, K_{2a}.2 (B)
unnamed: D2.3, K_{2b}.2 (B)
unnamed: D2.4 (+), K_{5a}.1 (A)
unnamed: K_{1a}.2 (B), K_{3a}.1 (A)
unnamed: K_{1b}.2 (B), K_{4}.1 (A)
unnamed: K_{6a}.1 (A), R1.1 (+)
unnamed: K_{6b}.2 (B), R1.2 (-)
unnamed: K_{8a}.1 (A), R2.1 (+)
unnamed: K_{8b}.2 (B), R2.2 (-)
unnamed: K_{10}.2 (B), R3.2
transf+: K_{2a}.1 (A)
transf-: K_{2b}.1 (A)
v_{g+}: K_{1a}.1 (A), K_{10}.1 (A), K_{11}.1 (A)
v_{g-}: K_{1b}.1 (A)

Notes on the sheet:
Gerador de sinal
Onda Completa
Meia Onda
