eddygrinder/LaRE_LaTeX/(commit log)

2024-08-20 acrescentei duas imagens do fluxograma da lei de ohm
2024-08-20 update chapter 4, explicação lei de ohm
2024-08-20 update chapter 4 - explicação lei de ohm
2024-11-01 update cap 4 - o que fazer a seguir
2024-11-07 update cap4 - fontes de tensão
2024-11-08 update cap4 - fontes de alimentação
2024-11-08 update cap - fontes de alimentação
2024-11-13 update cap 4 - fontes de alimentação
2024-11-13 update cap4 - fonte de alimentação 5V
2024-11-14 update cap4 - fontes de alimentação. Fim 5V
2024-11-22 minor update cap4 fonte 220v
2024-11-27 update cap4 - problema de massas
2024-12-02 cap4 - update aparelhos de medida
2024-12-06 update cap 4 - fontes terminadas. Experiências, Lei de Ohm
2024-12-13 update esquema simplificado rectificador
    [meia_onda_simplificado.kicad_sch]
2024-12-13 update cap 4 - rectificadores
    [meia_onda_simplificado.kicad_sch]
2024-12-23 minor update rectificação de meia onda
2025-01-02 update rectificação cap 4
    [meia_onda_simplificado-6ea6en6.kicad_sch, meia_onda_simplificado.kicad_sch]
2025-01-07 update DRAFT rectificadores. Passar para os Filtros
2025-01-13 update chap 4 - filtros
    [meia_onda_simplificado.kicad_sch]
2025-01-15 update chap 4 - modificação do texto dos filtros e rectificadores
    [meia_onda_simplificado.kicad_sch]
2025-01-20 Update chap 4 - reorganização da estrutura entre hw e sw. Acrescentaram-se algumas notas para posterror organização do texto - "Experiências"
2025-02-05 update de alguns ficheiros secundários - KICAD
2025-02-10 update chap 4 - software lei de ohm
2025-02-13 update chap 4 - experiência lei de ohm e configVB
2025-02-19 update explicação da experiencia da lei de ohm
2025-02-21 update segunda etapa lei de ohm
2025-02-25 mudança na abordagem À descrição da experiência da lei de ohm
2025-03-07 remoção das listagens de código, nomeadamente, as que são relativamente extensas e que não são essenciais para a compreensão do texto. Referenciou-se a existência de código no repositório do projeto.
2025-03-11 minor update - rascunho do que fazer a seguir
2025-03-12 update - cap 4 experiência lei de ohm, explicação
2025-03-20 update cap 4 - lei de ohm
2025-03-20 update cap 4, lei de ohm, terminado o rascunho. Carece de revisão
2025-03-29 update - reorganização das secçõs fonte de alimentação
2025-04-01 update - mudanças importantes no datasheet que foi integrado no ApendixeA
2025-04-02 UPDATE HW, revisão quase feitra. passar para o SW
2025-04-06 update - fontes de alimentação e placas
2025-04-24 UPDATE:cap5, resultados Lei de Ohm
2025-04-29 Update - fim análise de resultados Ohm
2025-05-01 update cap 5 - análise de resultados: rectificadores
2025-05-02 update - upload de imagens dos resultados experimentais
2025-05-02 update - Envio para revisão - 03-05
2025-05-03 update - Cap 5, só falta a onda completa. Documento desta versão enviado para revisão
2025-06-04 update diagrama de blocos fonte de alimentação
2025-06-25 UPDATE cap5 - refeitos os testes da meia onda para condizerem com os valores da onda completa. Faltam os testes ao LaRE
2025-06-26 Cap 5 renviado para revisão
2025-06-30 capitulo 6 terminado - à espera de revisão do prof
2025-07-17 documento prácticamente completo, enviado para revisão
2025-07-24 Final! - Enviar para CSA corrigir
2025-09-04 nada de especial
